RailEduKit/SigLab-3Dmodels/images/renders/balise_back.png

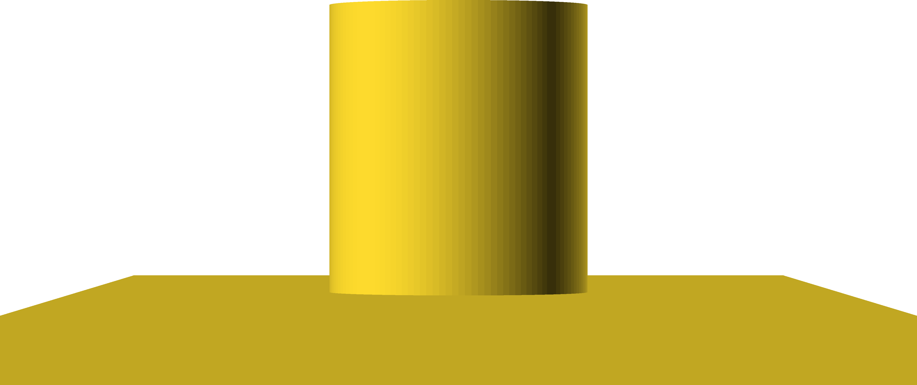
images/renders/balise_back.png
