RailEduKit/SigLab-3Dmodels/images/renders/balise_isometric.png

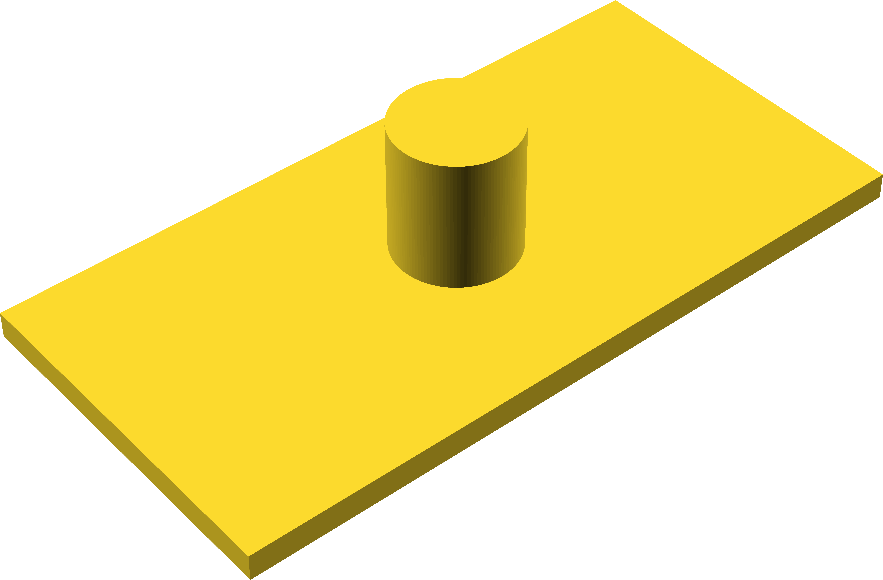
images/renders/balise_isometric.png
