RailEduKit/SigLab-3Dmodels/images/renders/balise_left.png

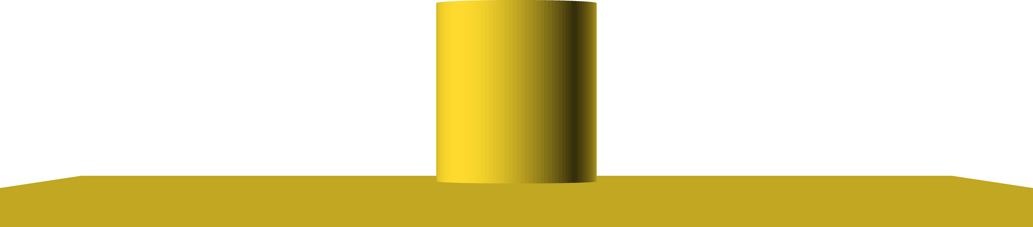
images/renders/balise_left.png
