RailEduKit/SigLab-3Dmodels/images/renders/checkbox_route_back.png

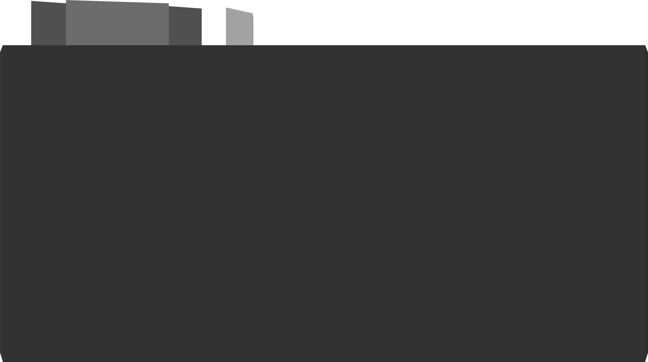
images/renders/checkbox_route_back.png
