RailEduKit/SigLab-3Dmodels/images/renders/checkbox_route_bottom.png

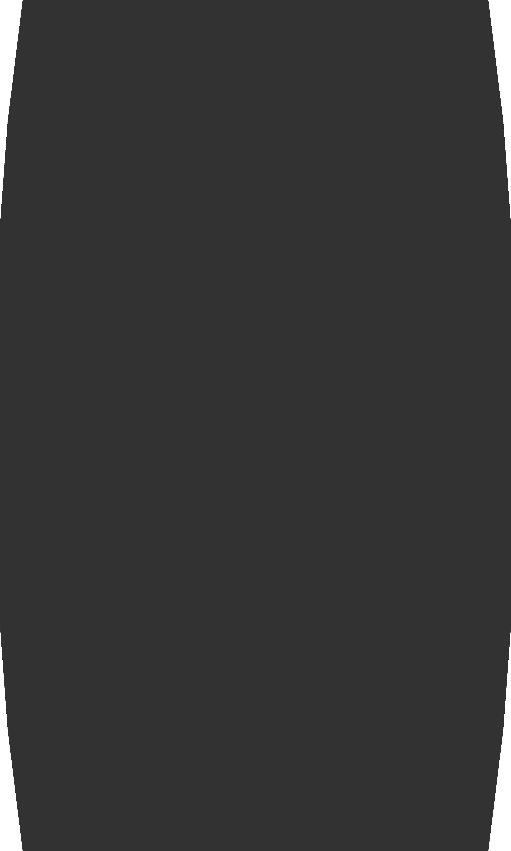
images/renders/checkbox_route_bottom.png
