RailEduKit/SigLab-3Dmodels/images/renders/checkbox_route_left.png

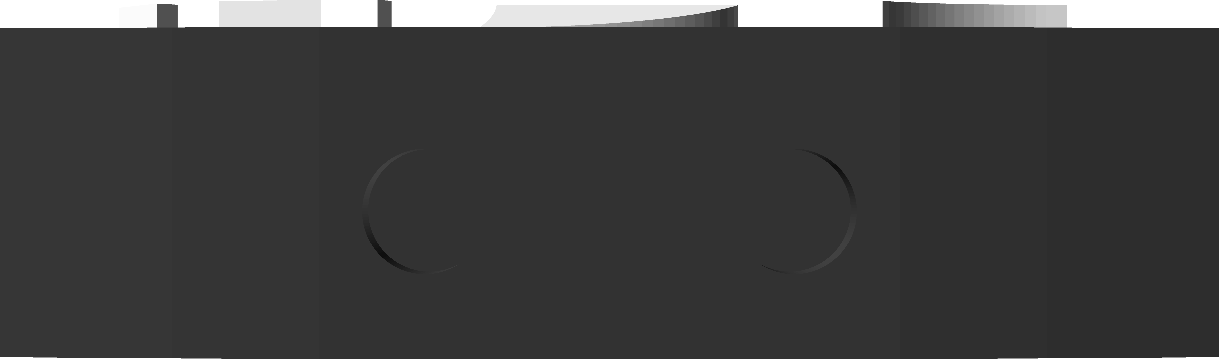
images/renders/checkbox_route_left.png
