RailEduKit/SigLab-3Dmodels/images/renders/checkbox_route_top.png

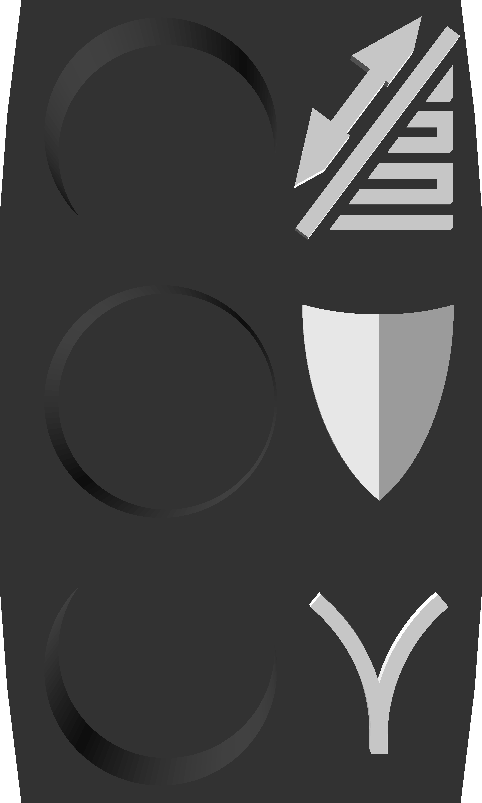
images/renders/checkbox_route_top.png
