RailEduKit/SigLab-3Dmodels/images/renders/clearing_point_block_back.png

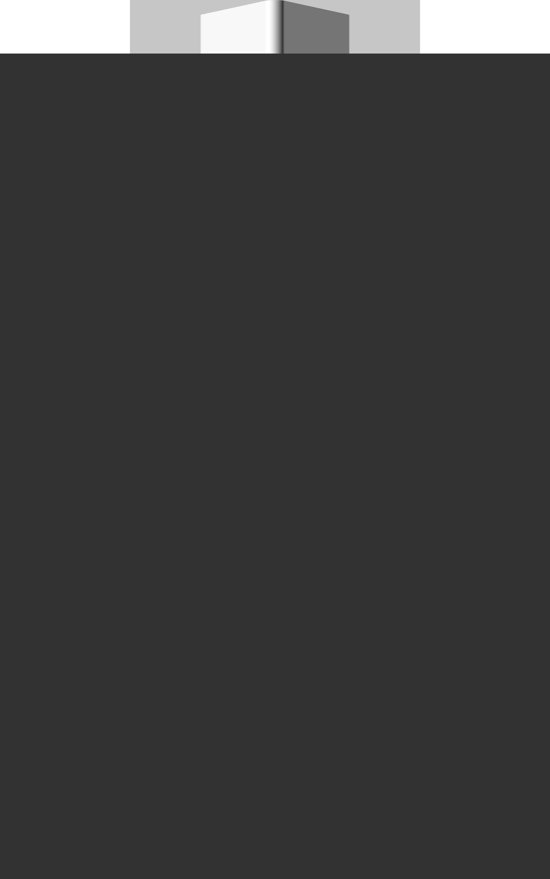
images/renders/clearing_point_block_back.png
