RailEduKit/SigLab-3Dmodels/images/renders/clearing_point_block_left.png

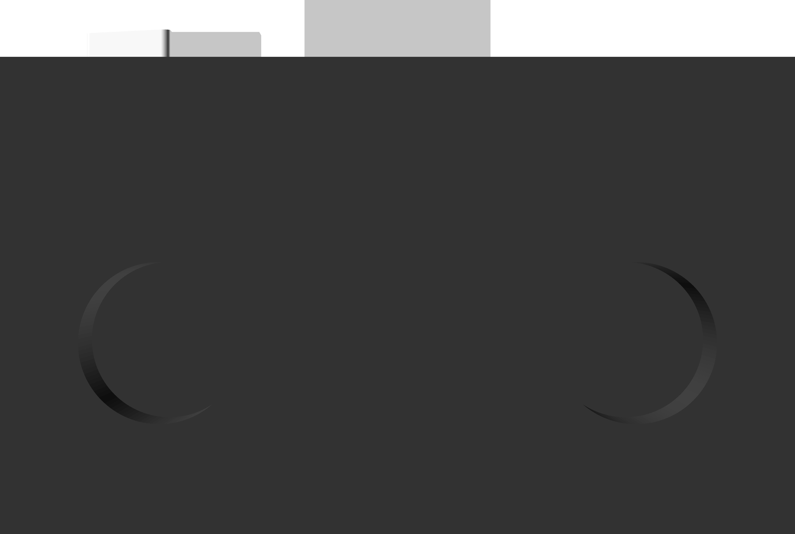
images/renders/clearing_point_block_left.png
