RailEduKit/SigLab-3Dmodels/images/renders/clearing_point_block_top.png

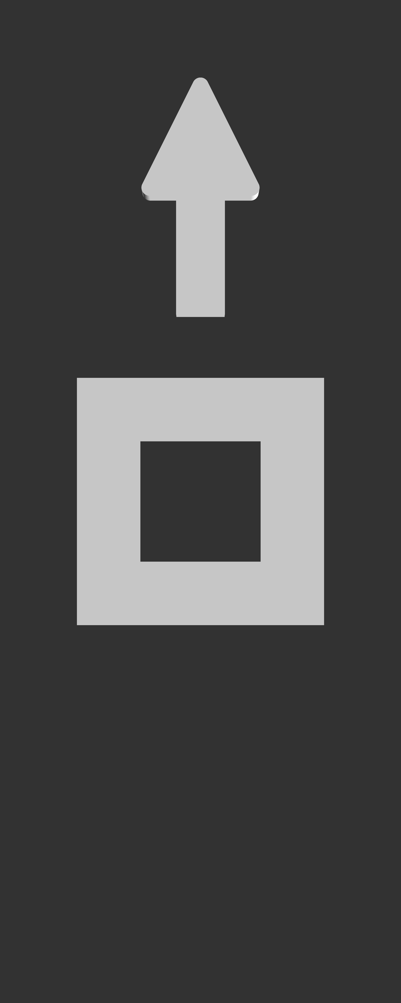
images/renders/clearing_point_block_top.png
