RailEduKit/SigLab-3Dmodels/images/renders/direction_management_all_positions_back.png

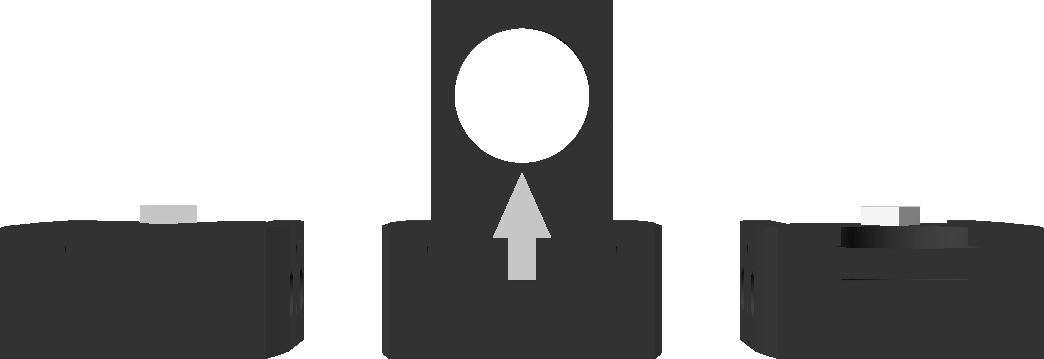
images/renders/direction_management_all_positions_back.png
