RailEduKit/SigLab-3Dmodels/images/renders/direction_management_all_positions_isometric.png

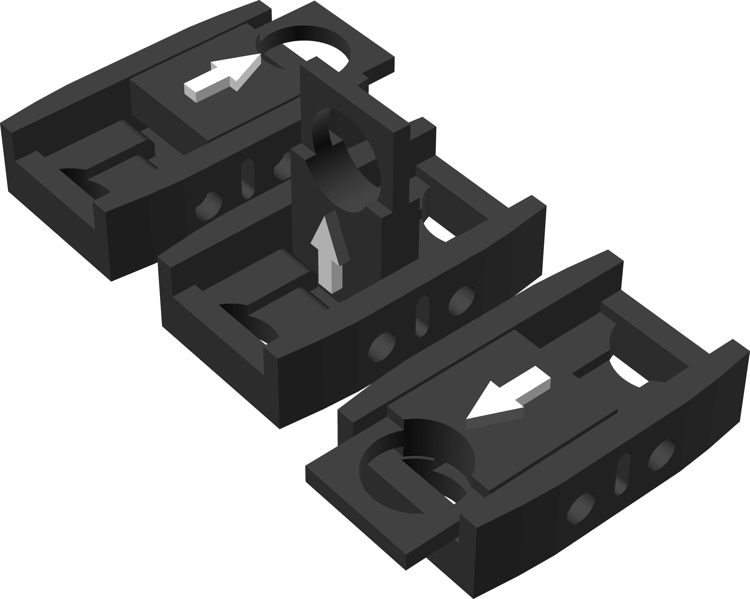
images/renders/direction_management_all_positions_isometric.png
