RailEduKit/SigLab-3Dmodels/images/renders/direction_management_all_positions_left.png

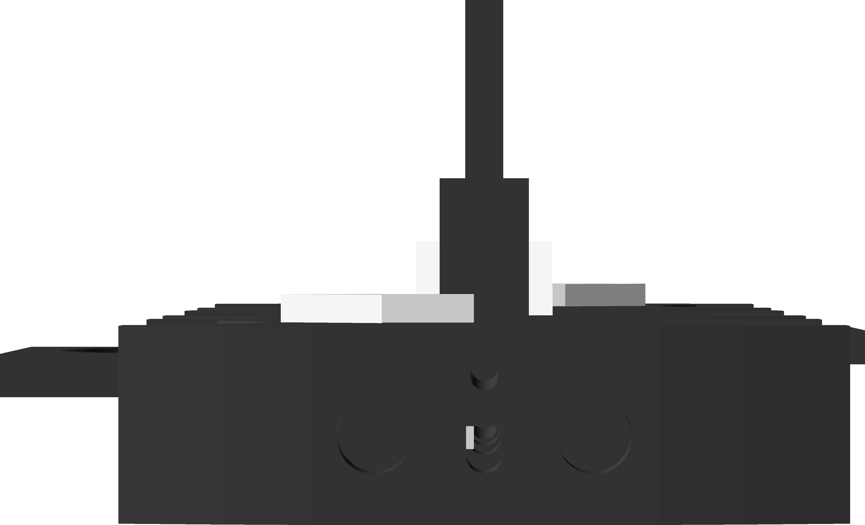
images/renders/direction_management_all_positions_left.png
