RailEduKit/SigLab-3Dmodels/images/renders/direction_management_back.png

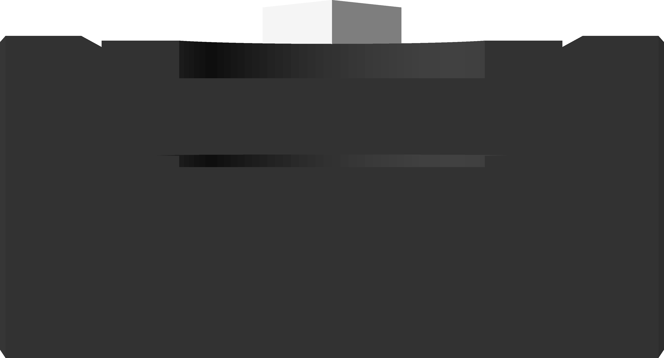
images/renders/direction_management_back.png
