RailEduKit/SigLab-3Dmodels/images/renders/direction_management_box_back.png

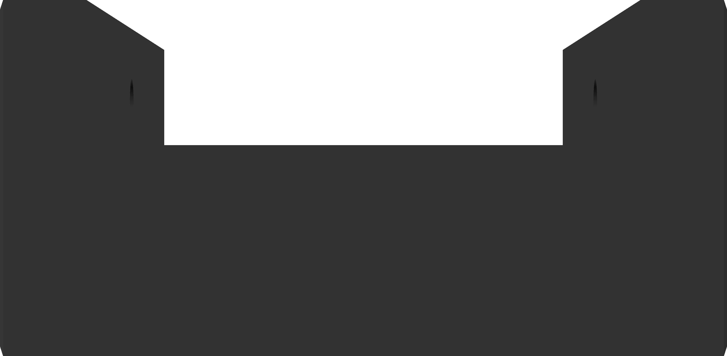
images/renders/direction_management_box_back.png
