RailEduKit/SigLab-3Dmodels/images/renders/direction_management_box_bottom.png

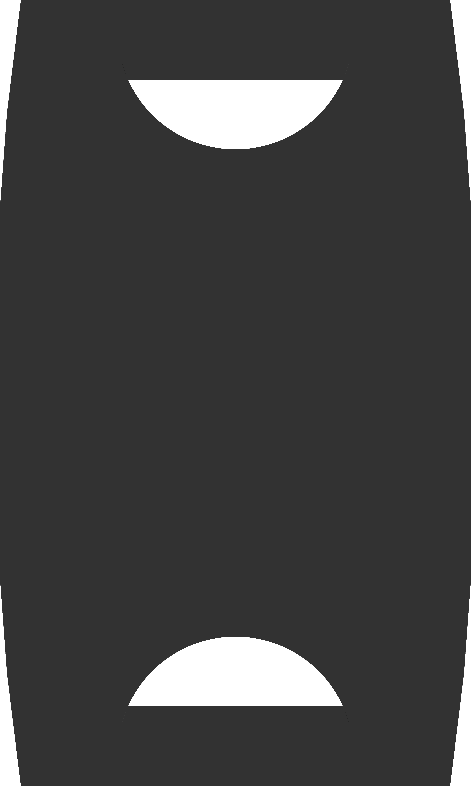
images/renders/direction_management_box_bottom.png
