RailEduKit/SigLab-3Dmodels/images/renders/direction_management_box_isometric.png

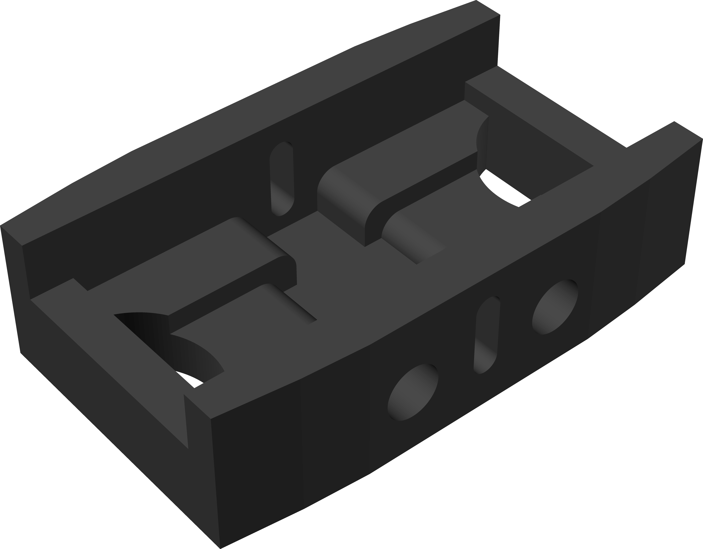
images/renders/direction_management_box_isometric.png
