RailEduKit/SigLab-3Dmodels/images/renders/direction_management_box_top.png

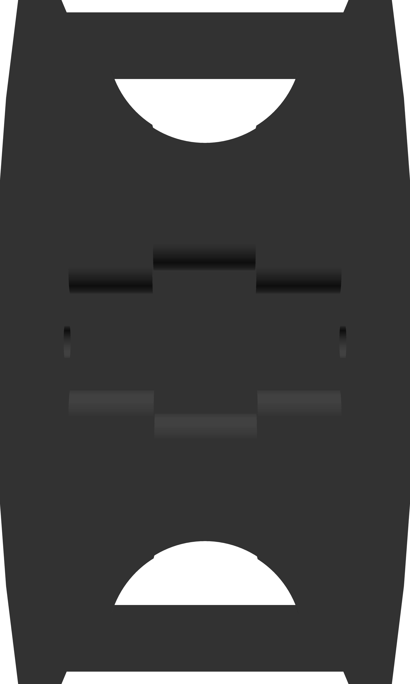
images/renders/direction_management_box_top.png
