RailEduKit/SigLab-3Dmodels/images/renders/direction_management_front.png

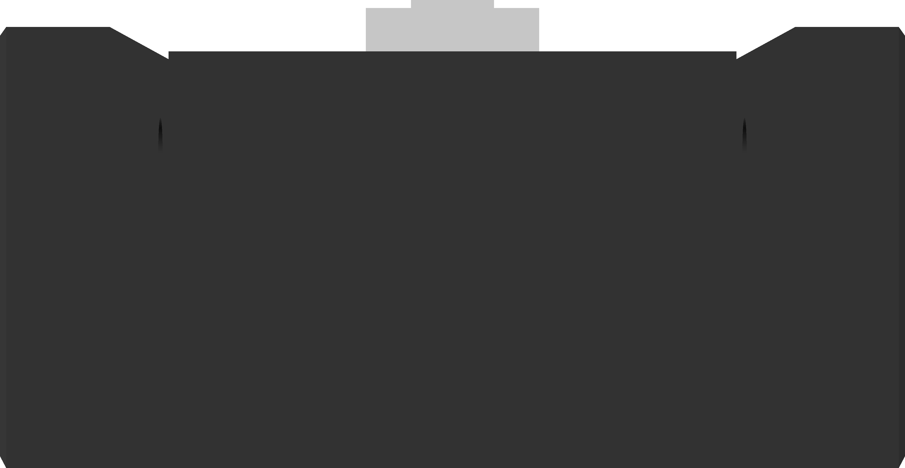
images/renders/direction_management_front.png
