RailEduKit/SigLab-3Dmodels/images/renders/direction_management_left.png

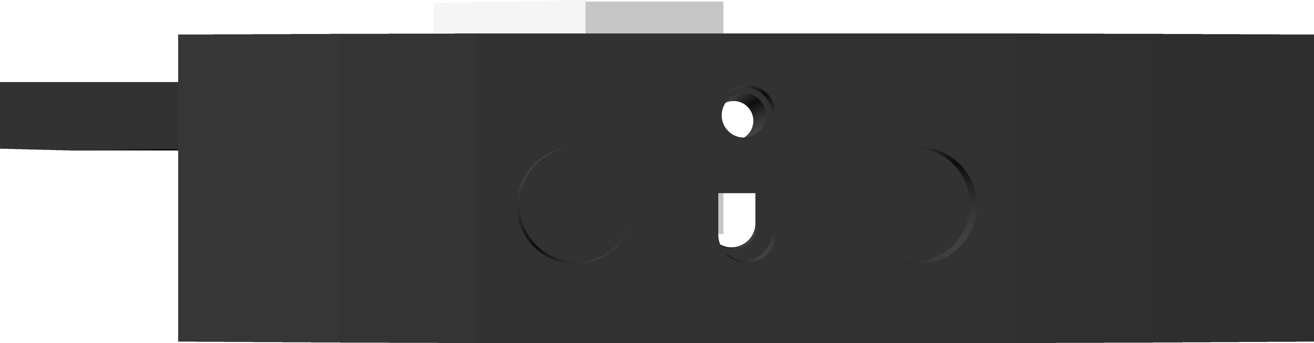
images/renders/direction_management_left.png
