RailEduKit/SigLab-3Dmodels/images/renders/direction_management_lever_back.png

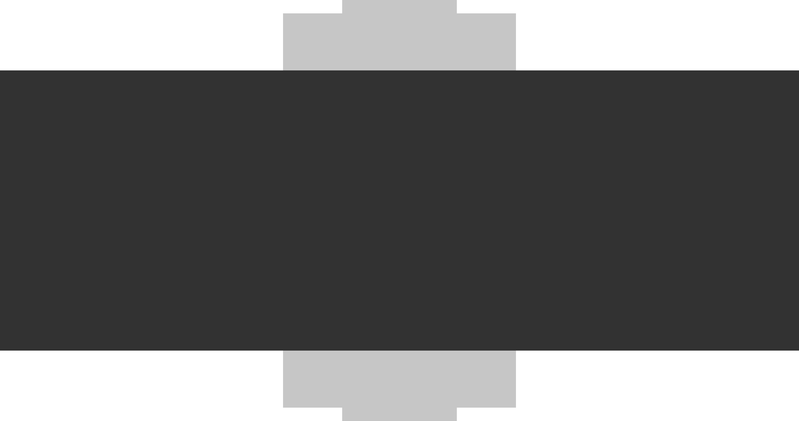
images/renders/direction_management_lever_back.png
