RailEduKit/SigLab-3Dmodels/images/renders/direction_management_lever_bottom.png

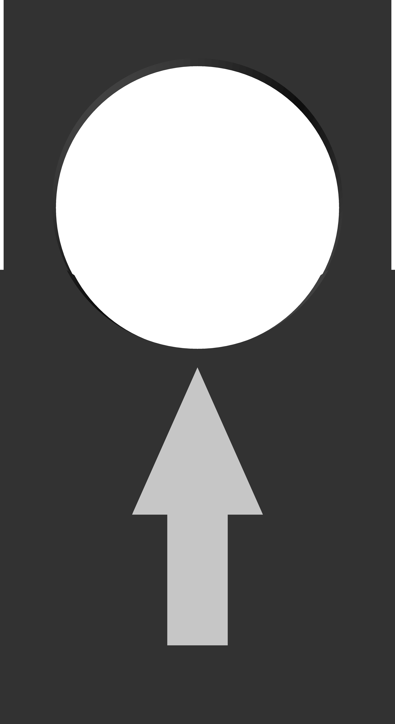
images/renders/direction_management_lever_bottom.png
