RailEduKit/SigLab-3Dmodels/images/renders/direction_management_lever_front.png

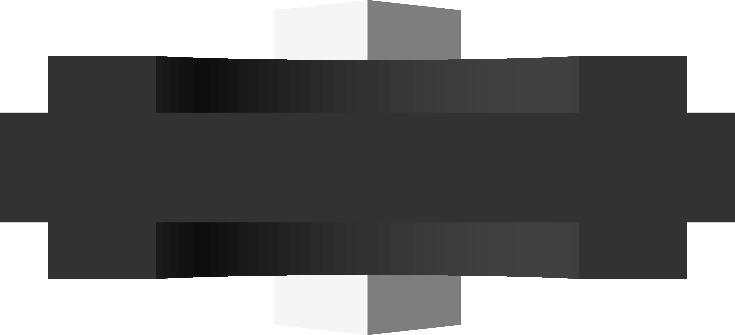
images/renders/direction_management_lever_front.png
