RailEduKit/SigLab-3Dmodels/images/renders/direction_management_lever_isometric.png

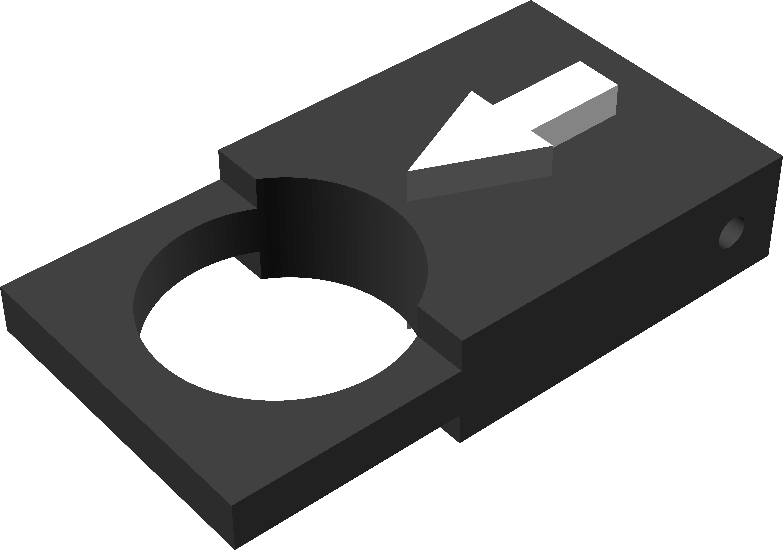
images/renders/direction_management_lever_isometric.png
