RailEduKit/SigLab-3Dmodels/images/renders/direction_management_lever_top.png

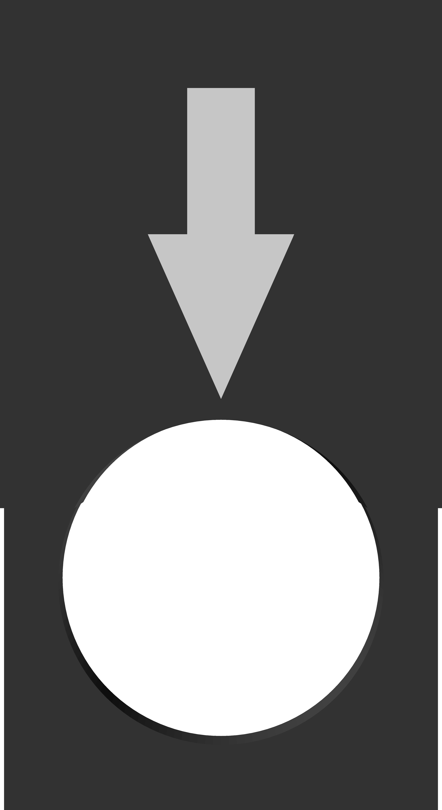
images/renders/direction_management_lever_top.png
