RailEduKit/SigLab-3Dmodels/images/renders/direction_management_right.png

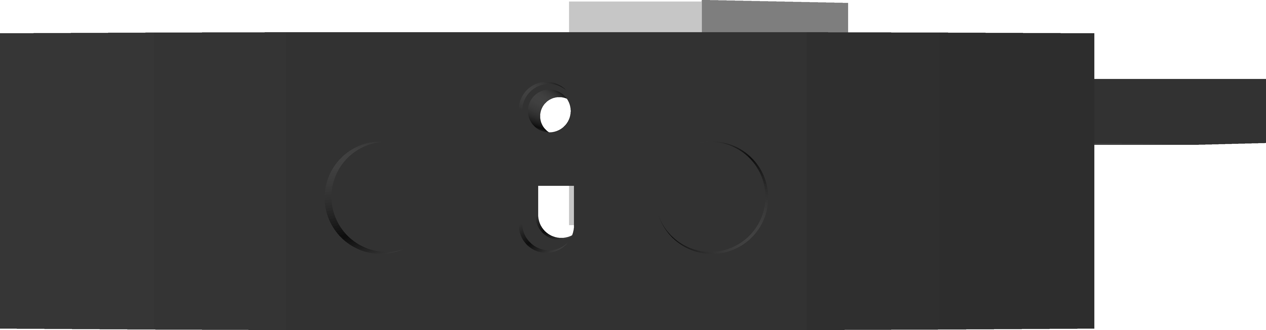
images/renders/direction_management_right.png
