RailEduKit/SigLab-3Dmodels/images/renders/direction_management_top.png

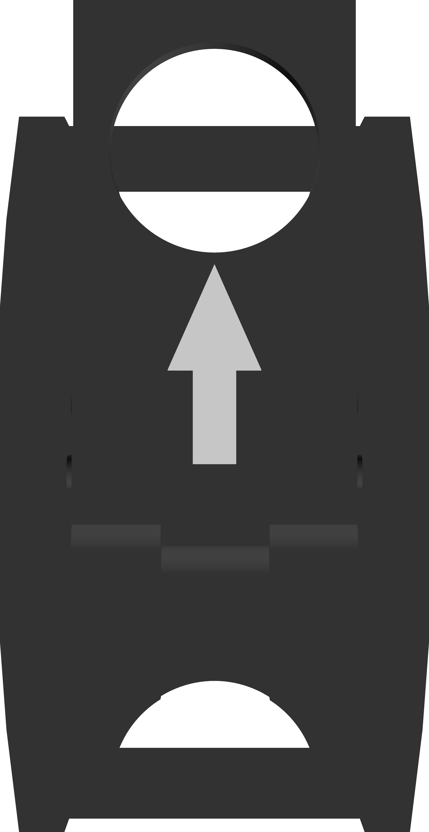
images/renders/direction_management_top.png
