RailEduKit/SigLab-3Dmodels/images/renders/direction_management_with_locker_front.png

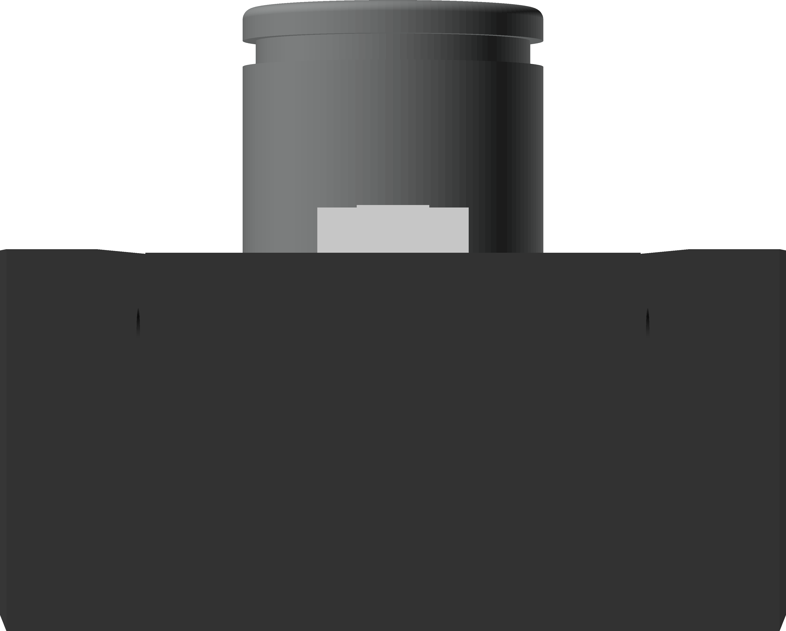
images/renders/direction_management_with_locker_front.png
