RailEduKit/SigLab-3Dmodels/images/renders/direction_management_with_locker_left.png

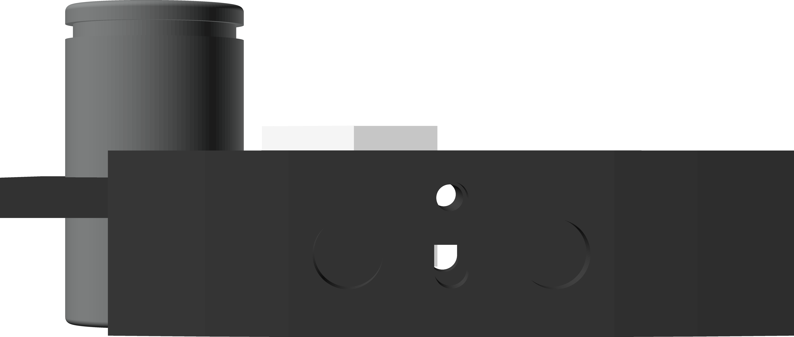
images/renders/direction_management_with_locker_left.png
