RailEduKit/SigLab-3Dmodels/images/renders/locking_pin_back.png

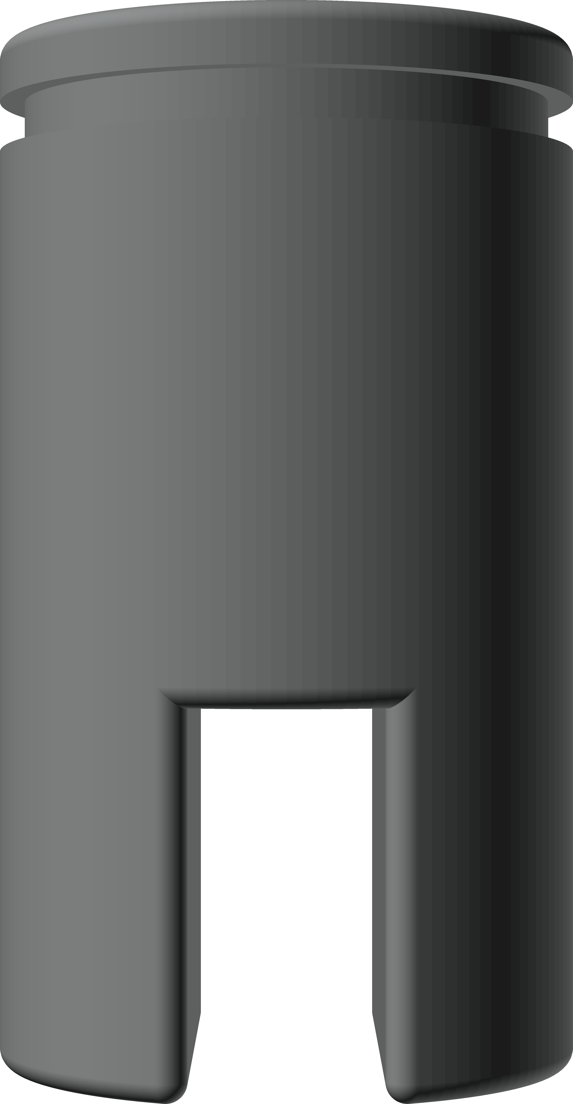
images/renders/locking_pin_back.png
