RailEduKit/SigLab-3Dmodels/images/renders/locking_pin_bottom.png

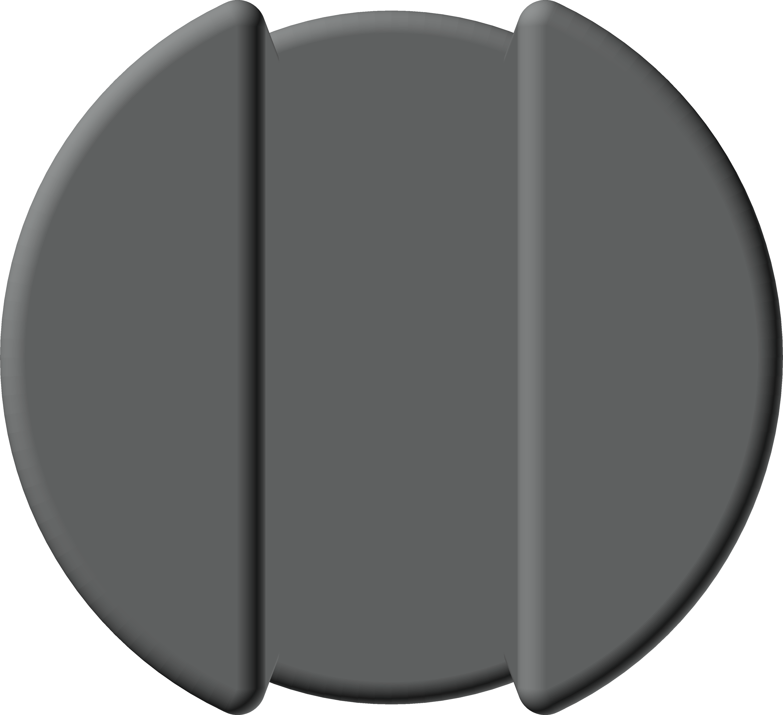
images/renders/locking_pin_bottom.png
