RailEduKit/SigLab-3Dmodels/images/renders/locking_pin_left.png

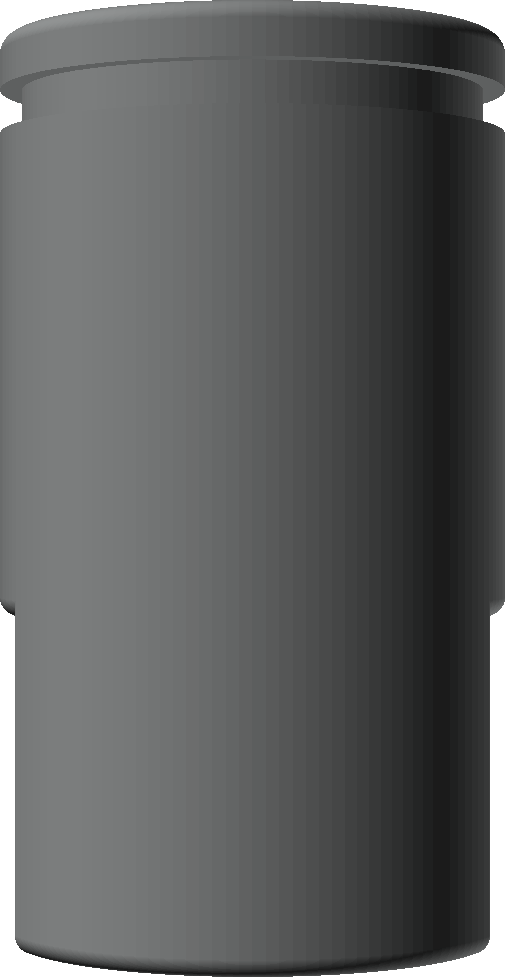
images/renders/locking_pin_left.png
