RailEduKit/SigLab-3Dmodels/images/renders/locking_pin_top.png

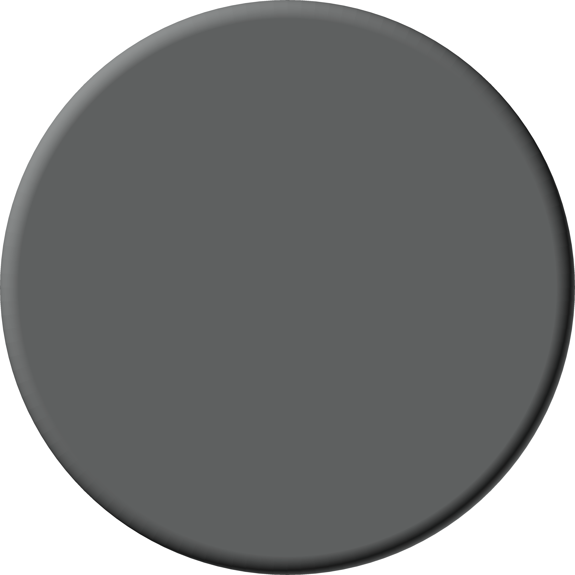
images/renders/locking_pin_top.png
