RailEduKit/SigLab-3Dmodels/images/renders/overlap_body_curve_back.png

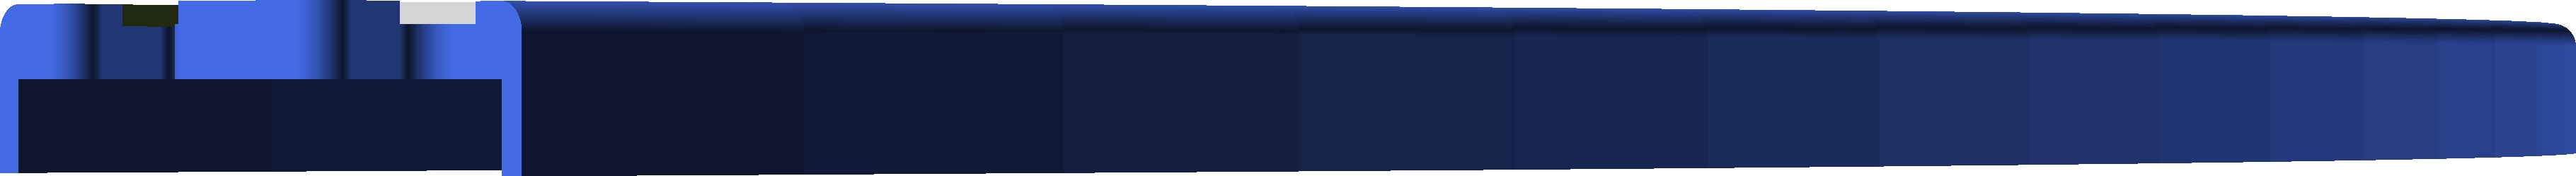
images/renders/overlap_body_curve_back.png
