RailEduKit/SigLab-3Dmodels/images/renders/overlap_body_curve_bottom.png

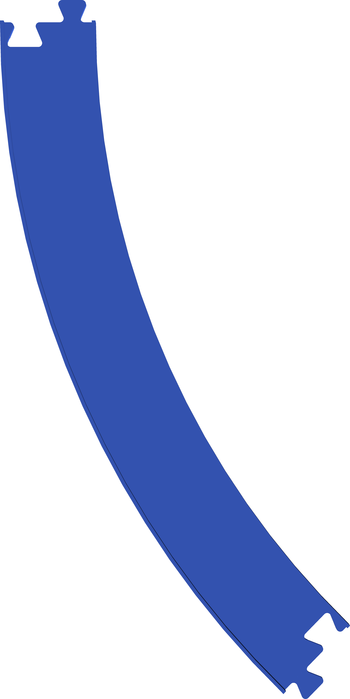
images/renders/overlap_body_curve_bottom.png
