RailEduKit/SigLab-3Dmodels/images/renders/overlap_body_curve_front.png

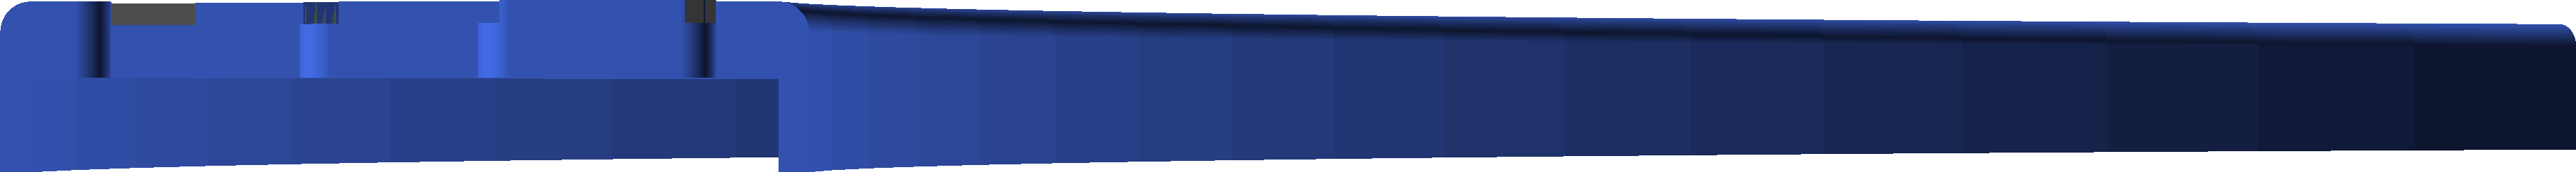
images/renders/overlap_body_curve_front.png
