RailEduKit/SigLab-3Dmodels/images/renders/overlap_body_curve_isometric.png

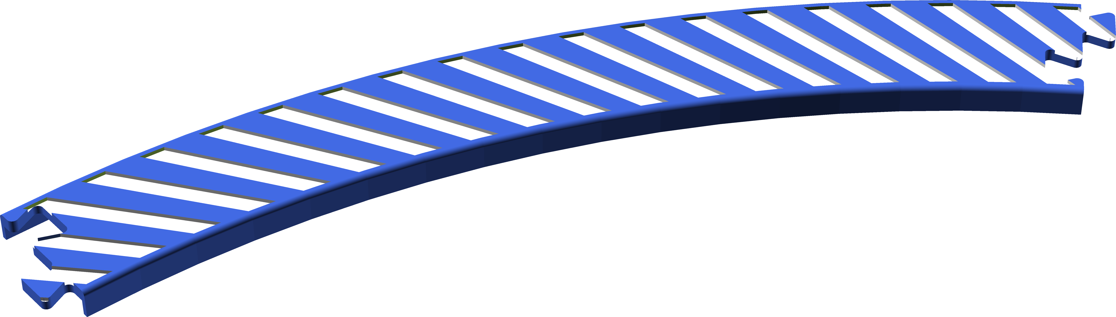
images/renders/overlap_body_curve_isometric.png
