RailEduKit/SigLab-3Dmodels/images/renders/overlap_body_curve_left.png

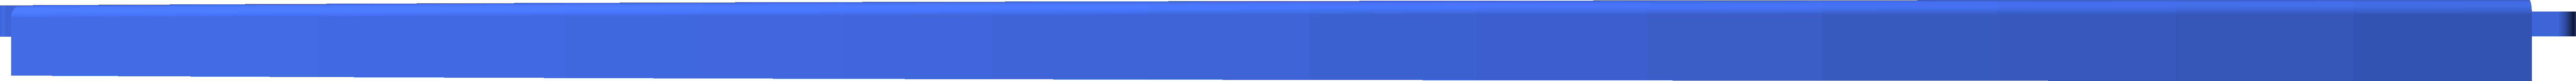
images/renders/overlap_body_curve_left.png
