RailEduKit/SigLab-3Dmodels/images/renders/overlap_body_curve_right.png

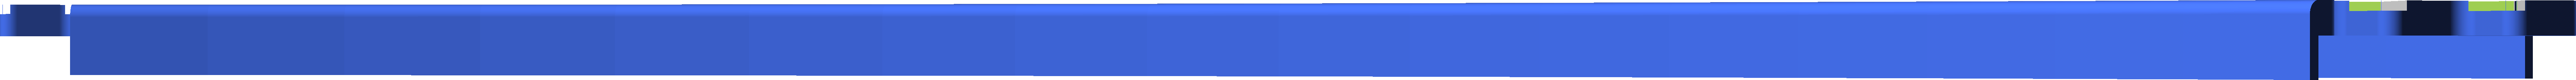
images/renders/overlap_body_curve_right.png
