RailEduKit/SigLab-3Dmodels/images/renders/overlap_body_curve_top.png

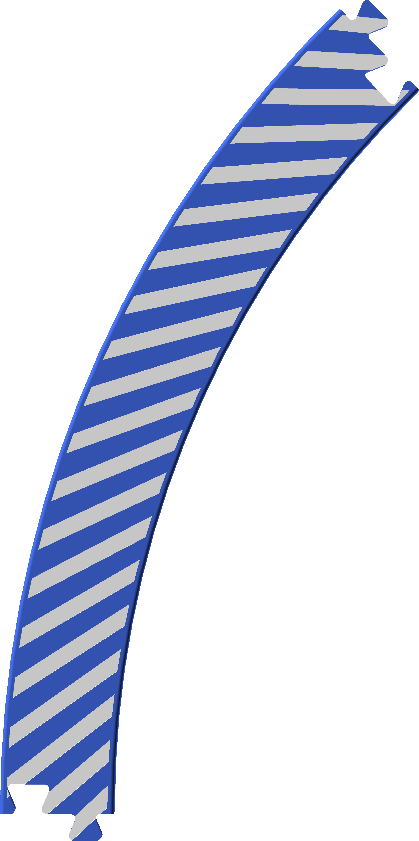
images/renders/overlap_body_curve_top.png
