RailEduKit/SigLab-3Dmodels/images/renders/overlap_body_straight_back.png

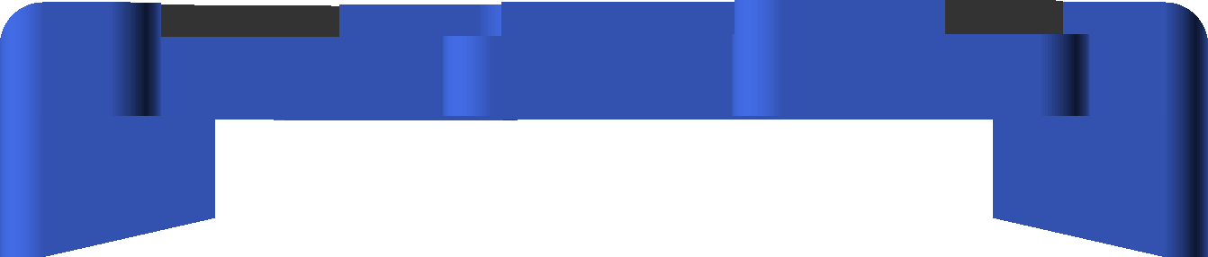
images/renders/overlap_body_straight_back.png
