RailEduKit/SigLab-3Dmodels/images/renders/overlap_body_straight_bottom.png

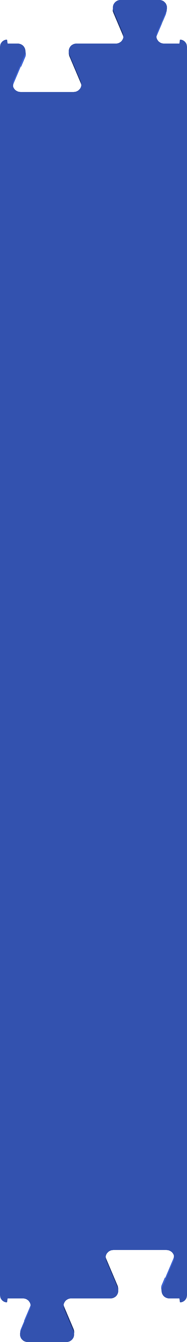
images/renders/overlap_body_straight_bottom.png
