RailEduKit/SigLab-3Dmodels/images/renders/overlap_body_straight_isometric.png

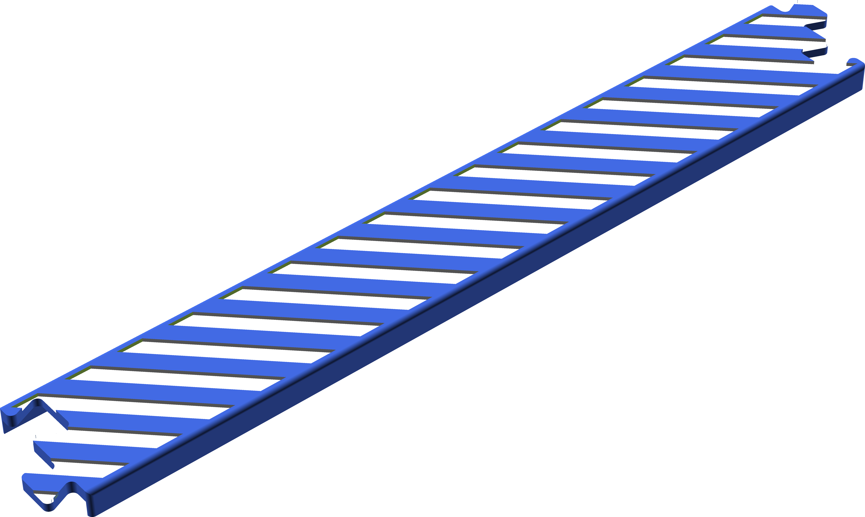
images/renders/overlap_body_straight_isometric.png
