RailEduKit/SigLab-3Dmodels/images/renders/overlap_body_straight_top.png

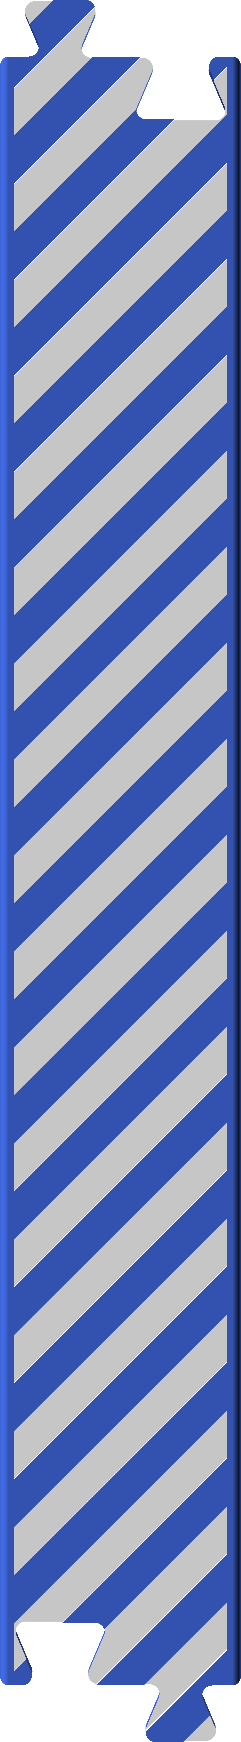
images/renders/overlap_body_straight_top.png
