RailEduKit/SigLab-3Dmodels/images/renders/overlap_pattern_curve_bottom.png

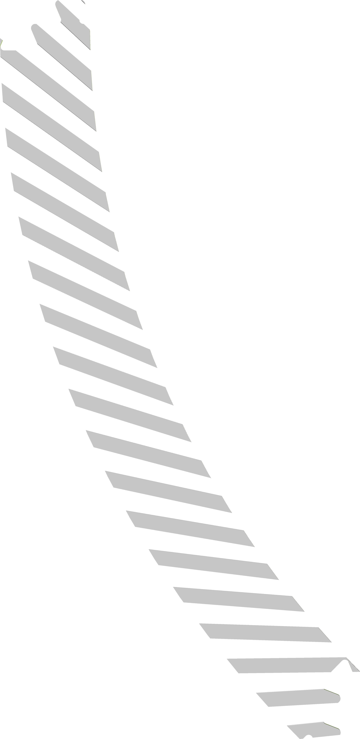
images/renders/overlap_pattern_curve_bottom.png
