RailEduKit/SigLab-3Dmodels/images/renders/overlap_pattern_curve_isometric.png

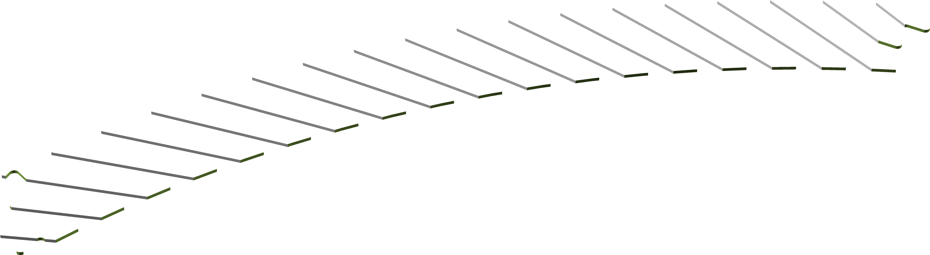
images/renders/overlap_pattern_curve_isometric.png
