RailEduKit/SigLab-3Dmodels/images/renders/overlap_pattern_curve_top.png

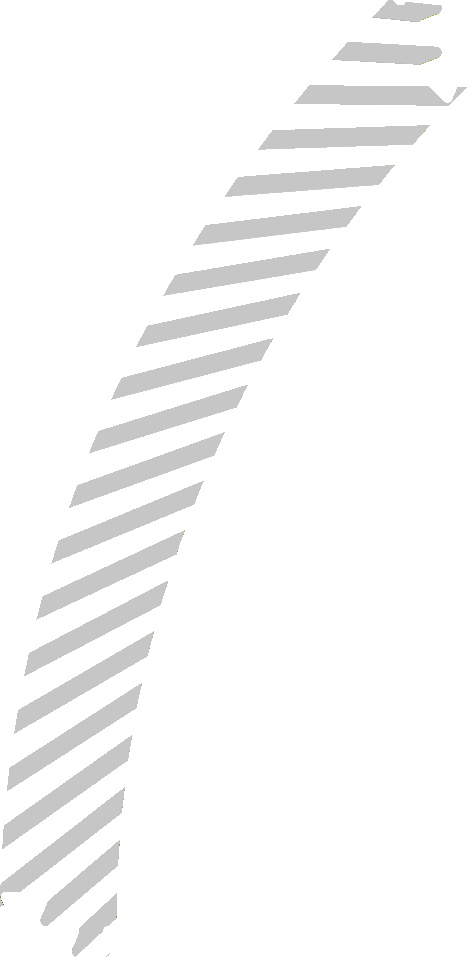
images/renders/overlap_pattern_curve_top.png
