RailEduKit/SigLab-3Dmodels/images/renders/overlap_pattern_straight_bottom.png

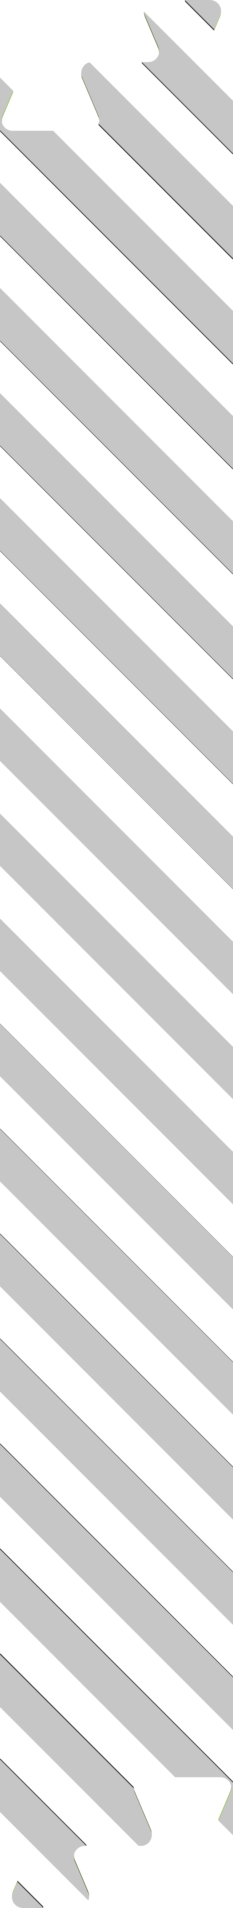
images/renders/overlap_pattern_straight_bottom.png
