RailEduKit/SigLab-3Dmodels/images/renders/overlap_pattern_straight_isometric.png

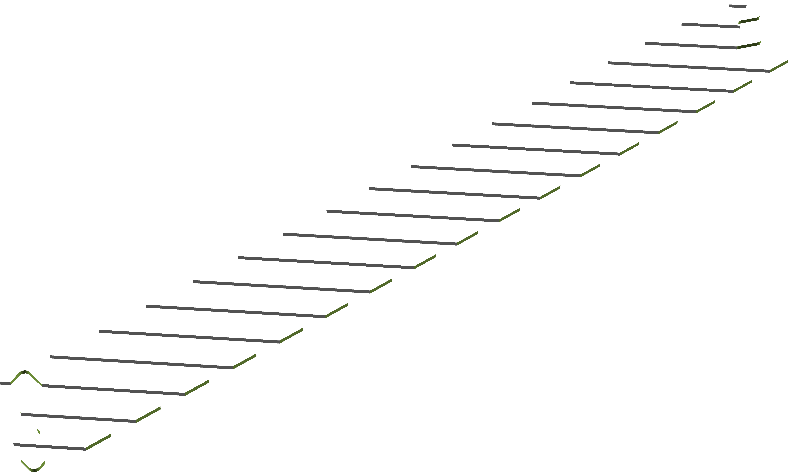
images/renders/overlap_pattern_straight_isometric.png
