RailEduKit/SigLab-3Dmodels/images/renders/overlap_pattern_straight_top.png

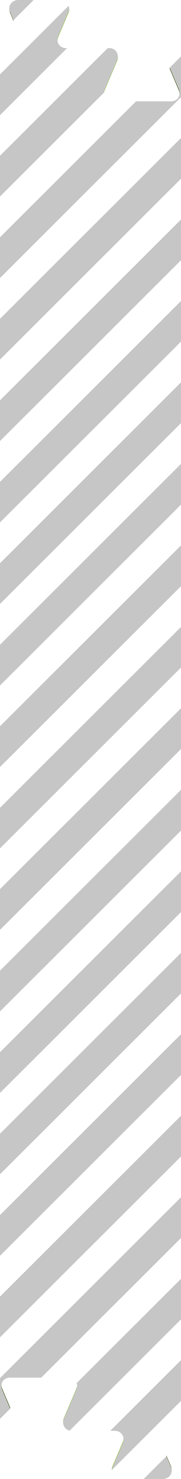
images/renders/overlap_pattern_straight_top.png
