RailEduKit/SigLab-3Dmodels/images/renders/position_indicator_back.png

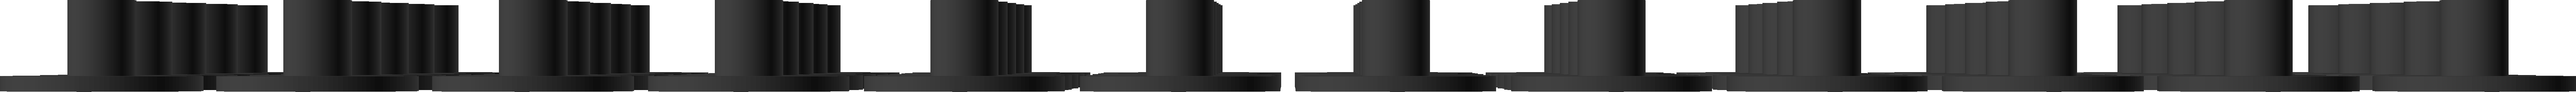
images/renders/position_indicator_back.png
