RailEduKit/SigLab-3Dmodels/images/renders/position_indicator_left.png

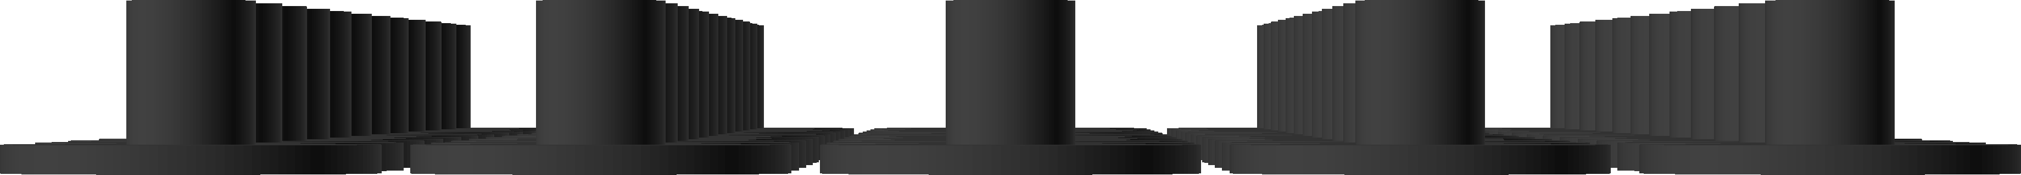
images/renders/position_indicator_left.png
