RailEduKit/SigLab-3Dmodels/images/renders/position_indicator_number_isometric.png

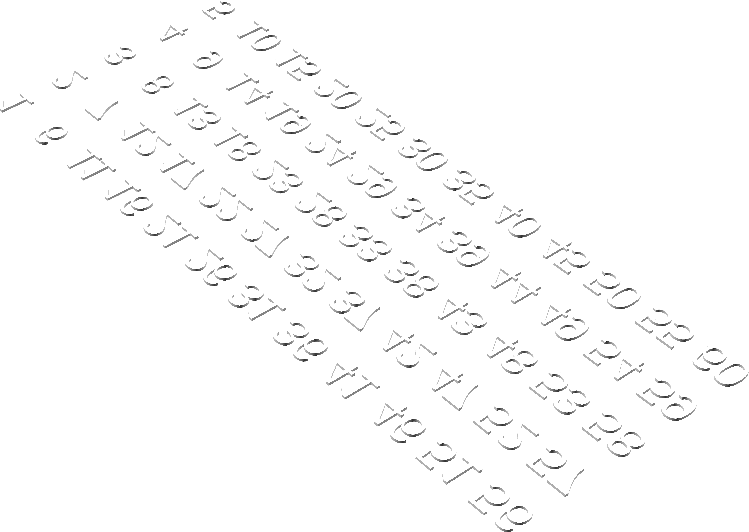
images/renders/position_indicator_number_isometric.png
