RailEduKit/SigLab-3Dmodels/images/renders/position_indicator_number_top.png

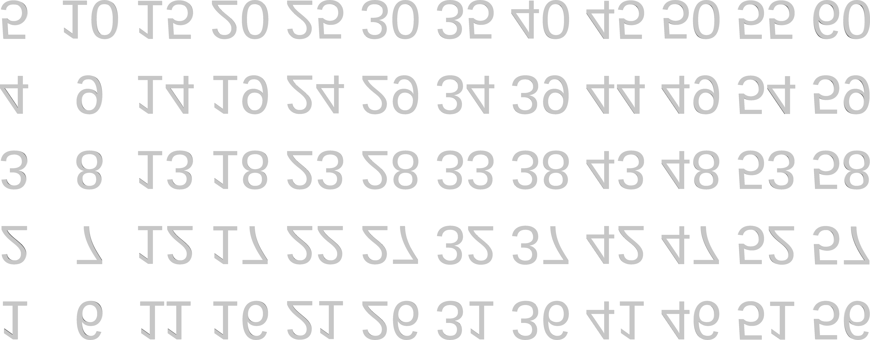
images/renders/position_indicator_number_top.png
