RailEduKit/SigLab-3Dmodels/images/renders/position_indicator_plate_bottom.png

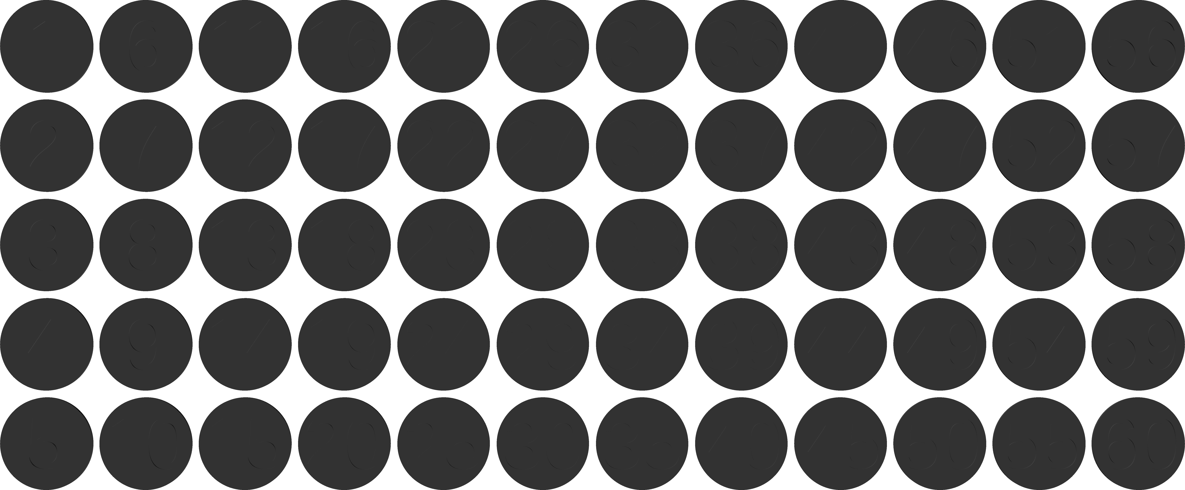
images/renders/position_indicator_plate_bottom.png
