RailEduKit/SigLab-3Dmodels/images/renders/signal_block_all_positions_back.png

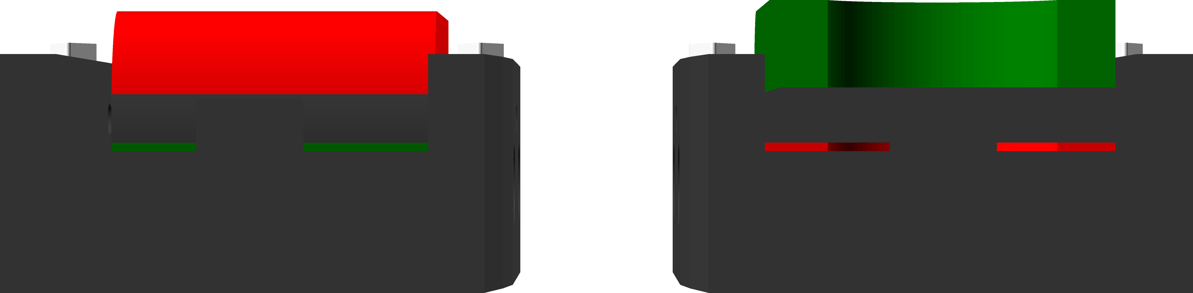
images/renders/signal_block_all_positions_back.png
