RailEduKit/SigLab-3Dmodels/images/renders/signal_block_back.png

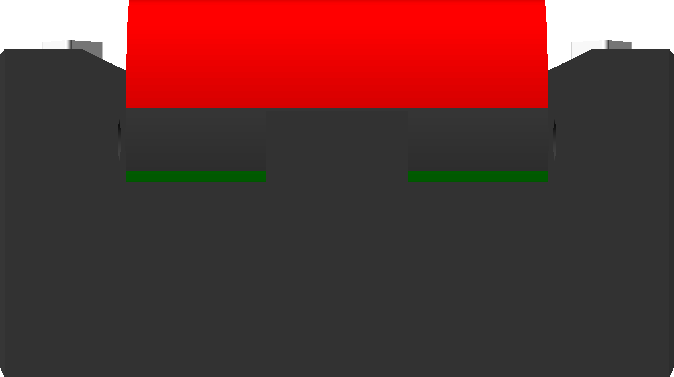
images/renders/signal_block_back.png
