RailEduKit/SigLab-3Dmodels/images/renders/signal_block_bottom.png

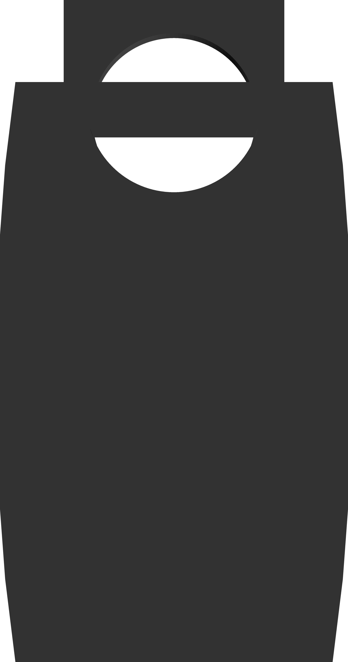
images/renders/signal_block_bottom.png
