RailEduKit/SigLab-3Dmodels/images/renders/signal_block_front.png

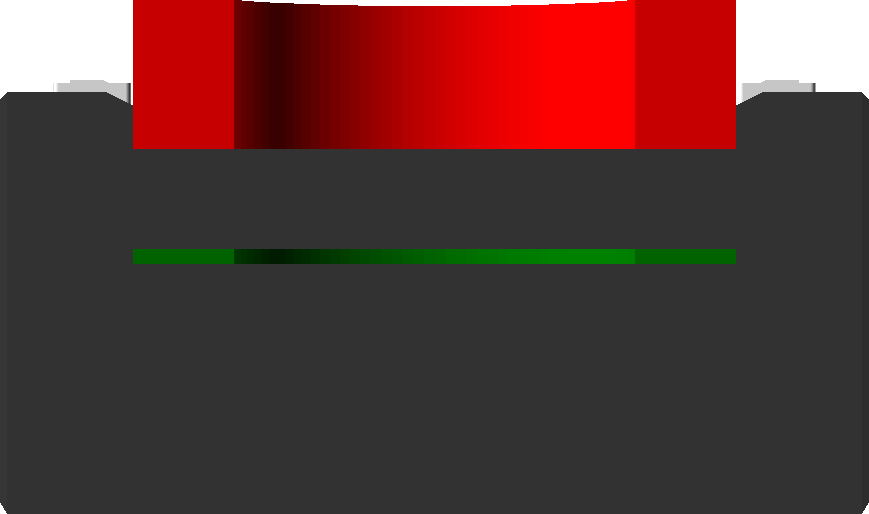
images/renders/signal_block_front.png
