RailEduKit/SigLab-3Dmodels/images/renders/signal_block_left.png

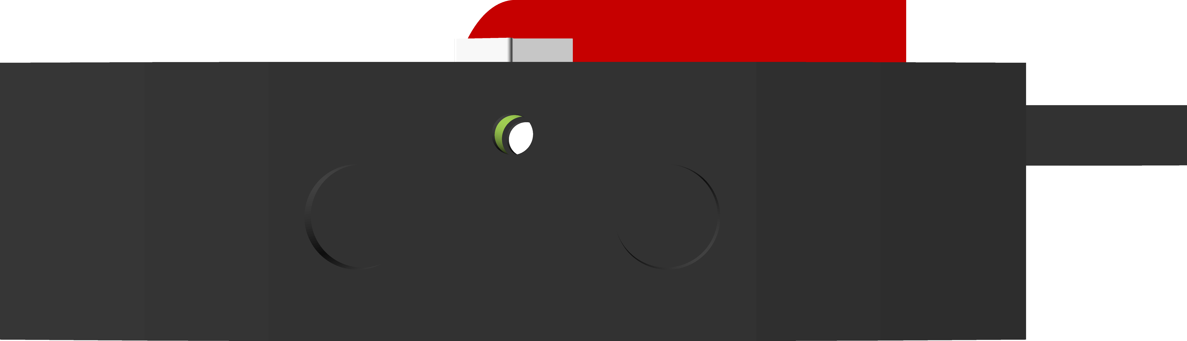
images/renders/signal_block_left.png
