RailEduKit/SigLab-3Dmodels/images/renders/signal_block_right.png

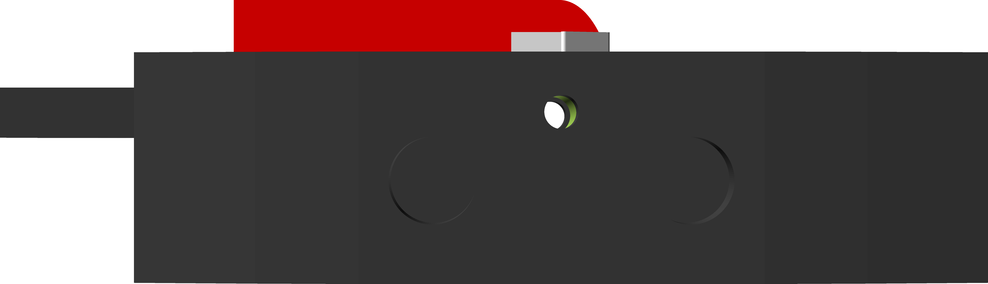
images/renders/signal_block_right.png
