RailEduKit/SigLab-3Dmodels/images/renders/signal_block_top.png

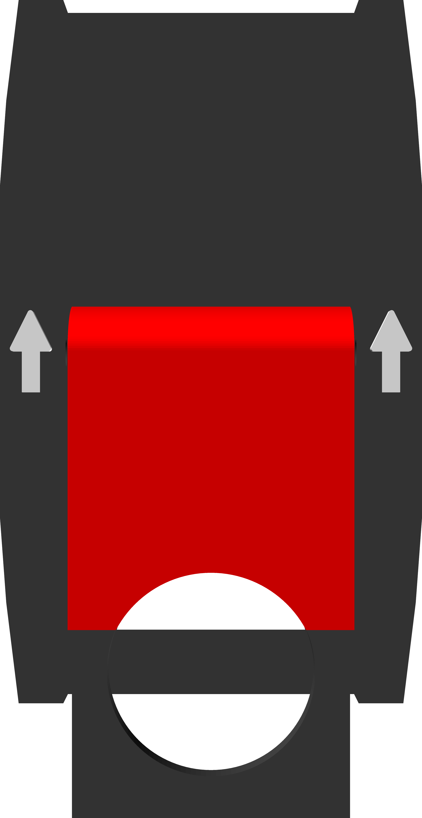
images/renders/signal_block_top.png
