RailEduKit/SigLab-3Dmodels/images/renders/signal_block_with_locker_back.png

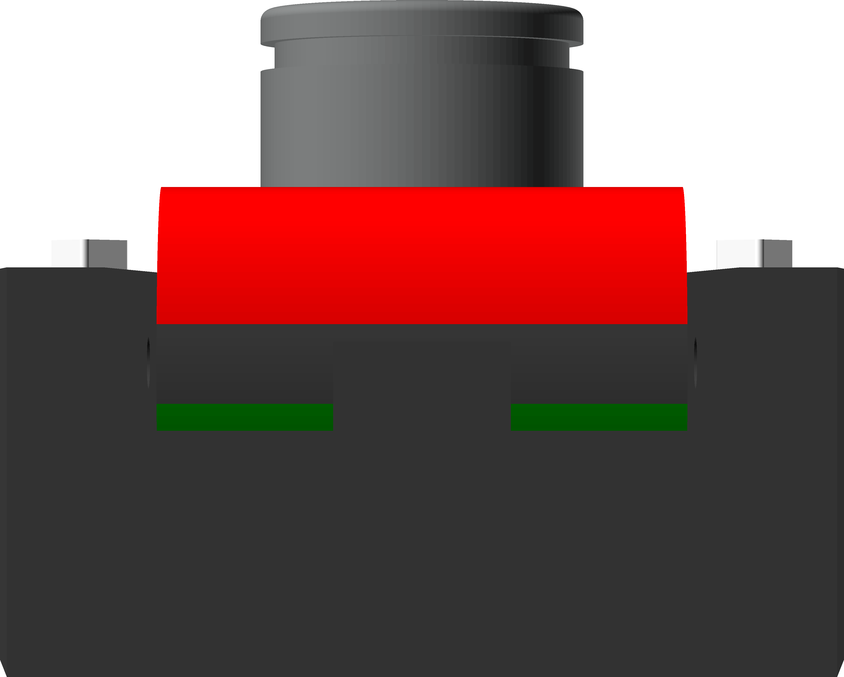
images/renders/signal_block_with_locker_back.png
