RailEduKit/SigLab-3Dmodels/images/renders/signal_block_with_locker_front.png

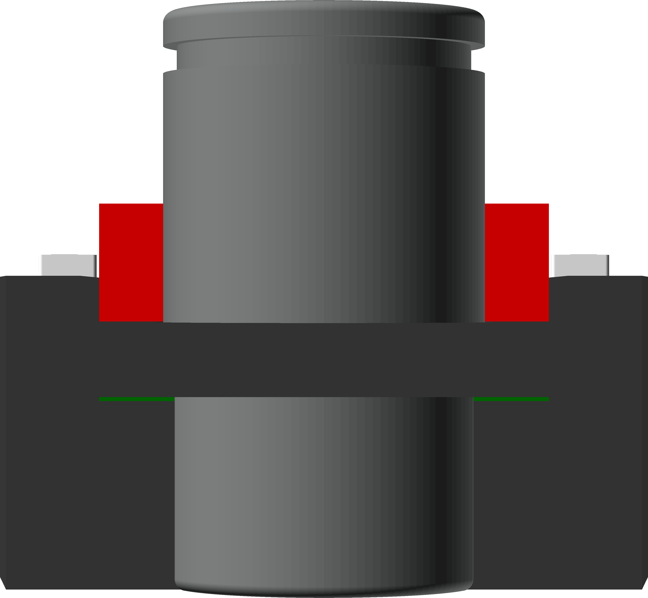
images/renders/signal_block_with_locker_front.png
