RailEduKit/SigLab-3Dmodels/images/renders/signal_box_block_back.png

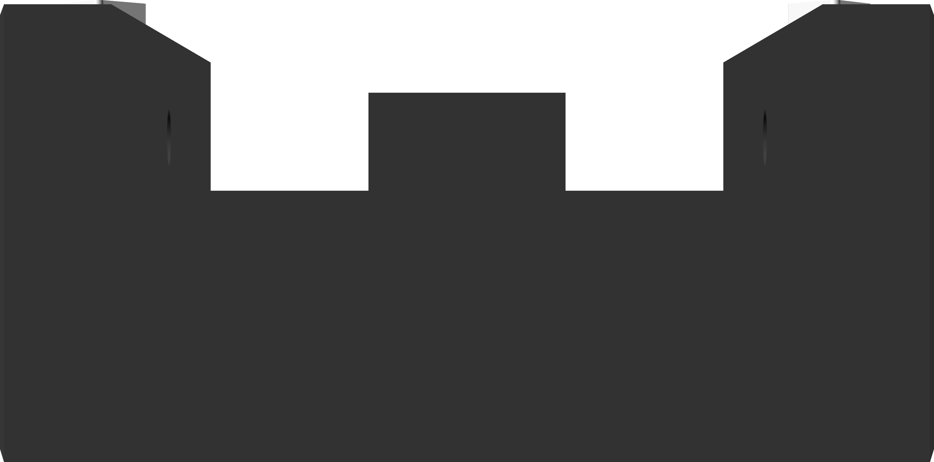
images/renders/signal_box_block_back.png
