RailEduKit/SigLab-3Dmodels/images/renders/signal_box_block_isometric.png

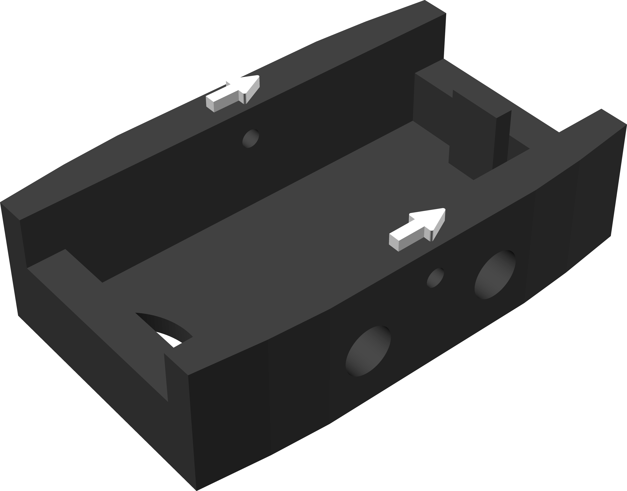
images/renders/signal_box_block_isometric.png
