RailEduKit/SigLab-3Dmodels/images/renders/signal_box_block_left.png

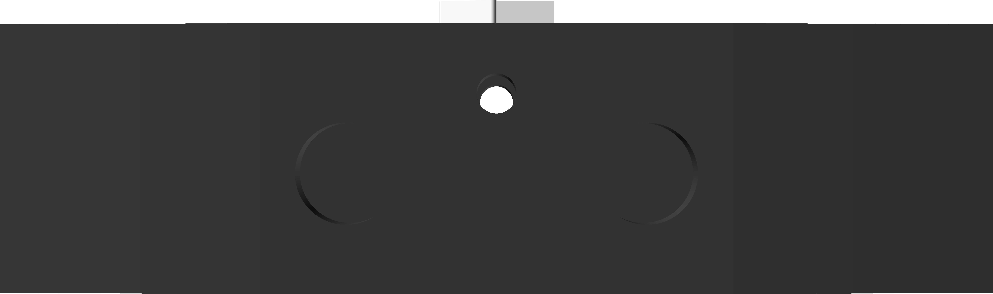
images/renders/signal_box_block_left.png
