RailEduKit/SigLab-3Dmodels/images/renders/signal_box_block_top.png

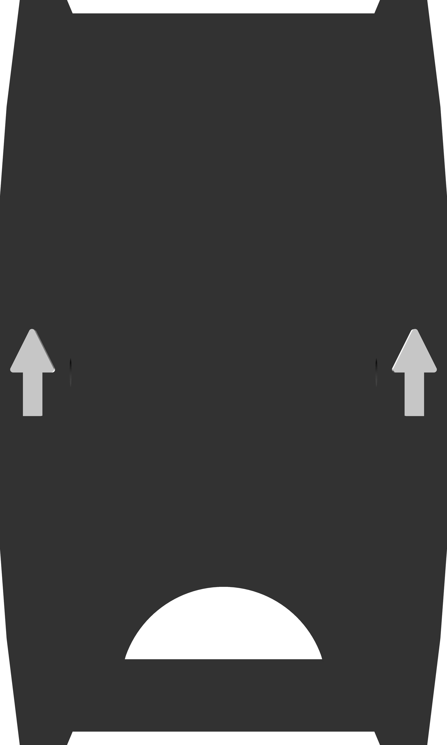
images/renders/signal_box_block_top.png
