RailEduKit/SigLab-3Dmodels/images/renders/signal_box_distant_top.png

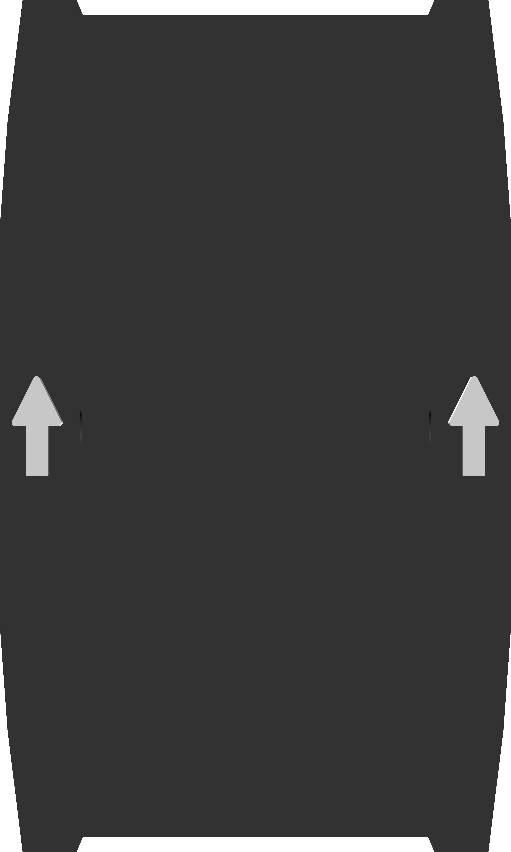
images/renders/signal_box_distant_top.png
