RailEduKit/SigLab-3Dmodels/images/renders/signal_distant_all_positions_back.png

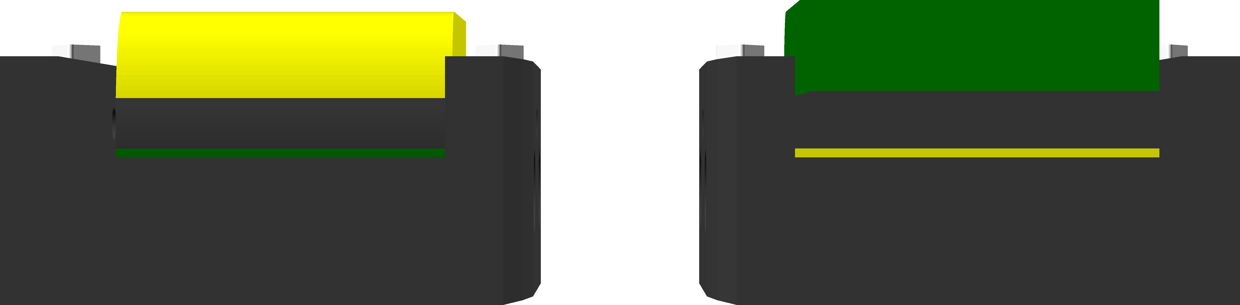
images/renders/signal_distant_all_positions_back.png
