RailEduKit/SigLab-3Dmodels/images/renders/signal_distant_all_positions_bottom.png

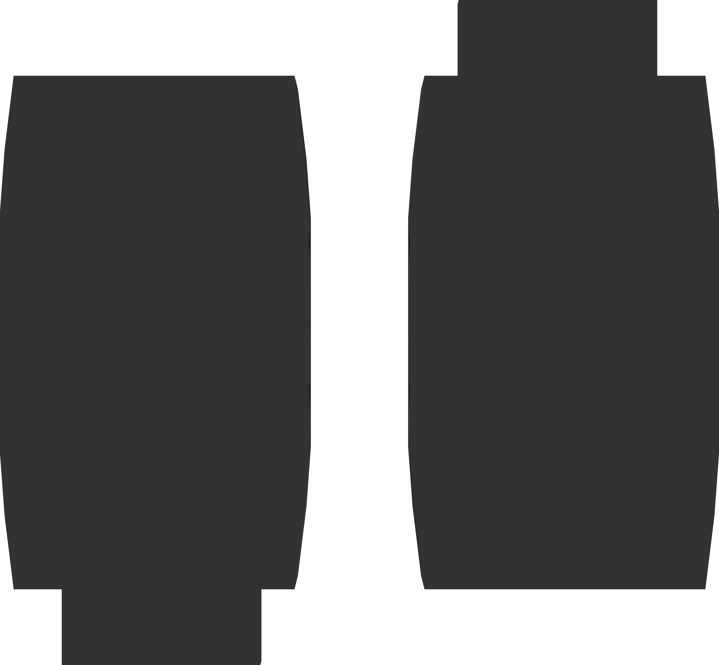
images/renders/signal_distant_all_positions_bottom.png
