RailEduKit/SigLab-3Dmodels/images/renders/signal_distant_all_positions_front.png

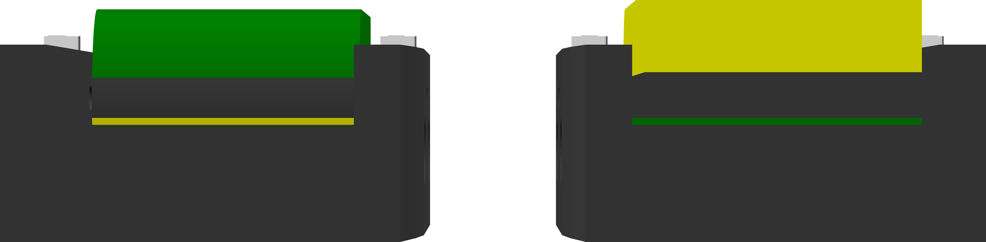
images/renders/signal_distant_all_positions_front.png
