RailEduKit/SigLab-3Dmodels/images/renders/signal_distant_all_positions_isometric.png

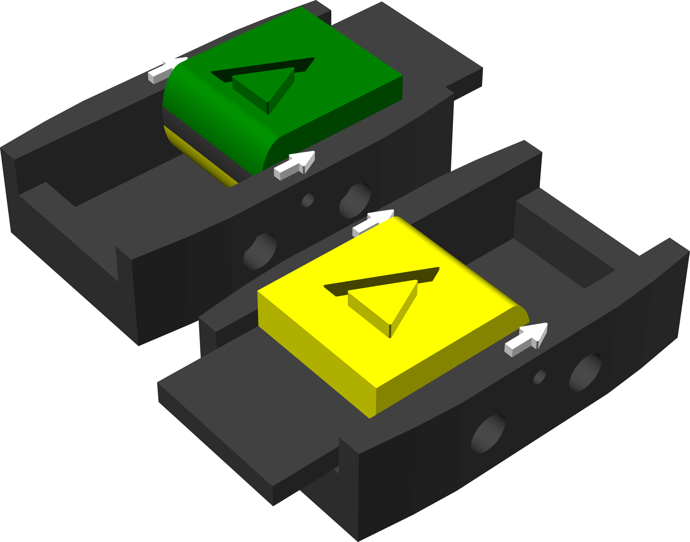
images/renders/signal_distant_all_positions_isometric.png
