RailEduKit/SigLab-3Dmodels/images/renders/signal_distant_front.png

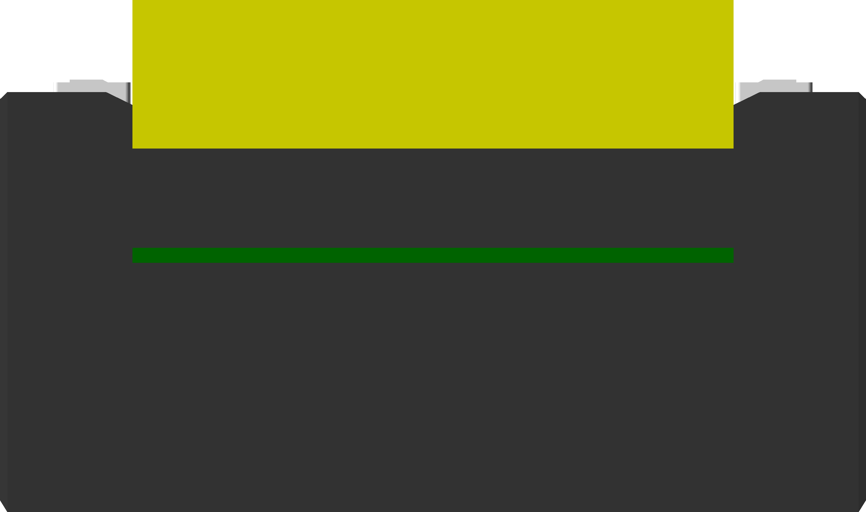
images/renders/signal_distant_front.png
