RailEduKit/SigLab-3Dmodels/images/renders/signal_distant_top.png

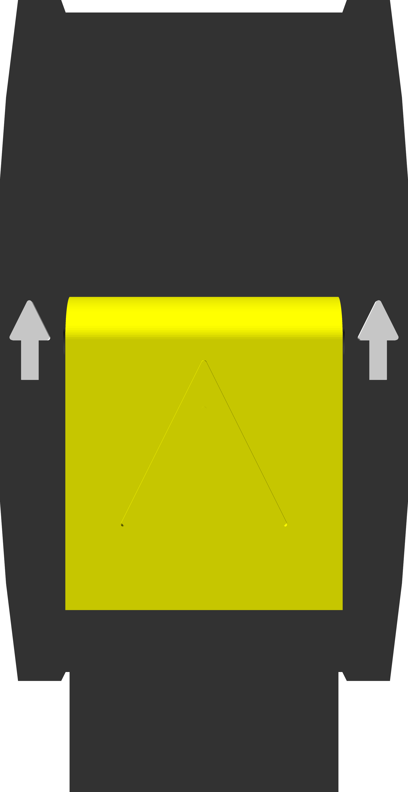
images/renders/signal_distant_top.png
