RailEduKit/SigLab-3Dmodels/images/renders/signal_lever_block_bottom.png

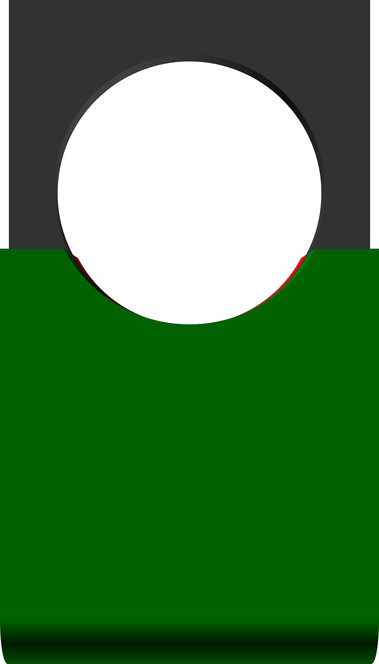
images/renders/signal_lever_block_bottom.png
