RailEduKit/SigLab-3Dmodels/images/renders/signal_lever_block_front.png

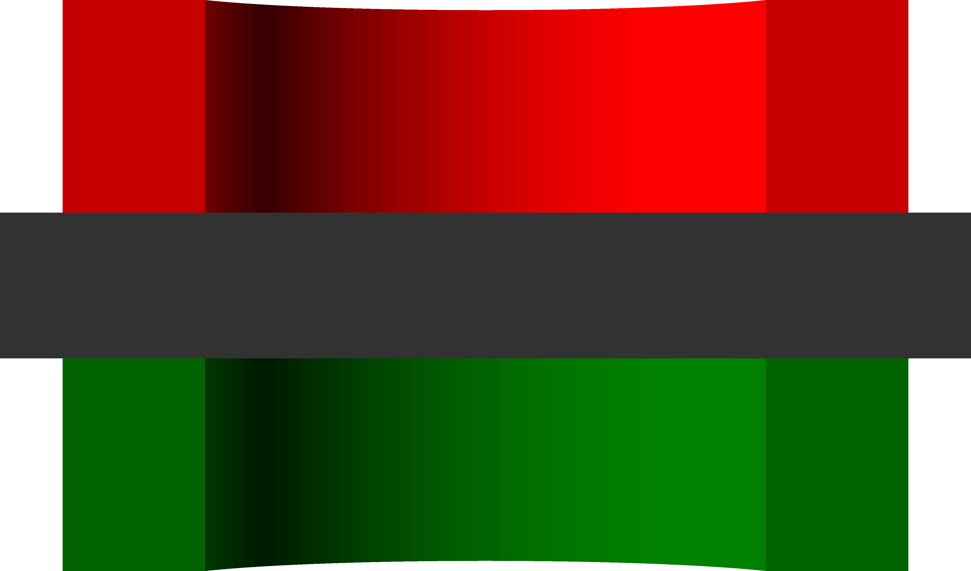
images/renders/signal_lever_block_front.png
