RailEduKit/SigLab-3Dmodels/images/renders/signal_lever_block_isometric.png

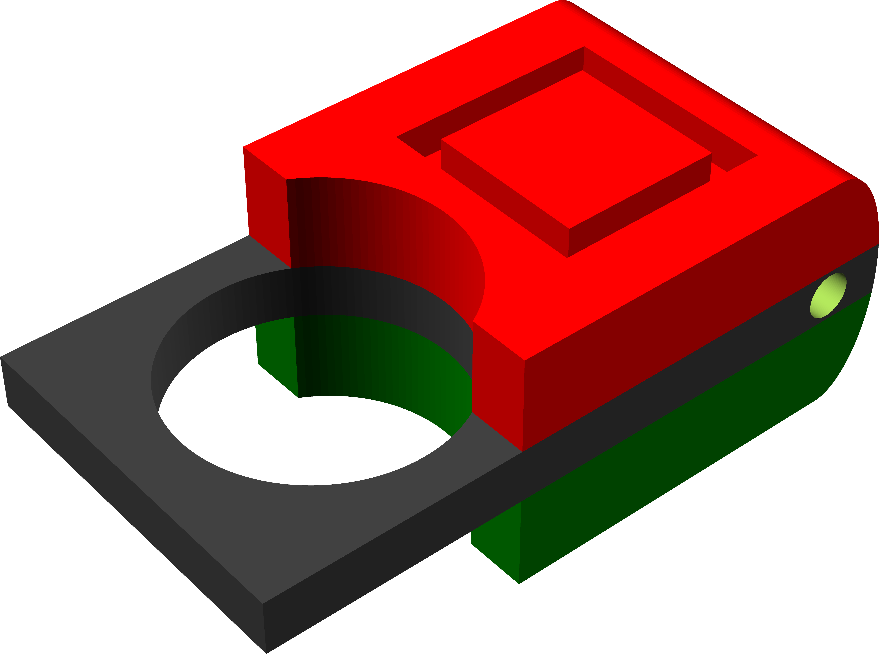
images/renders/signal_lever_block_isometric.png
