RailEduKit/SigLab-3Dmodels/images/renders/signal_lever_block_top.png

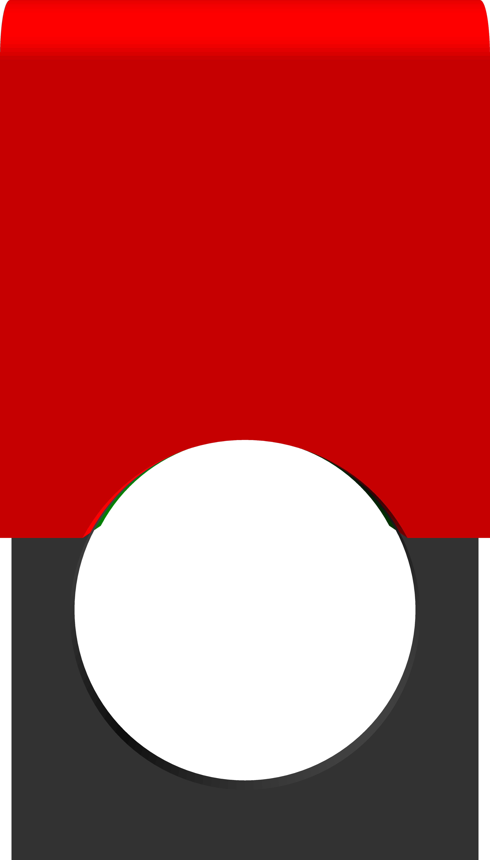
images/renders/signal_lever_block_top.png
