RailEduKit/SigLab-3Dmodels/images/renders/signal_lever_distant_isometric.png

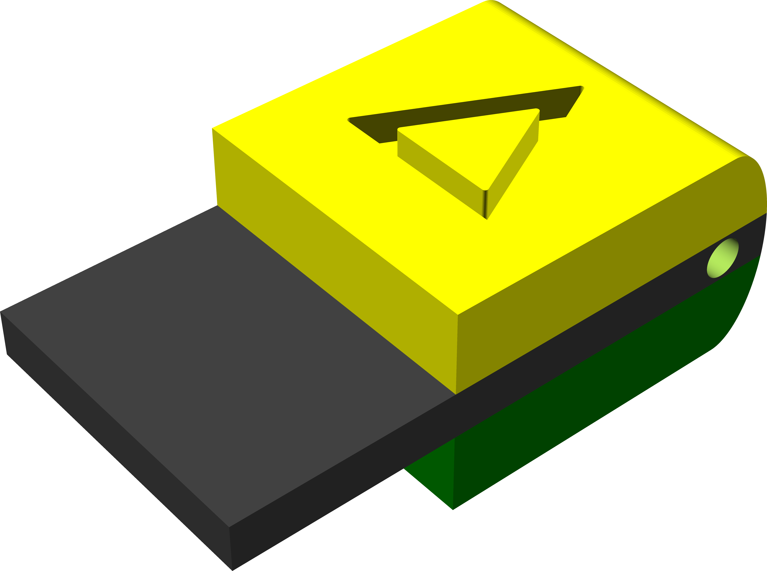
images/renders/signal_lever_distant_isometric.png
