RailEduKit/SigLab-3Dmodels/images/renders/signal_lever_distant_top.png

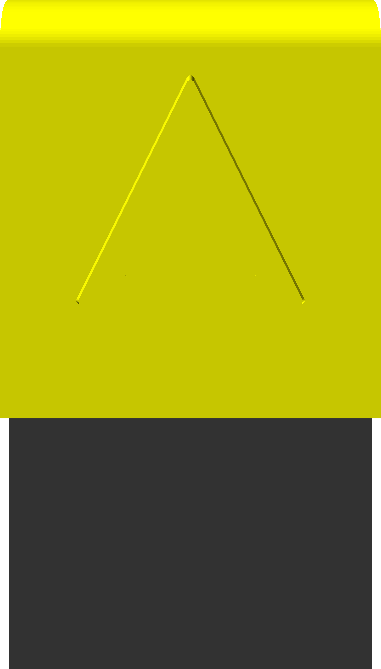
images/renders/signal_lever_distant_top.png
