RailEduKit/SigLab-3Dmodels/images/renders/signal_route_all_positions_bottom.png

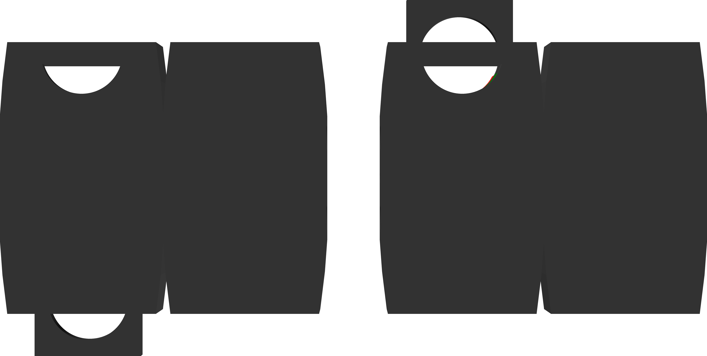
images/renders/signal_route_all_positions_bottom.png
