RailEduKit/SigLab-3Dmodels/images/renders/signal_route_all_positions_front.png

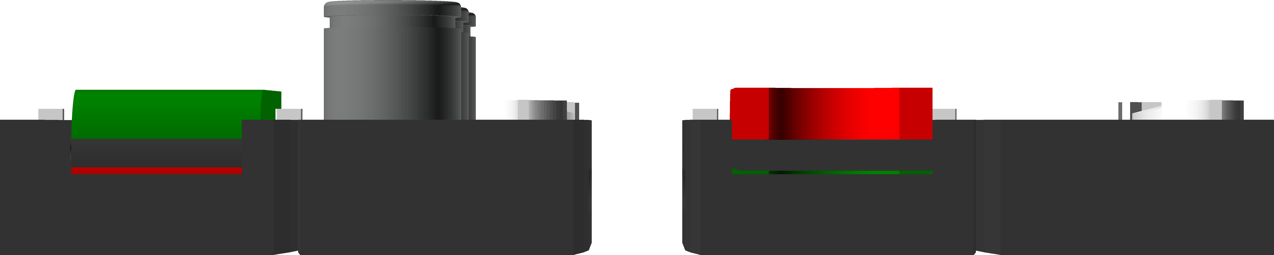
images/renders/signal_route_all_positions_front.png
