RailEduKit/SigLab-3Dmodels/images/renders/signal_route_all_positions_isometric.png

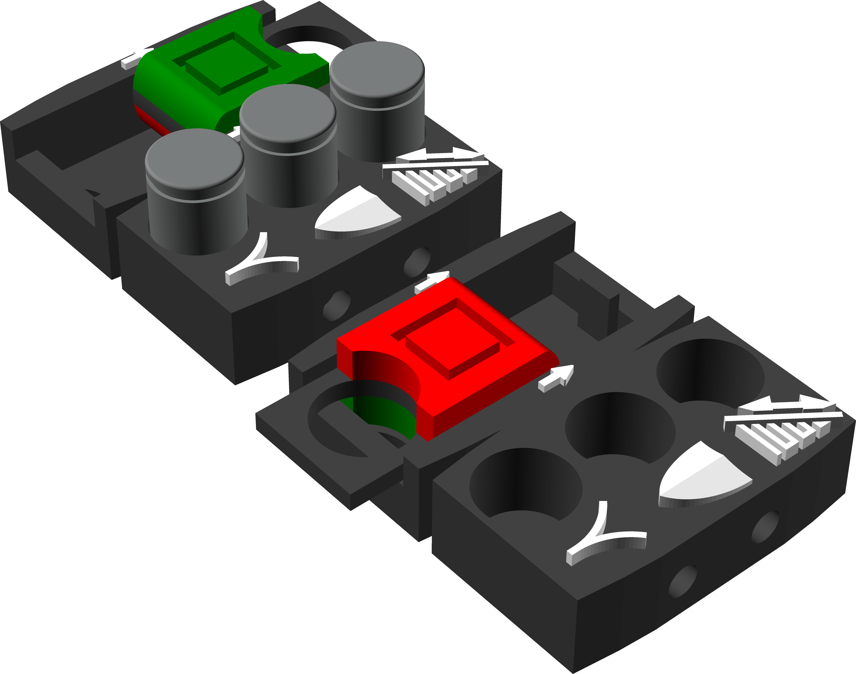
images/renders/signal_route_all_positions_isometric.png
