RailEduKit/SigLab-3Dmodels/images/renders/signal_route_all_positions_left.png

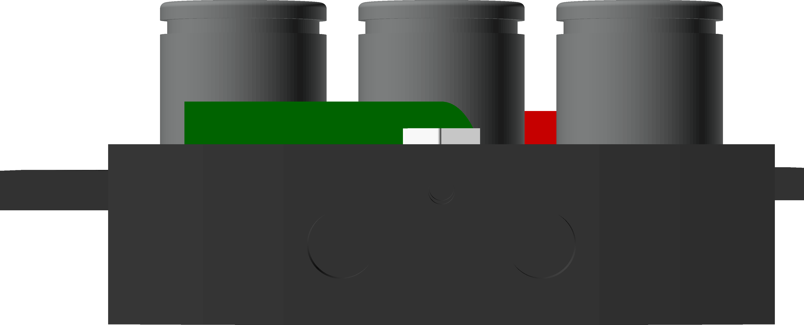
images/renders/signal_route_all_positions_left.png
