RailEduKit/SigLab-3Dmodels/images/renders/signal_route_all_positions_right.png

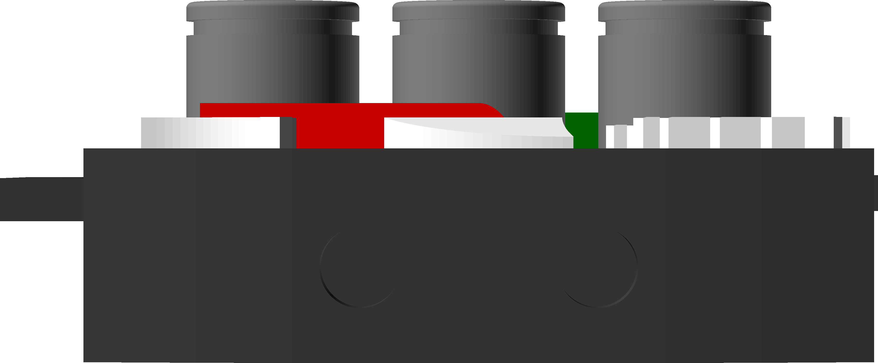
images/renders/signal_route_all_positions_right.png
