RailEduKit/SigLab-3Dmodels/images/renders/signal_route_all_positions_top.png

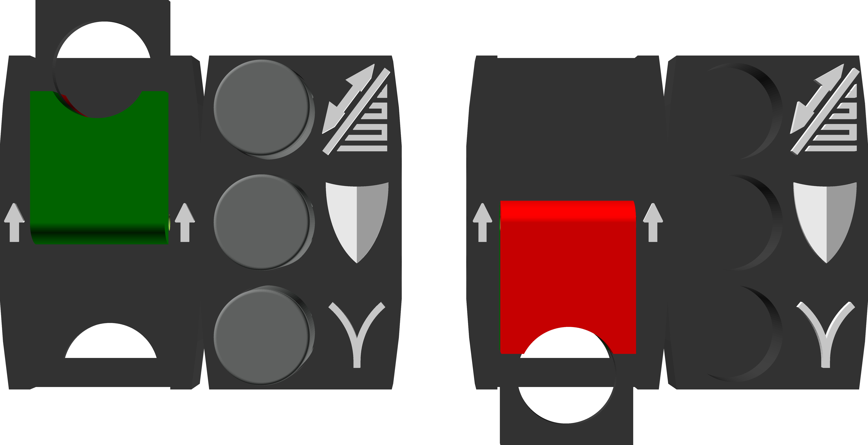
images/renders/signal_route_all_positions_top.png
