RailEduKit/SigLab-3Dmodels/images/renders/signal_route_back.png

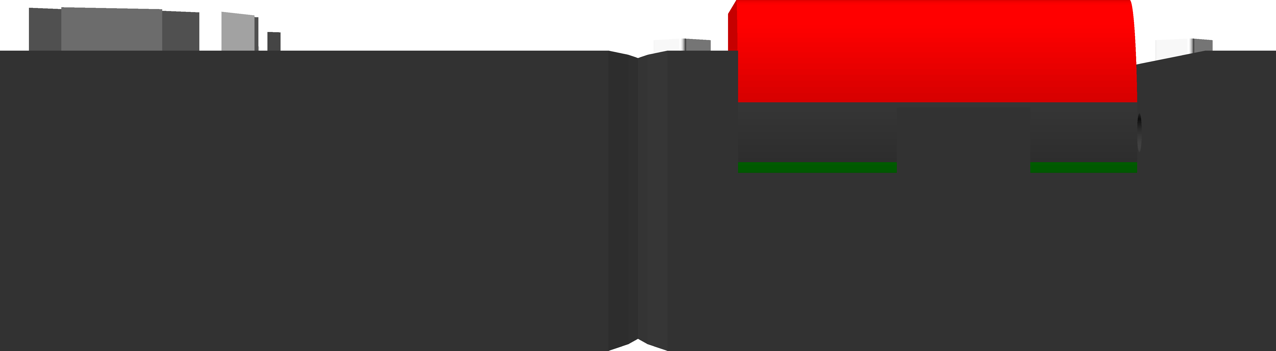
images/renders/signal_route_back.png
