RailEduKit/SigLab-3Dmodels/images/renders/signal_route_bottom.png

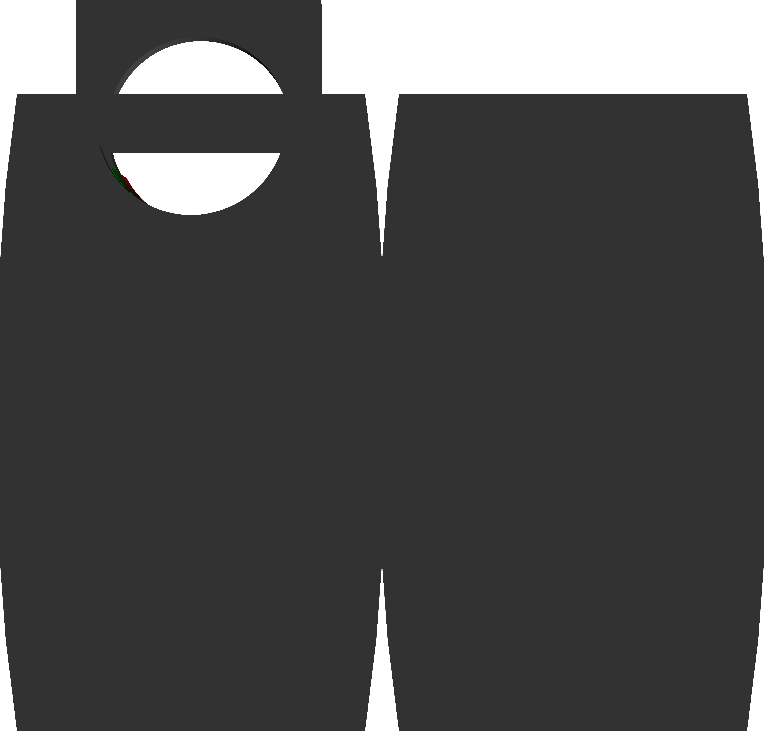
images/renders/signal_route_bottom.png
