RailEduKit/SigLab-3Dmodels/images/renders/signal_route_front.png

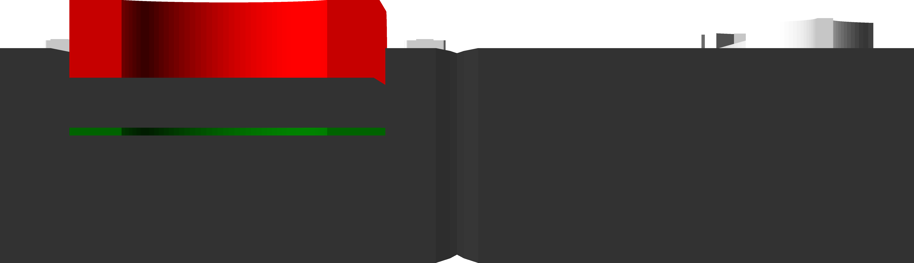
images/renders/signal_route_front.png
