RailEduKit/SigLab-3Dmodels/images/renders/signal_route_isometric.png

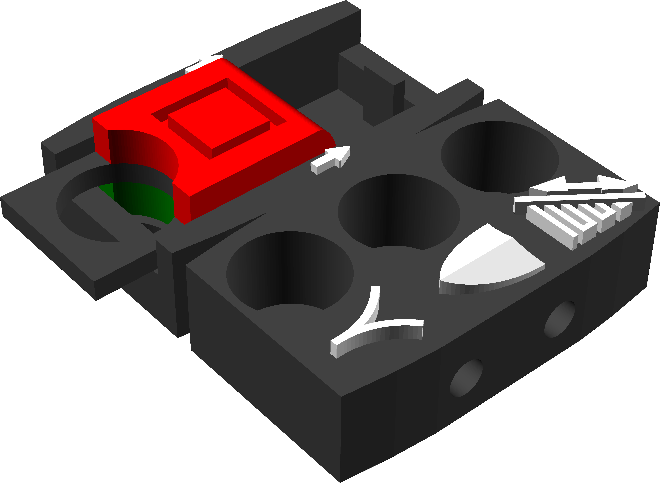
images/renders/signal_route_isometric.png
