RailEduKit/SigLab-3Dmodels/images/renders/signal_route_right.png

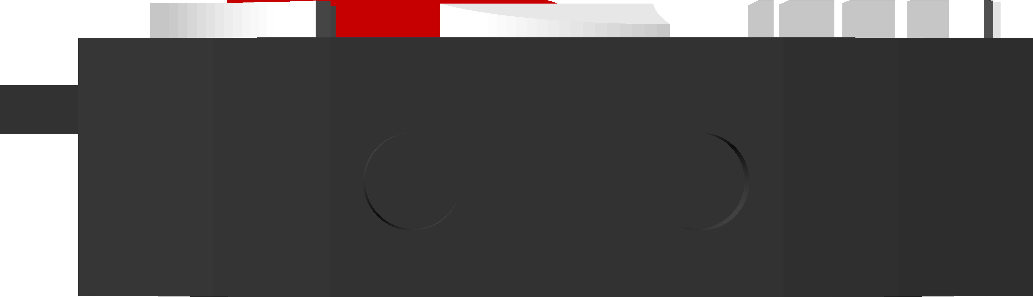
images/renders/signal_route_right.png
