RailEduKit/SigLab-3Dmodels/images/renders/signal_route_top.png

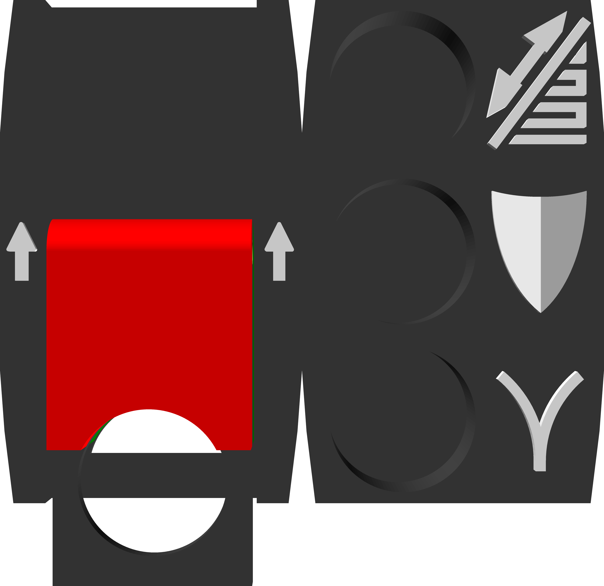
images/renders/signal_route_top.png
