RailEduKit/SigLab-3Dmodels/images/renders/speed_controller_back.png

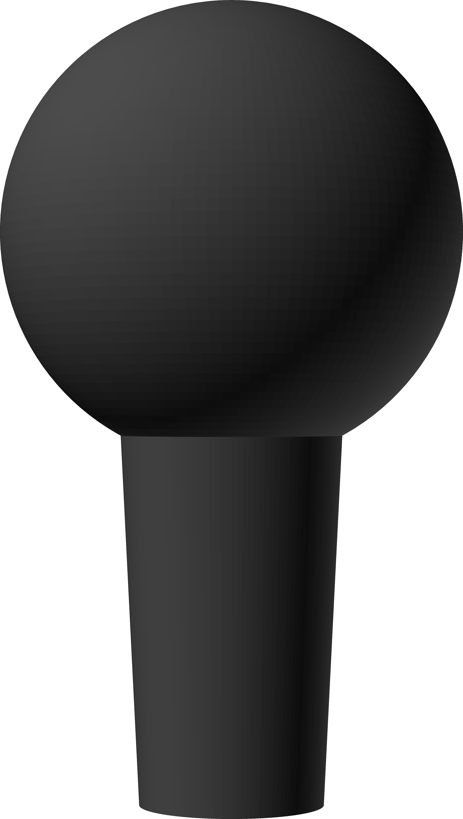
images/renders/speed_controller_back.png
