RailEduKit/SigLab-3Dmodels/images/renders/speed_controller_bottom.png

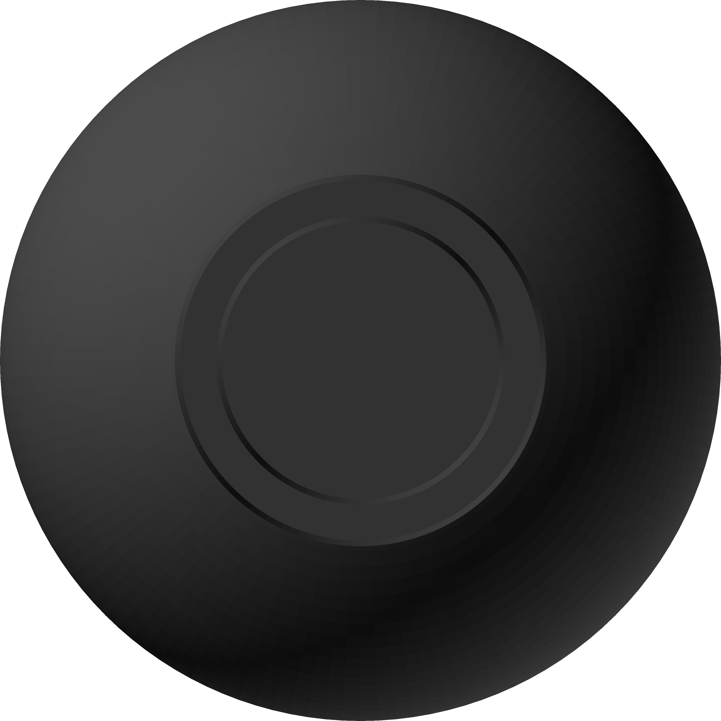
images/renders/speed_controller_bottom.png
