RailEduKit/SigLab-3Dmodels/images/renders/switch_blade_back.png

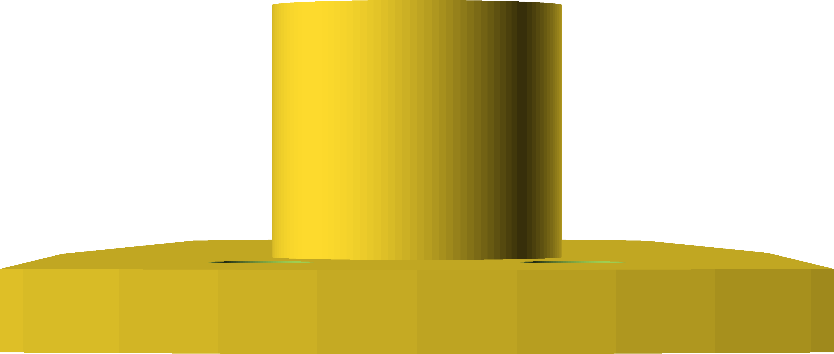
images/renders/switch_blade_back.png
