RailEduKit/SigLab-3Dmodels/images/renders/switch_blade_bottom.png

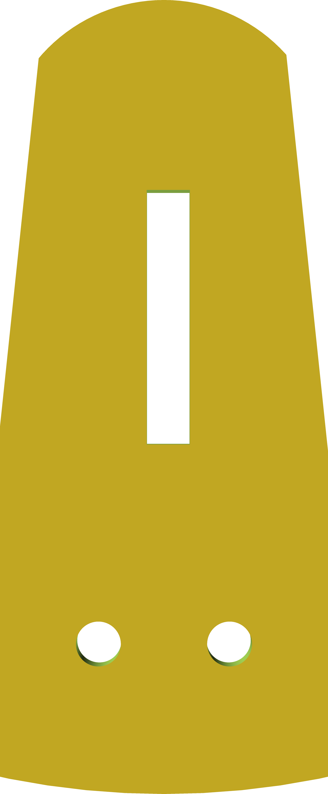
images/renders/switch_blade_bottom.png
