RailEduKit/SigLab-3Dmodels/images/renders/switch_blade_isometric.png

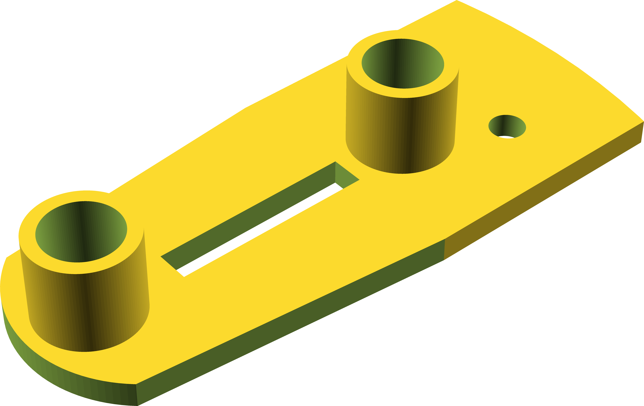
images/renders/switch_blade_isometric.png
