RailEduKit/SigLab-3Dmodels/images/renders/switch_blade_left.png

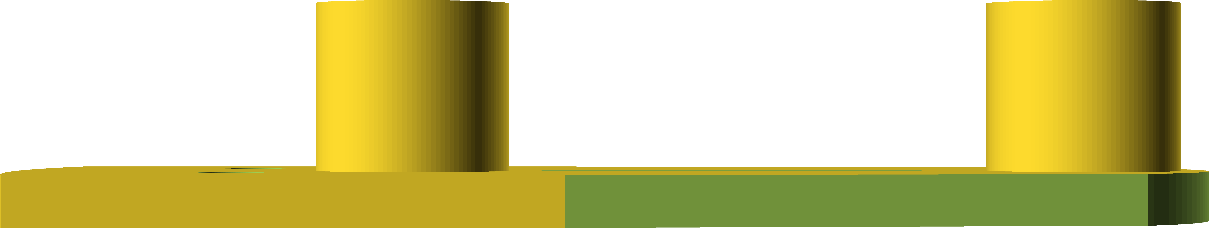
images/renders/switch_blade_left.png
