RailEduKit/SigLab-3Dmodels/images/renders/switch_blade_right.png

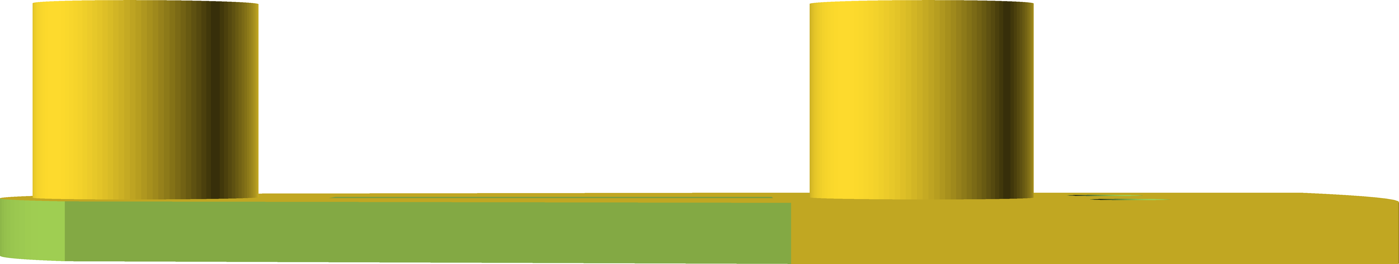
images/renders/switch_blade_right.png
