RailEduKit/SigLab-3Dmodels/images/renders/switch_blade_top.png

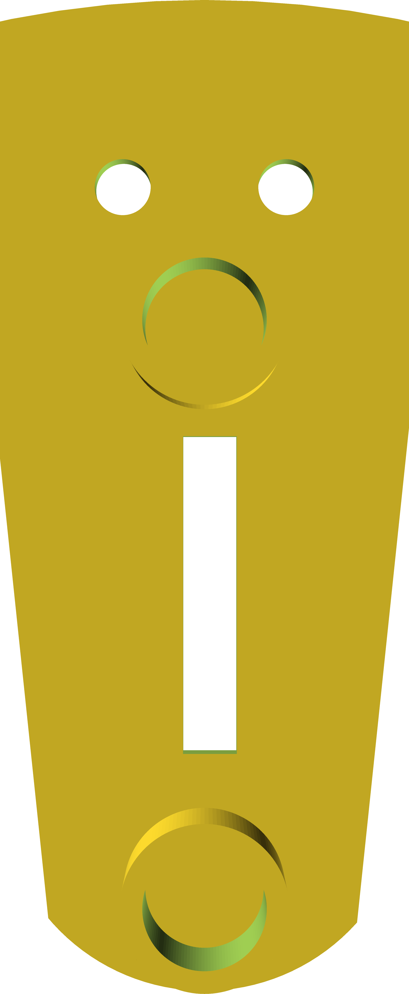
images/renders/switch_blade_top.png
