RailEduKit/SigLab-3Dmodels/images/renders/switch_lever_back.png

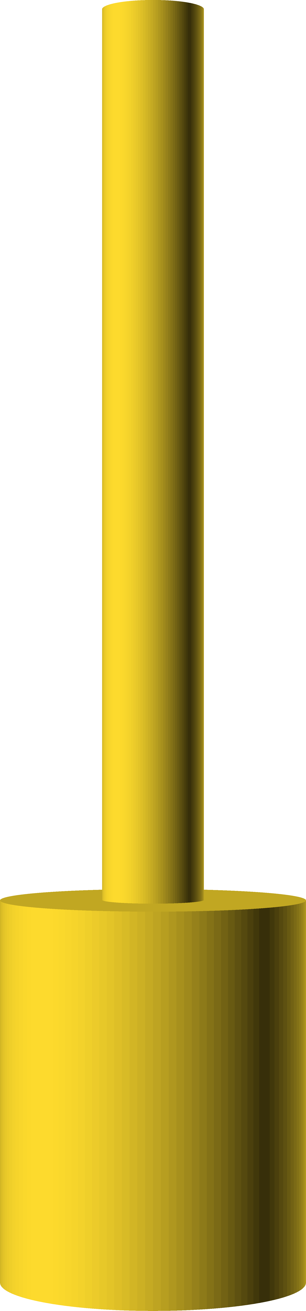
images/renders/switch_lever_back.png
