RailEduKit/SigLab-3Dmodels/images/renders/switch_lever_isometric.png

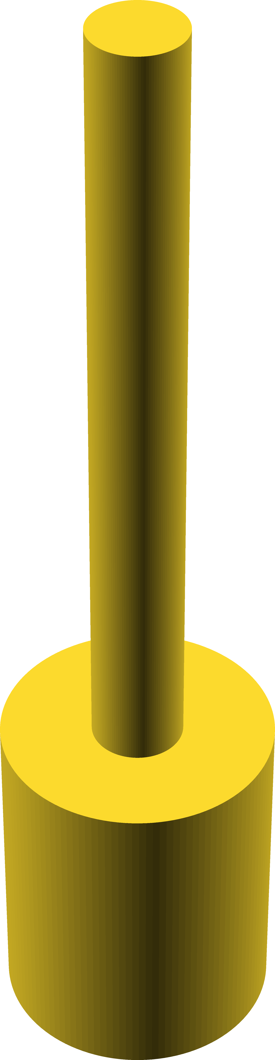
images/renders/switch_lever_isometric.png
