RailEduKit/SigLab-3Dmodels/images/renders/switch_locker_back.png

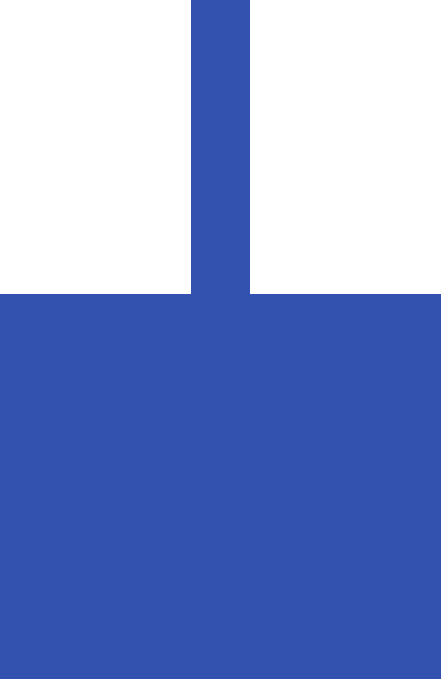
images/renders/switch_locker_back.png
