RailEduKit/SigLab-3Dmodels/images/renders/switch_locker_bottom.png

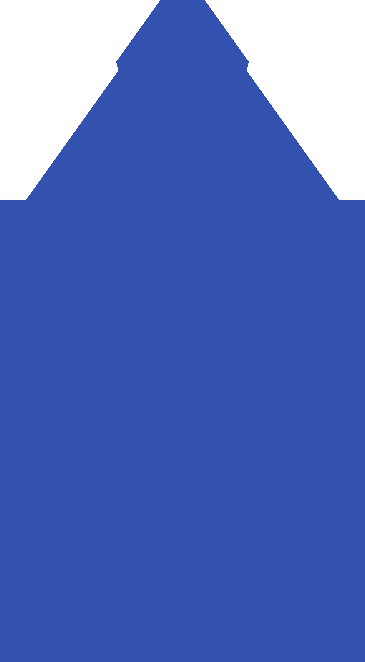
images/renders/switch_locker_bottom.png
