RailEduKit/SigLab-3Dmodels/images/renders/switch_locker_front.png

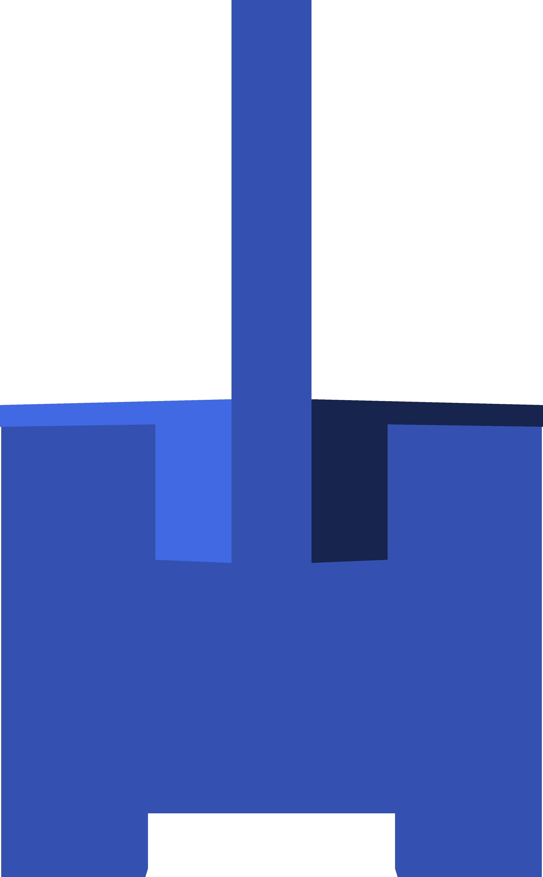
images/renders/switch_locker_front.png
