RailEduKit/SigLab-3Dmodels/images/renders/switch_locker_left.png

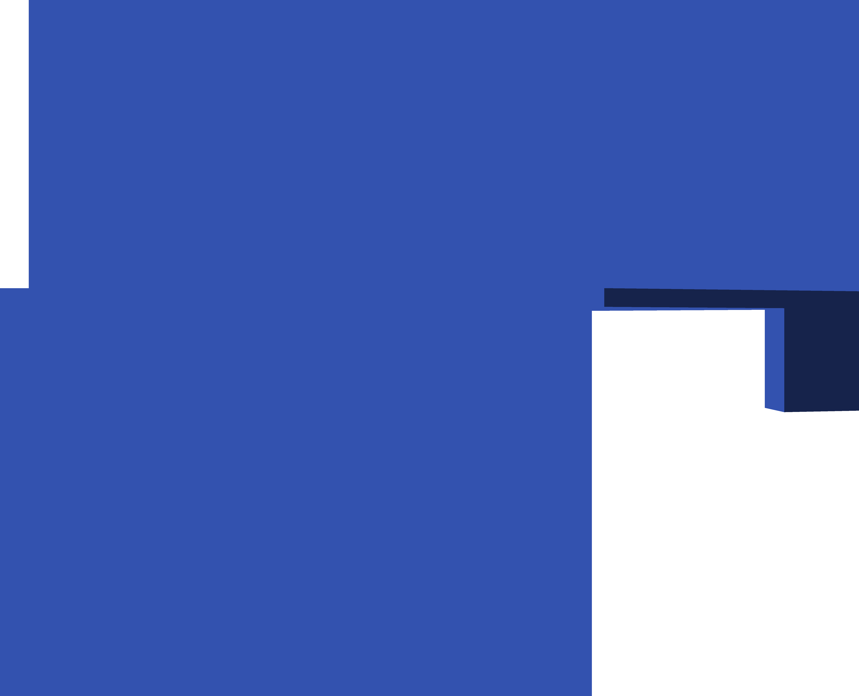
images/renders/switch_locker_left.png
