RailEduKit/SigLab-3Dmodels/images/renders/switch_locker_right.png

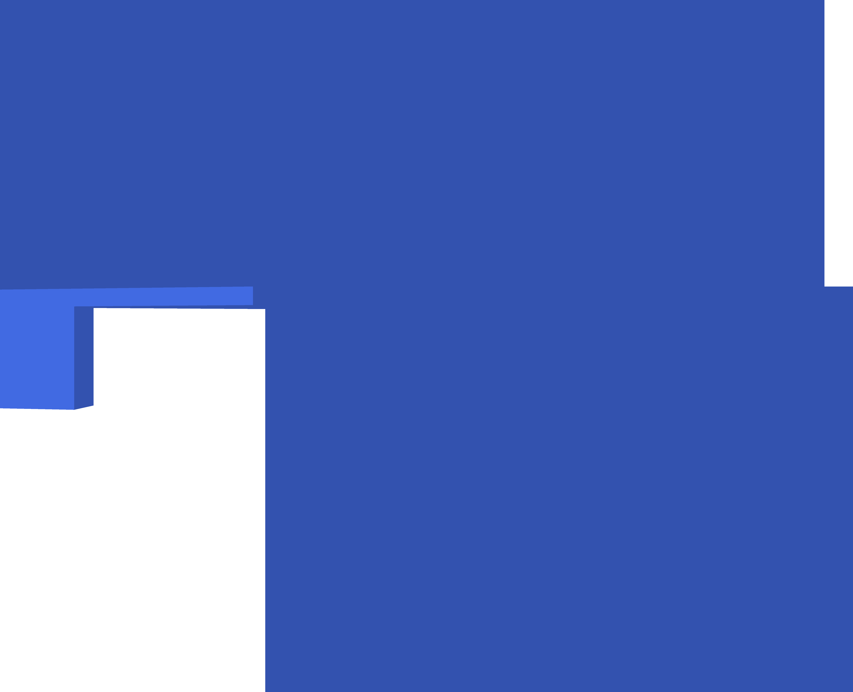
images/renders/switch_locker_right.png
