RailEduKit/SigLab-3Dmodels/images/renders/switch_locker_top.png

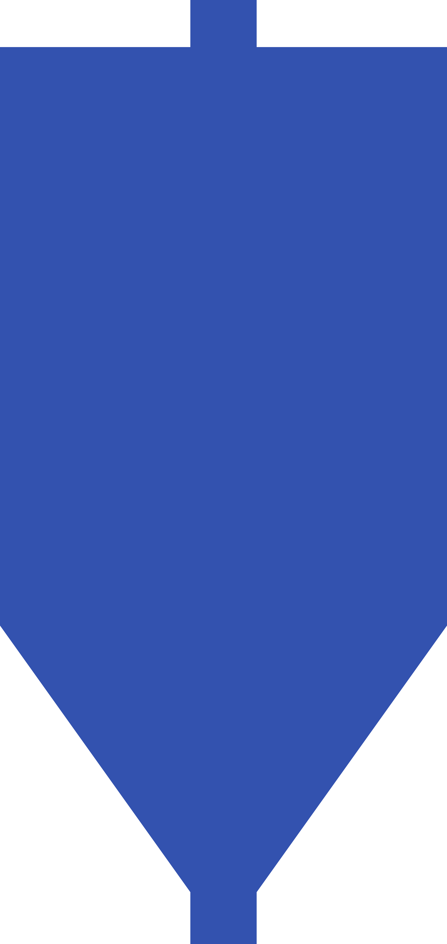
images/renders/switch_locker_top.png
