RailEduKit/SigLab-3Dmodels/images/renders/track_indicator_curve_isometric.png

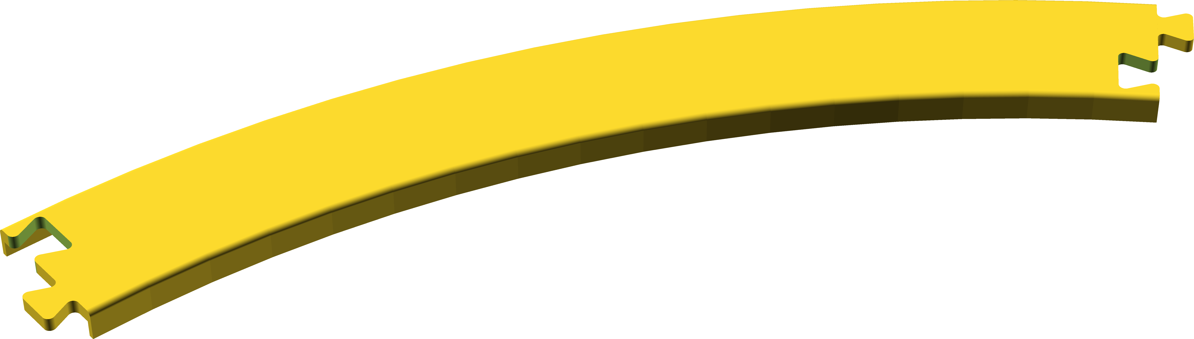
images/renders/track_indicator_curve_isometric.png
