RailEduKit/SigLab-3Dmodels/images/renders/track_indicator_curve_right.png

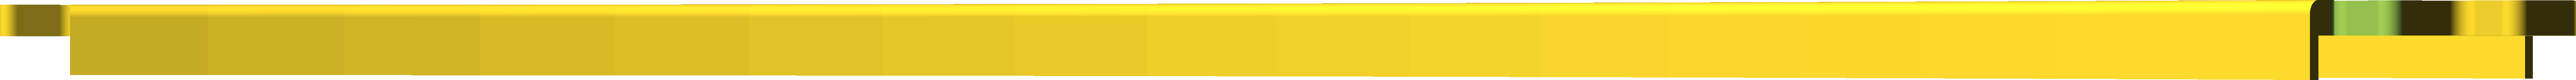
images/renders/track_indicator_curve_right.png
