RailEduKit/SigLab-3Dmodels/images/renders/track_indicator_straight_back.png

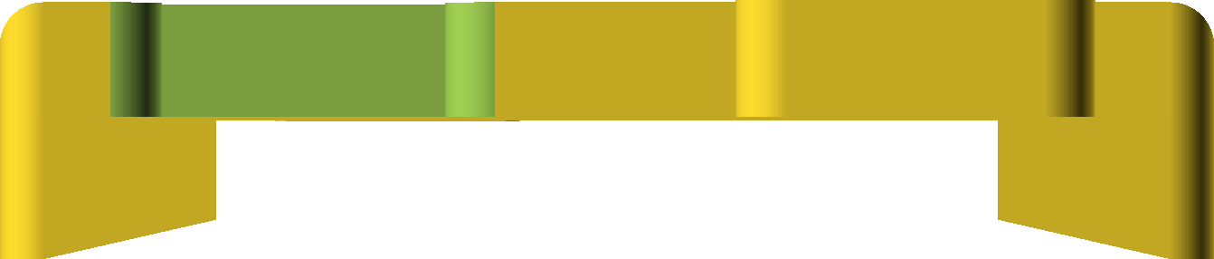
images/renders/track_indicator_straight_back.png
