RailEduKit/SigLab-3Dmodels/images/renders/track_indicator_straight_left.png

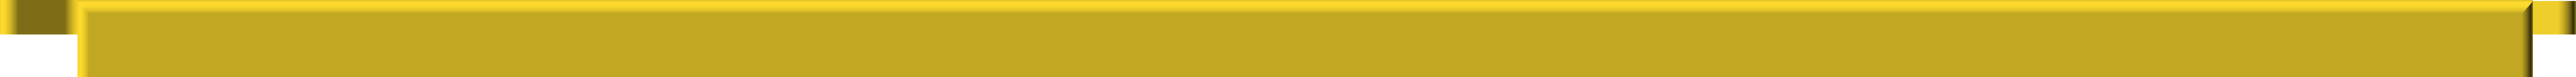
images/renders/track_indicator_straight_left.png
