RailEduKit/SigLab-3Dmodels/images/renders/track_indicator_straight_top.png

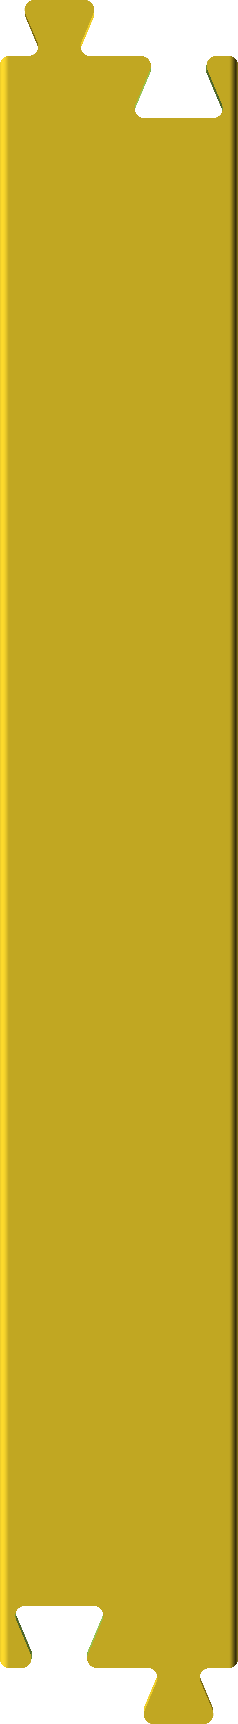
images/renders/track_indicator_straight_top.png
