RailEduKit/SigLab-3Dmodels/images/renders/train_integrity_body_front_back.png

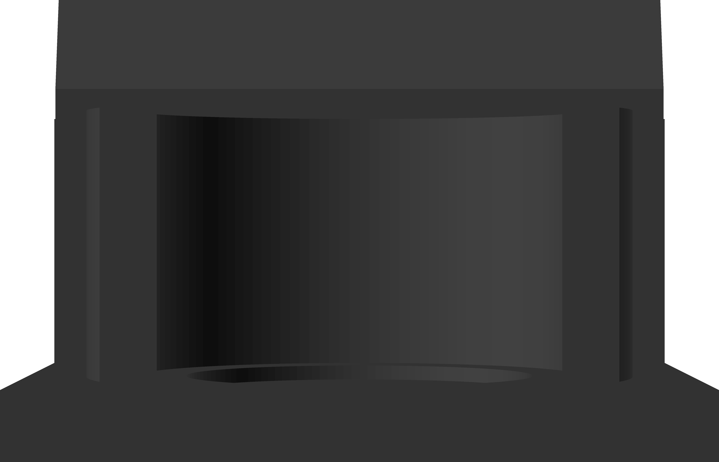
images/renders/train_integrity_body_front_back.png
