RailEduKit/SigLab-3Dmodels/images/renders/train_integrity_body_front_bottom.png

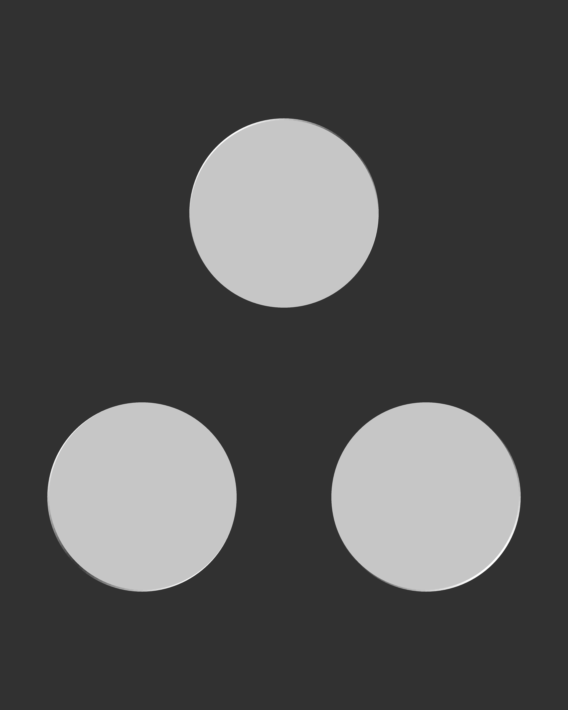
images/renders/train_integrity_body_front_bottom.png
