RailEduKit/SigLab-3Dmodels/images/renders/train_integrity_body_front_top.png

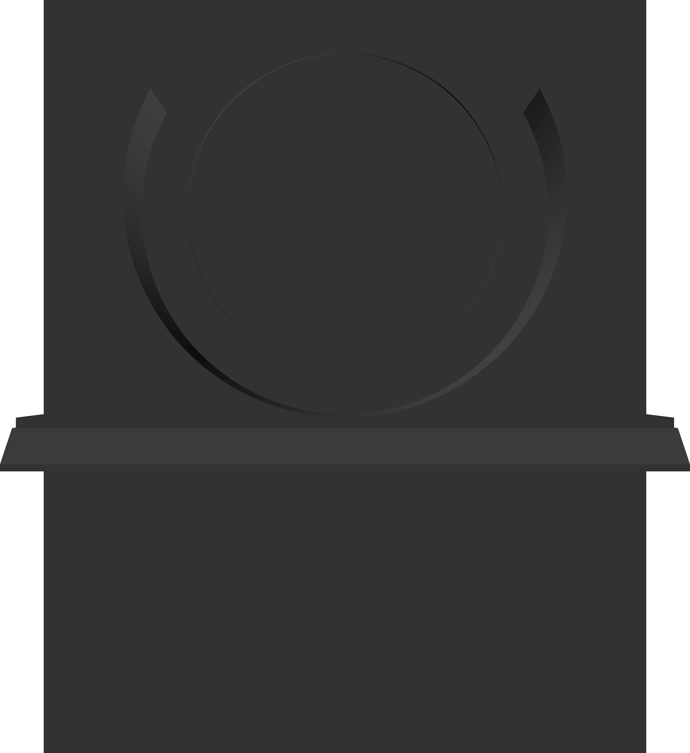
images/renders/train_integrity_body_front_top.png
