RailEduKit/SigLab-3Dmodels/images/renders/train_integrity_body_rear_bottom.png

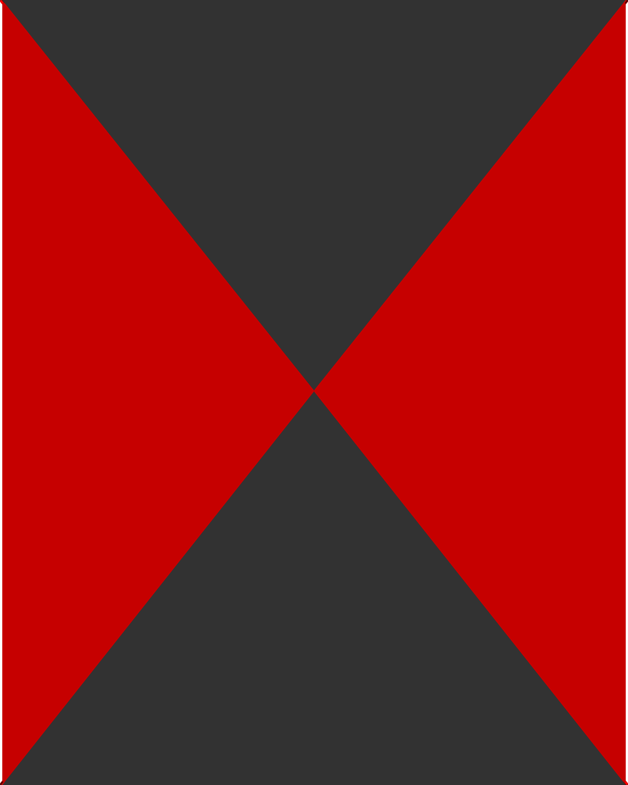
images/renders/train_integrity_body_rear_bottom.png
