RailEduKit/SigLab-3Dmodels/images/renders/train_integrity_body_rear_right.png

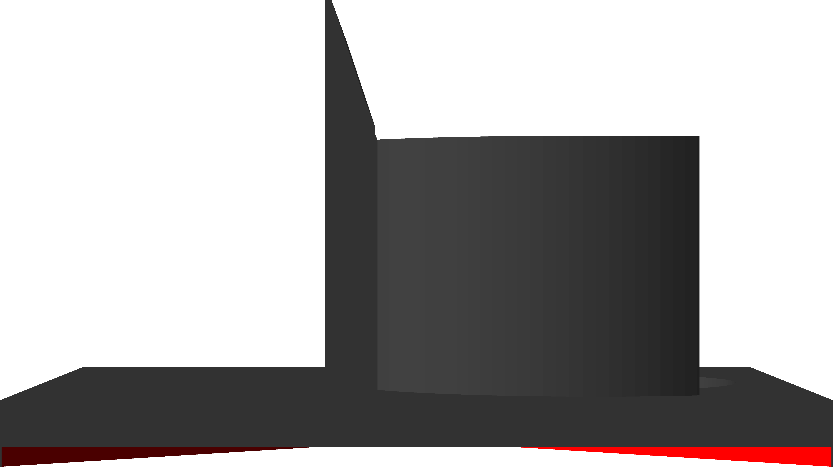
images/renders/train_integrity_body_rear_right.png
