RailEduKit/SigLab-3Dmodels/images/renders/train_integrity_front_back.png

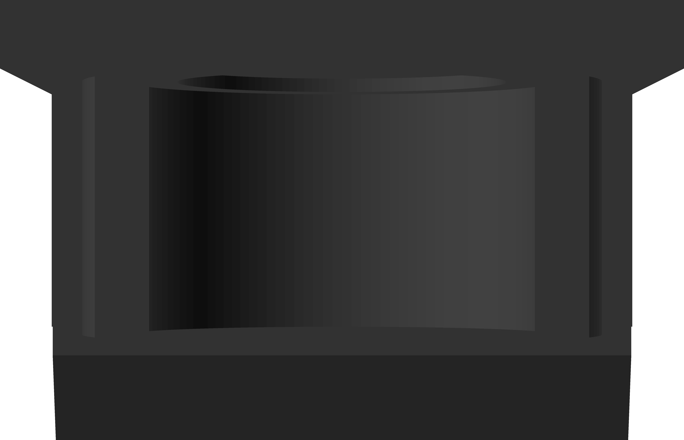
images/renders/train_integrity_front_back.png
