RailEduKit/SigLab-3Dmodels/images/renders/train_integrity_front_isometric.png

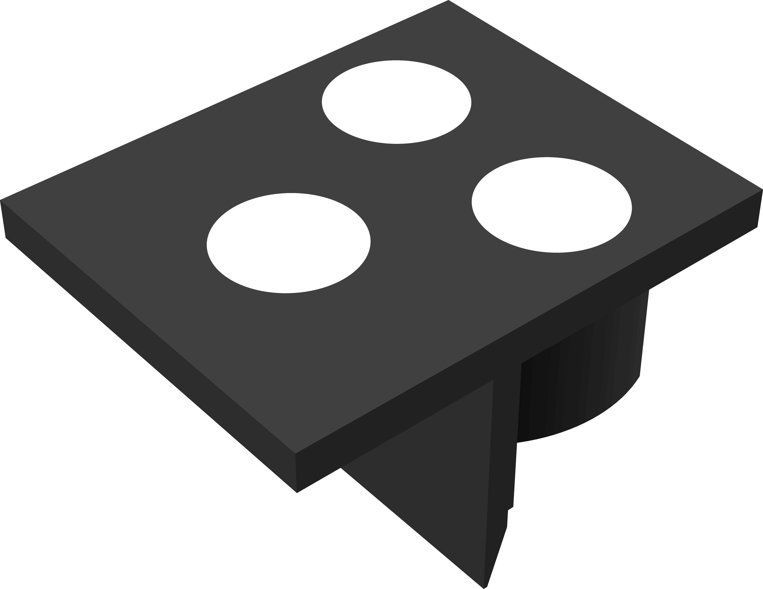
images/renders/train_integrity_front_isometric.png
