RailEduKit/SigLab-3Dmodels/images/renders/train_integrity_front_left.png

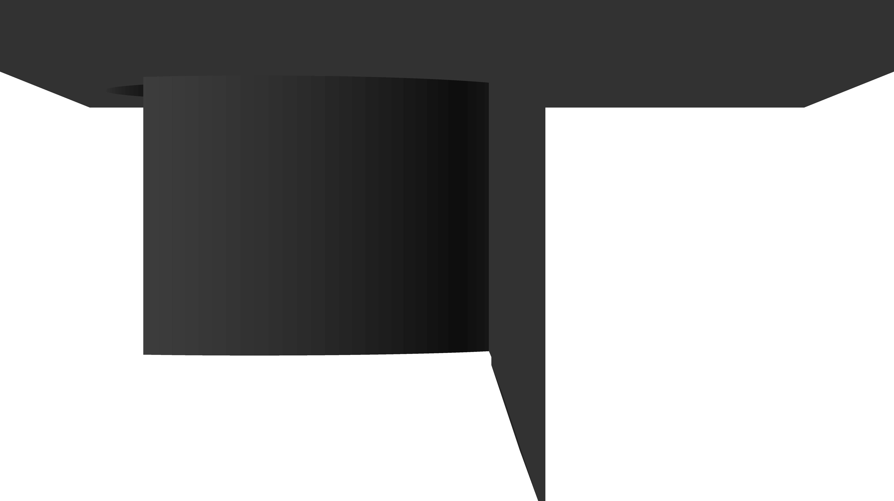
images/renders/train_integrity_front_left.png
