RailEduKit/SigLab-3Dmodels/images/renders/train_integrity_rear_isometric.png

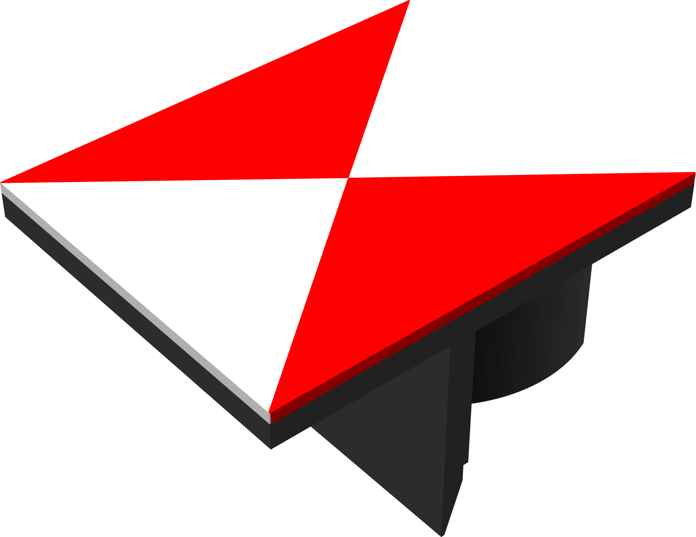
images/renders/train_integrity_rear_isometric.png
