RailEduKit/SigLab-3Dmodels/images/renders/train_integrity_rear_top.png

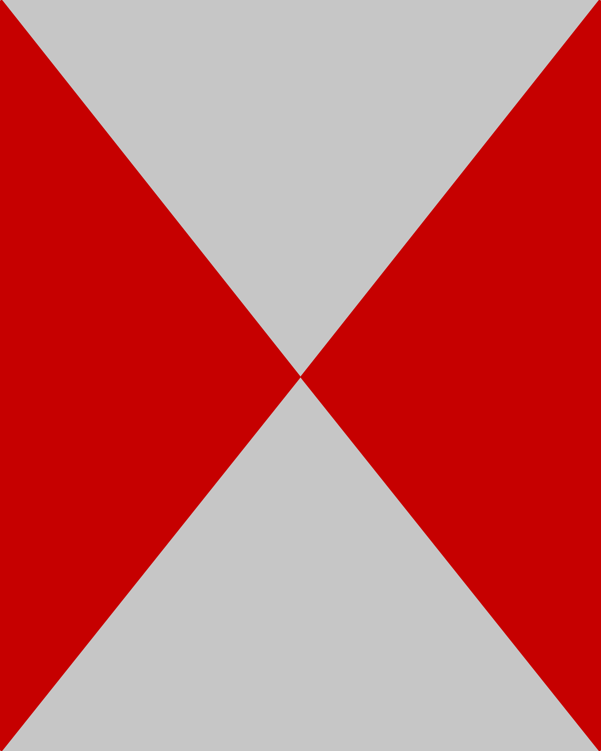
images/renders/train_integrity_rear_top.png
