RailEduKit/SigLab-3Dmodels/images/renders/train_integrity_symbol_front_bottom.png

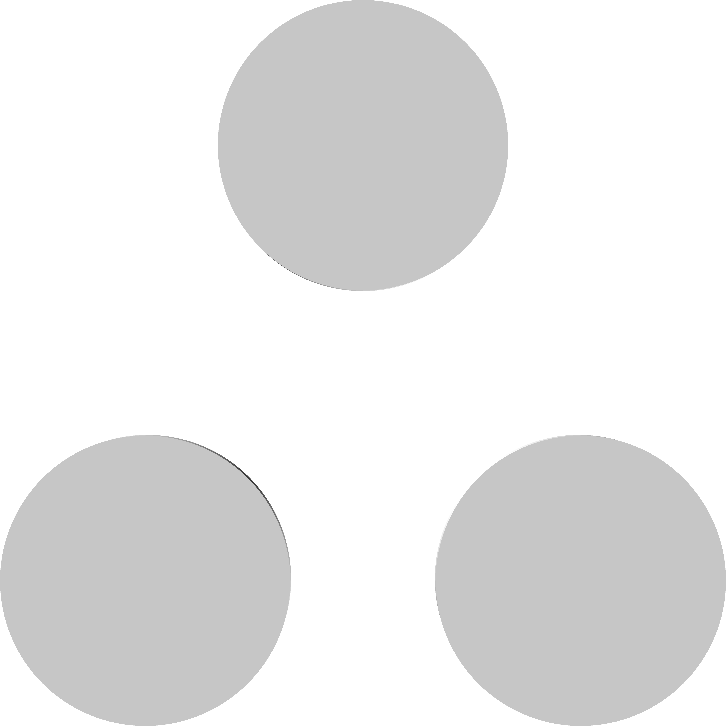
images/renders/train_integrity_symbol_front_bottom.png
