RailEduKit/SigLab-3Dmodels/images/renders/train_integrity_symbol_rear_isometric.png

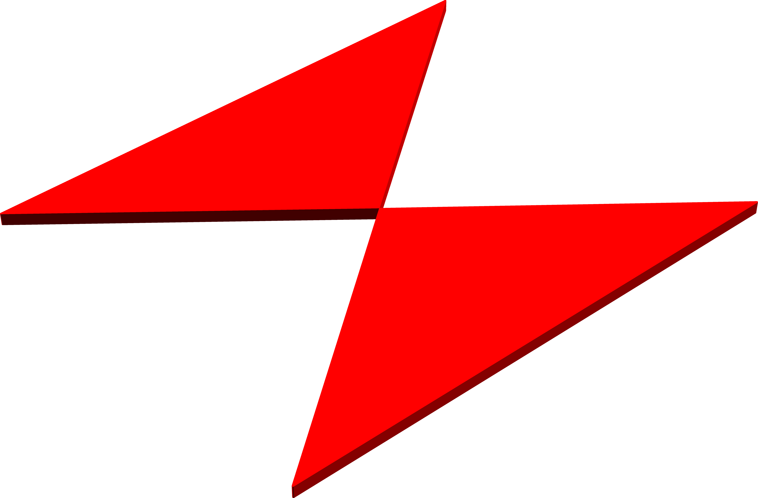
images/renders/train_integrity_symbol_rear_isometric.png
