RailEduKit/SigLab-3Dmodels/stl/signal_body-main.stl

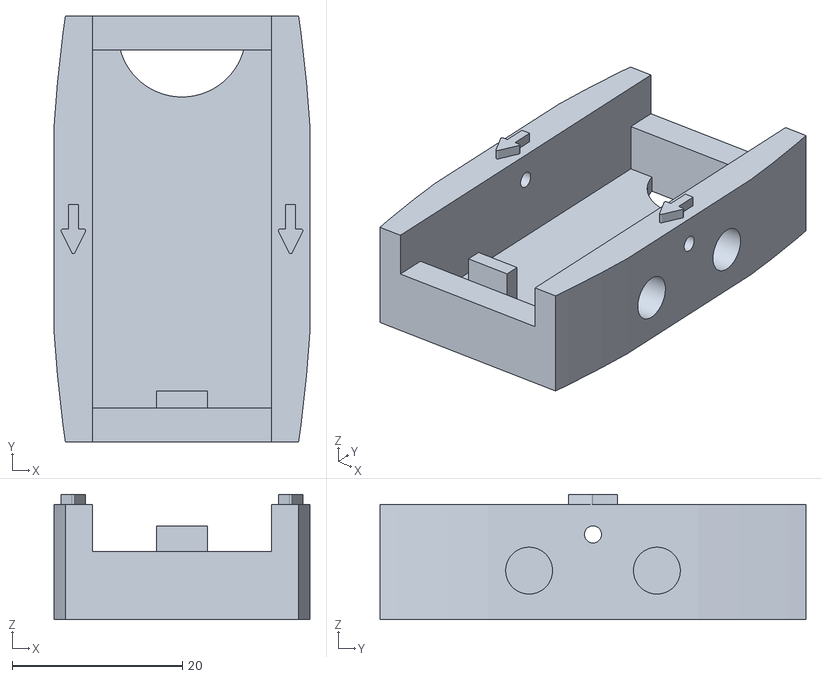
[picture p166: CAD file, 2025-05-15]
stl/signal_body-main.stl
30.0 x 50.0 x 14.7
