RailEduKit/SigLab-3Dmodels/stl/color_block-main.stl

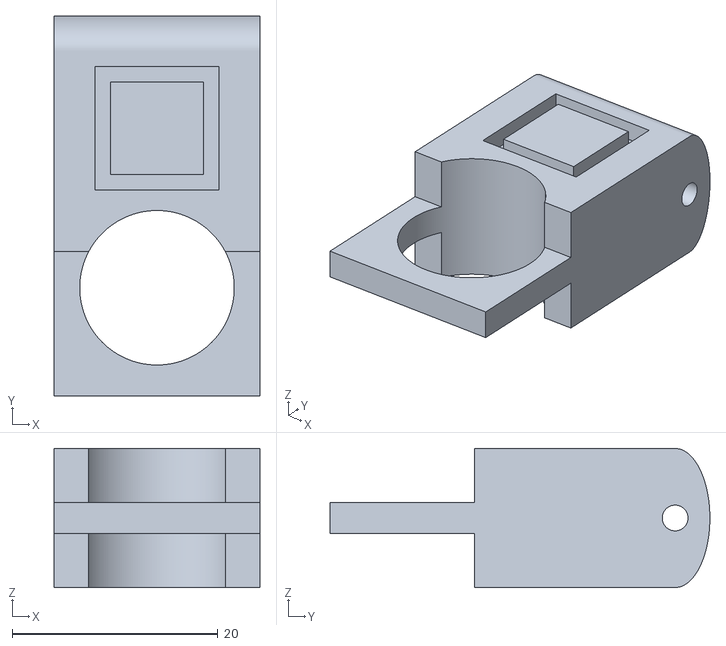
[picture p167: CAD file, 2025-05-15]
stl/color_block-main.stl
20.0 x 36.9 x 13.5
