RailEduKit/SigLab-3Dmodels/dxf/switch_body - left.dxf

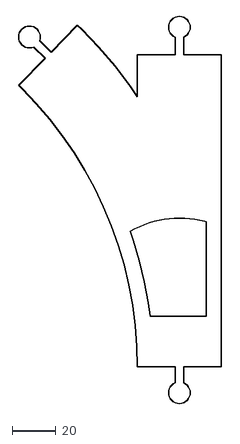
[picture p168: CAD file, 2025-05-21]
dxf/switch_body - left.dxf
93.2 x 178.0
