RailEduKit/SigLab-3Dmodels/stl/overlap_body_curve.stl

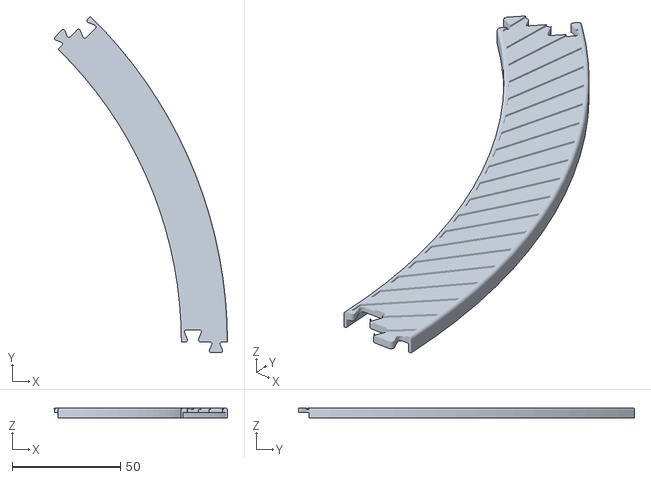
[picture p169: CAD file, 2026-04-01]
stl/overlap_body_curve.stl
80.0 x 155.6 x 4.51
