RailEduKit/SigLab-3Dmodels/dxf/switch_body - right.dxf

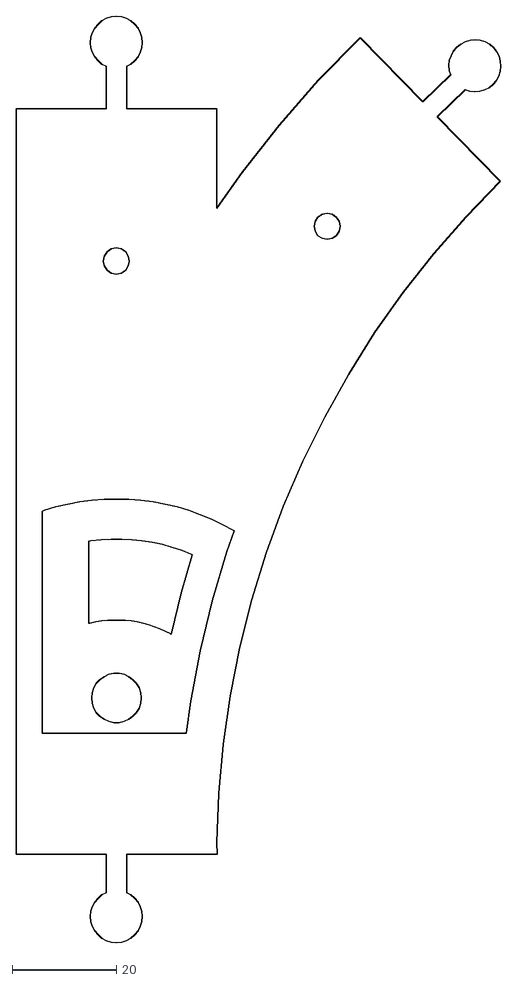
[picture p170: CAD file, 2025-05-21]
dxf/switch_body - right.dxf
93.2 x 178.0
