RailEduKit/SigLab-3Dmodels/stl/overlap_pattern_curve.stl

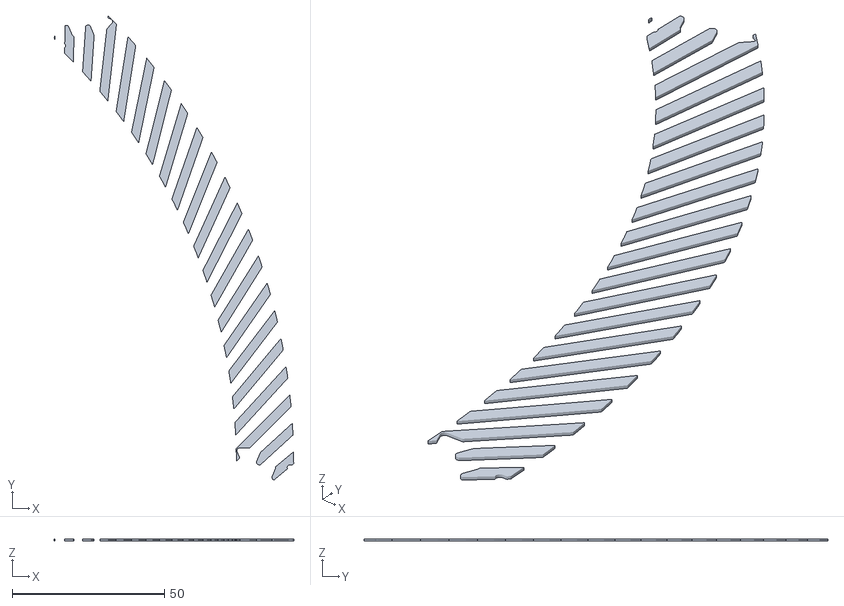
[picture p171: CAD file, 2026-04-01]
stl/overlap_pattern_curve.stl
78.8 x 152.6 x 0.6
