RailEduKit/SigLab-3Dmodels/dxf/curve_shape.dxf

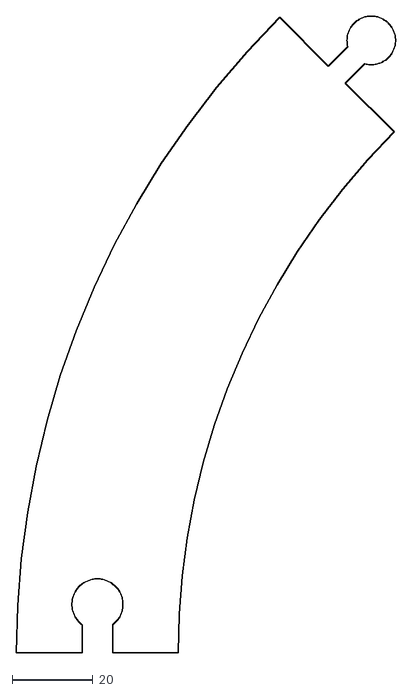
[picture p172: CAD file, 2025-03-12]
dxf/curve_shape.dxf
93.6 x 157.3
