RailEduKit/SigLab-3Dmodels/stl/overlap_pattern_straight_test-s_45-f_2.stl

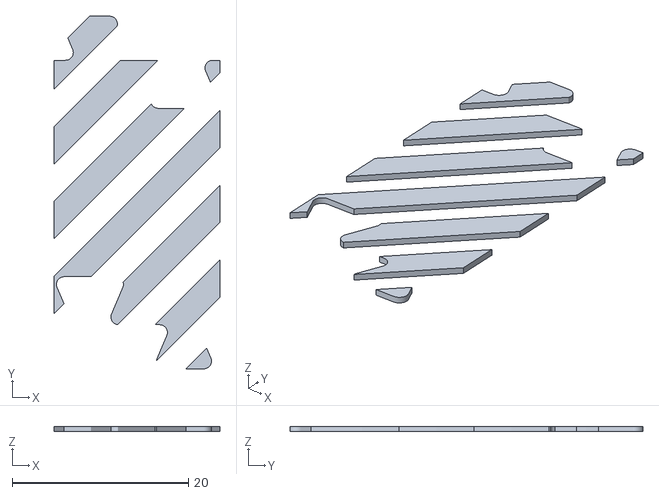
[picture p173: CAD file, 2026-04-01]
stl/overlap_pattern_straight_test-s_45-f_2.stl
18.8 x 40.0 x 0.6
