RailEduKit/SigLab-3Dmodels/stl/overlap_pattern_straight_test-s_55-f_3.stl

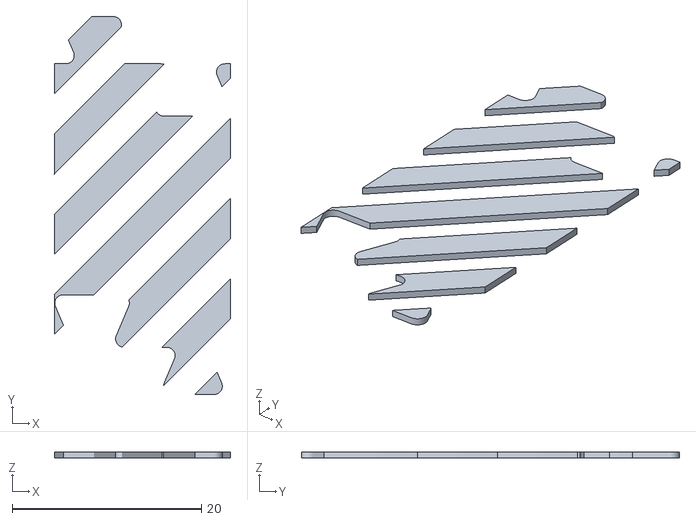
[picture p174: CAD file, 2026-04-01]
stl/overlap_pattern_straight_test-s_55-f_3.stl
18.6 x 40.0 x 0.6
