RailEduKit/SigLab-3Dmodels/stl/overlap_pattern_straight.stl

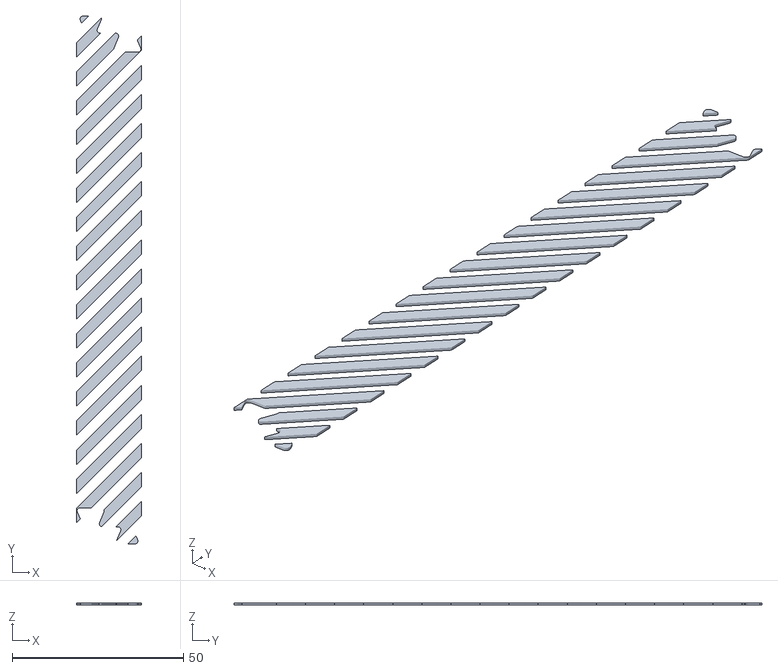
[picture p175: CAD file, 2026-04-01]
stl/overlap_pattern_straight.stl
18.8 x 154.0 x 0.6
