RailEduKit/SigLab-3Dmodels/stl/overlap_body_straight_test-s_55-f_3.stl

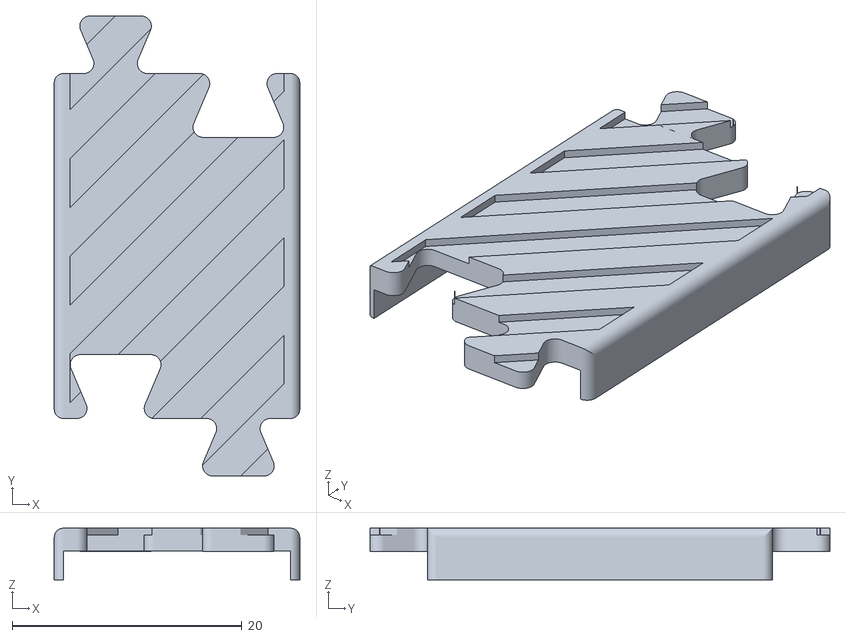
[picture p176: CAD file, 2026-04-01]
stl/overlap_body_straight_test-s_55-f_3.stl
21.4 x 40.0 x 4.51
