RailEduKit/SigLab-3Dmodels/stl/overlap_pattern_straight_test-s_65-f_4.stl

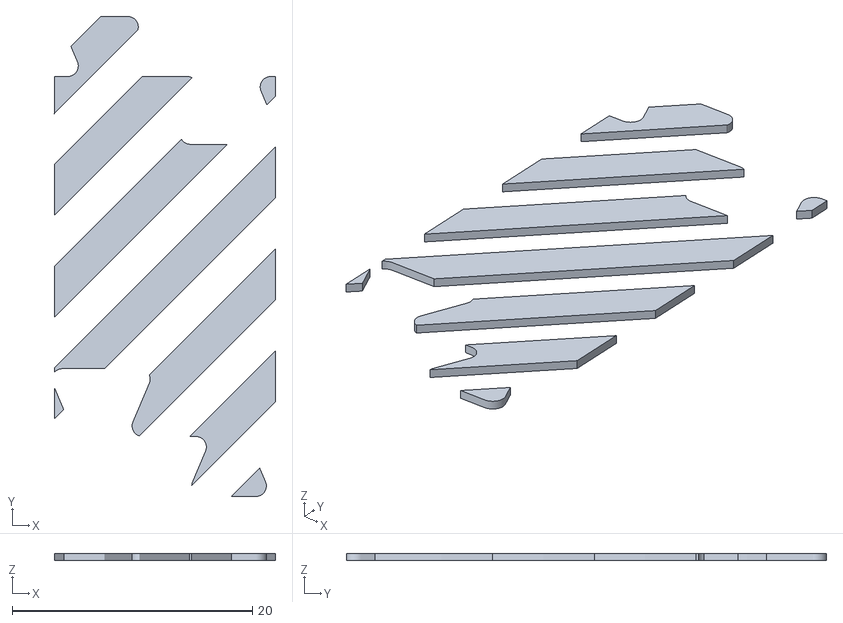
[picture p177: CAD file, 2026-04-01]
stl/overlap_pattern_straight_test-s_65-f_4.stl
18.4 x 40.0 x 0.6
