RailEduKit/SigLab-3Dmodels/stl/overlap_body_straight.stl

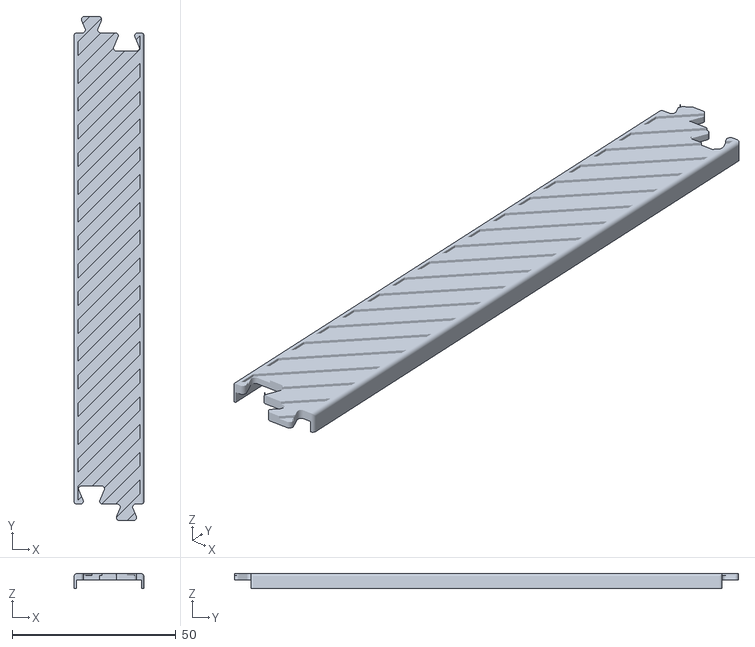
[picture p178: CAD file, 2026-04-01]
stl/overlap_body_straight.stl
21.4 x 154.0 x 4.51
