RailEduKit/SigLab-3Dmodels/stl/speed_controller.stl

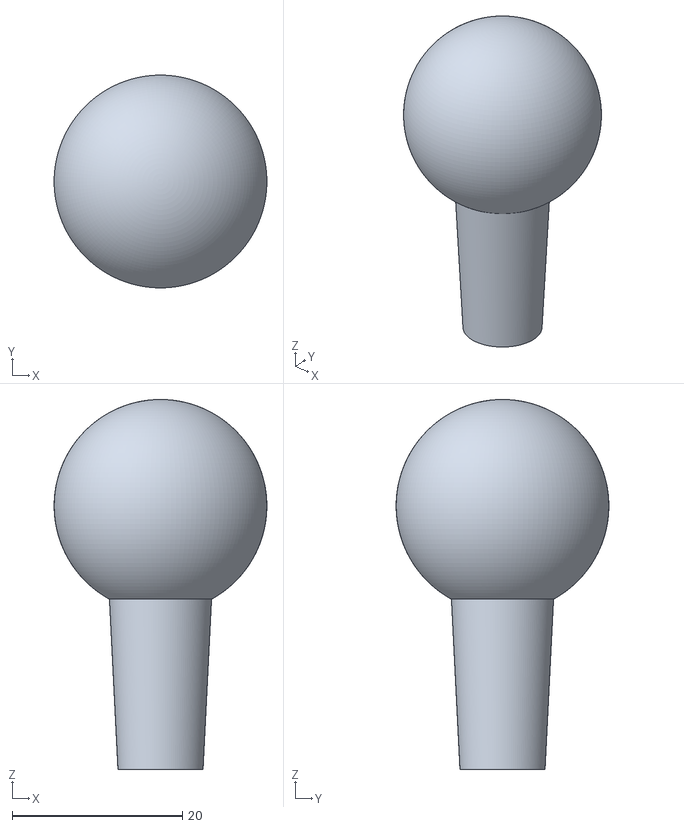
[picture p179: CAD file, 2026-03-30]
stl/speed_controller.stl
25.0 x 25.0 x 43.5
