RailEduKit/SigLab-3Dmodels/stl/drill_template_switch.stl

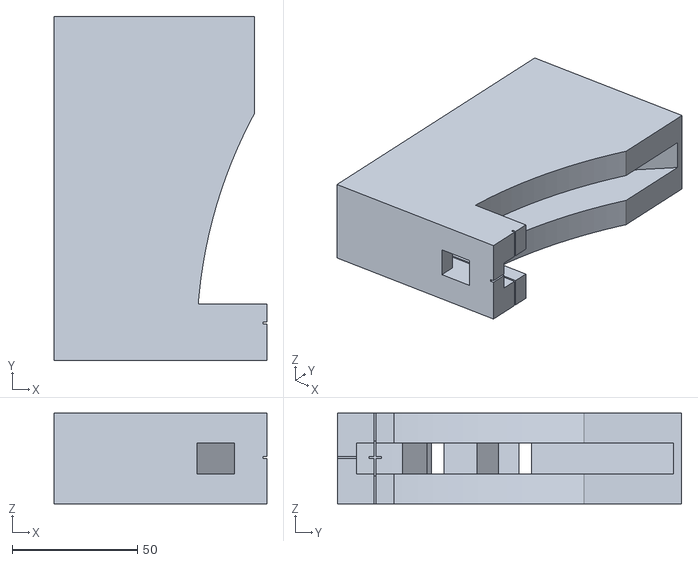
[picture p180: CAD file, 2025-05-16]
stl/drill_template_switch.stl
85.0 x 137.5 x 36.3
