RailEduKit/SigLab-3Dmodels/stl/train_tail_symbol.stl

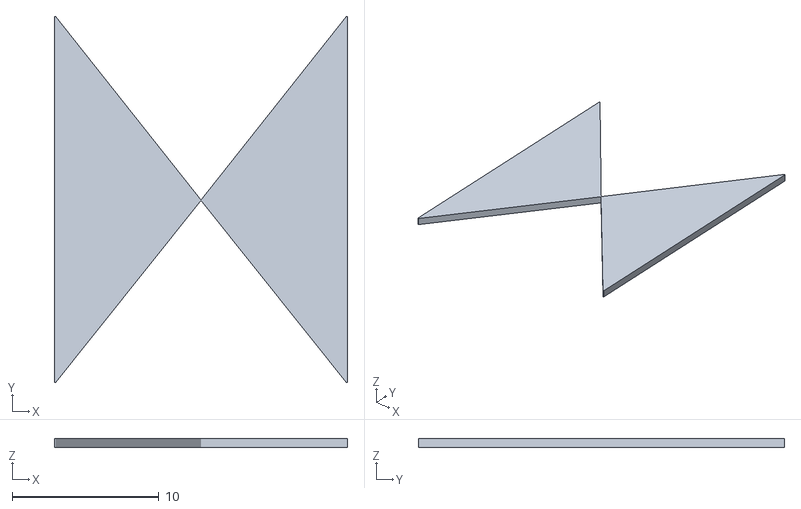
[picture p181: CAD file, 2025-05-16]
stl/train_tail_symbol.stl
20.0 x 25.0 x 0.6
