RailEduKit/SigLab-3Dmodels/stl/train_tail_coupler.stl

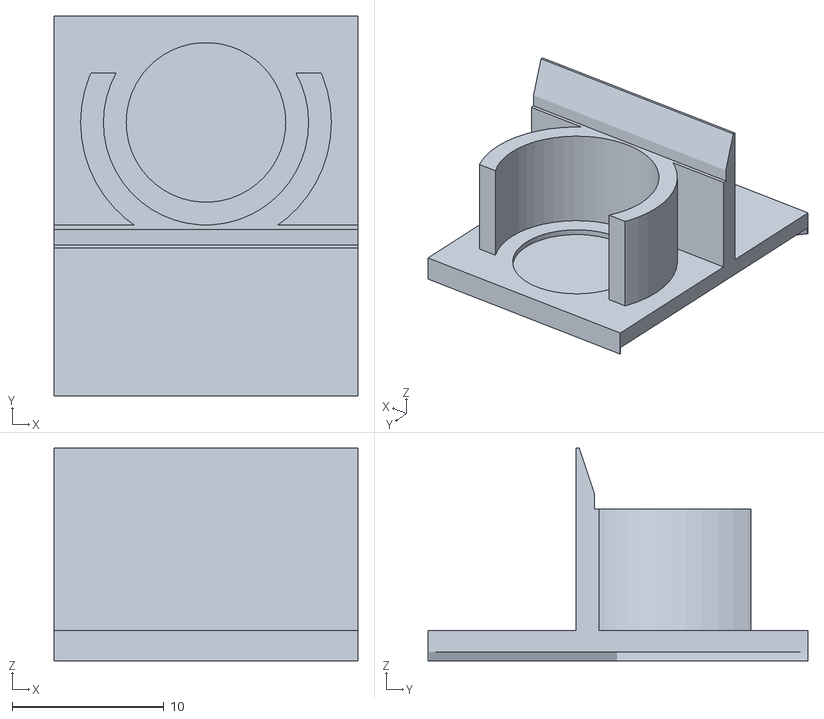
[picture p182: CAD file, 2025-05-16]
stl/train_tail_coupler.stl
20.0 x 25.0 x 14.0
