RailEduKit/SigLab-3Dmodels/stl/number_piece_$fs0_5.stl

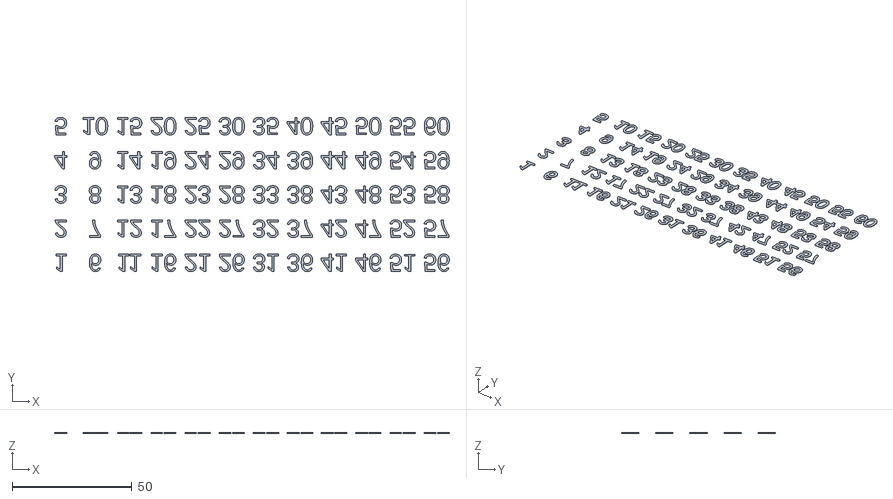
[picture p183: CAD file, 2025-05-16]
stl/number_piece_$fs0_5.stl
164.7 x 64.4 x 0.6
