RailEduKit/SigLab-3Dmodels/stl/number_plate_$fs0_5.stl

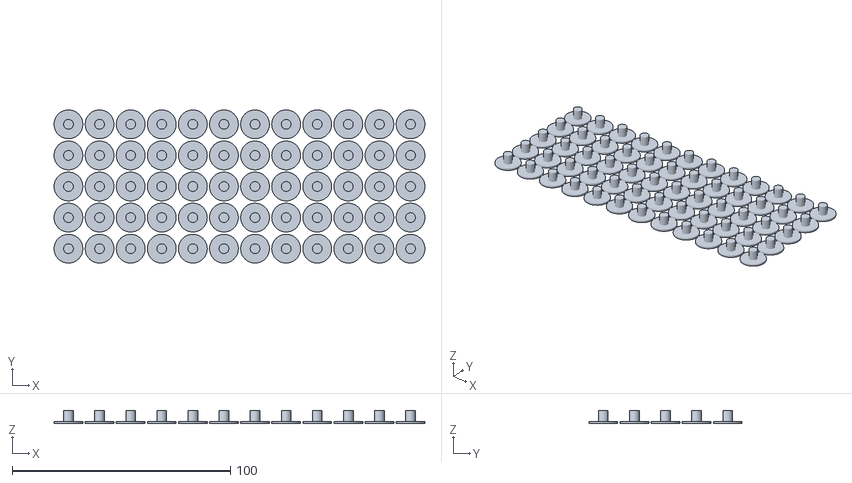
[picture p184: CAD file, 2025-05-16]
stl/number_plate_$fs0_5.stl
170.0 x 70.2 x 6.00
