RailEduKit/SigLab-3Dmodels/stl/number_plate_$fn25.stl

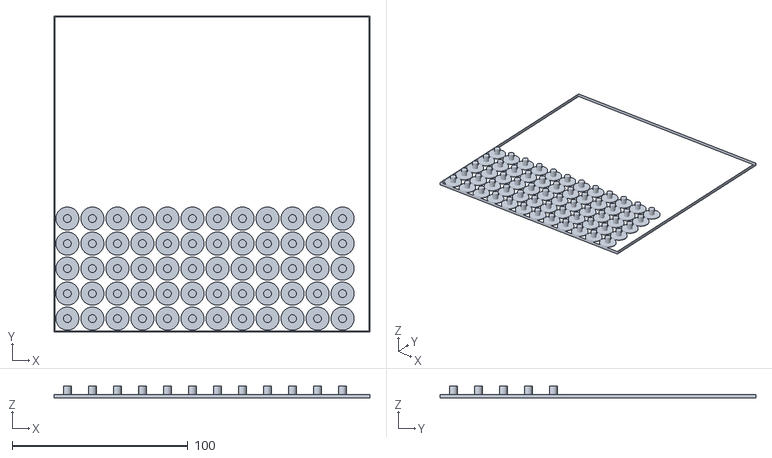
[picture p185: CAD file, 2025-05-16]
stl/number_plate_$fn25.stl
180.0 x 180.0 x 7.00
