RailEduKit/SigLab-3Dmodels/stl/train_headlight_symbol.stl

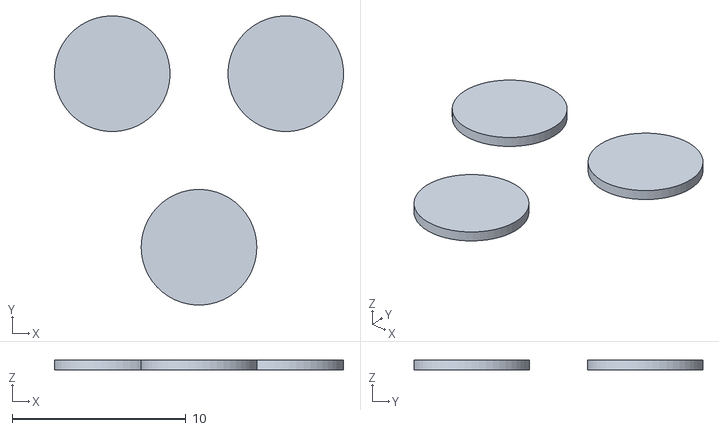
[picture p186: CAD file, 2025-05-15]
stl/train_headlight_symbol.stl
16.7 x 16.7 x 0.6
