RailEduKit/SigLab-3Dmodels/stl/route_clearing_point.stl

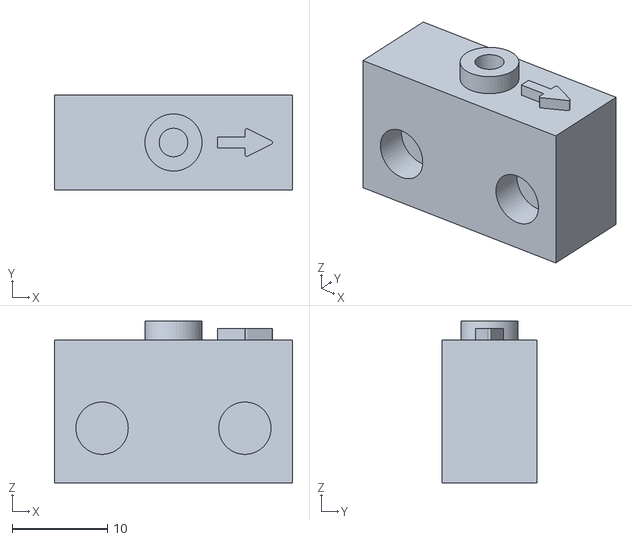
[picture p187: CAD file, 2025-05-15]
stl/route_clearing_point.stl
25.0 x 10.0 x 17.0
