RailEduKit/SigLab-3Dmodels/stl/routeSignal.stl

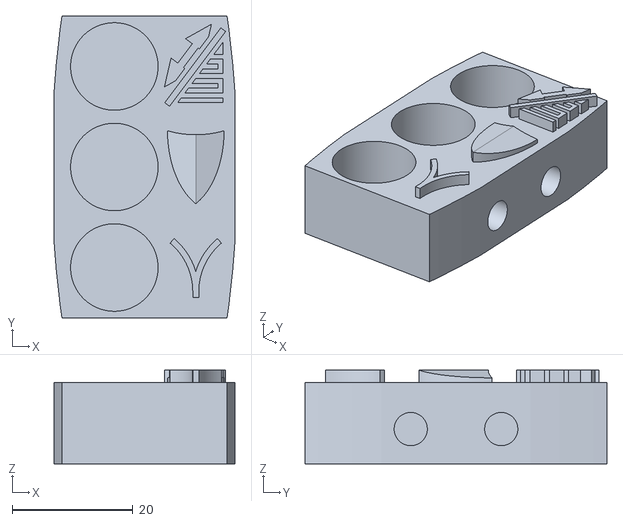
[picture p188: CAD file, 2025-05-15]
stl/routeSignal.stl
30.0 x 50.0 x 15.5
