RailEduKit/SigLab-3Dmodels/stl/color_block-distant.stl

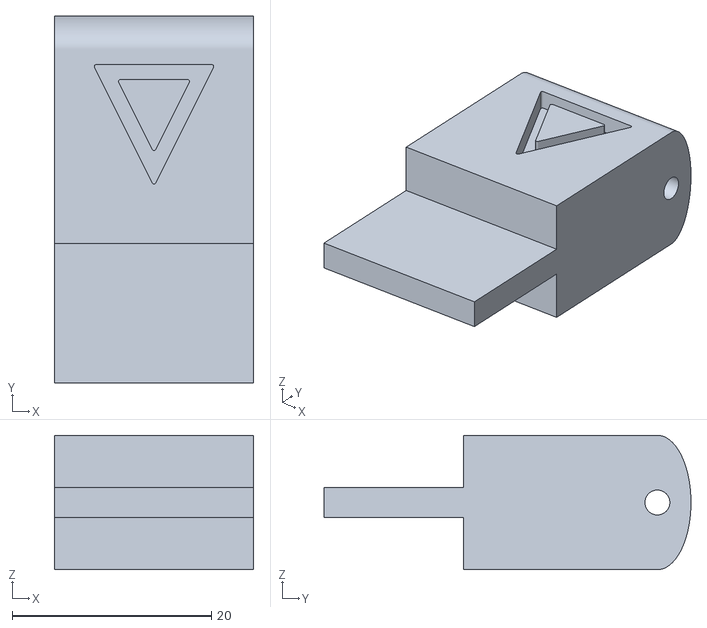
[picture p189: CAD file, 2025-05-15]
stl/color_block-distant.stl
20.0 x 36.9 x 13.5
