RailEduKit/SigLab-3Dmodels/stl/signal_body-distant.stl

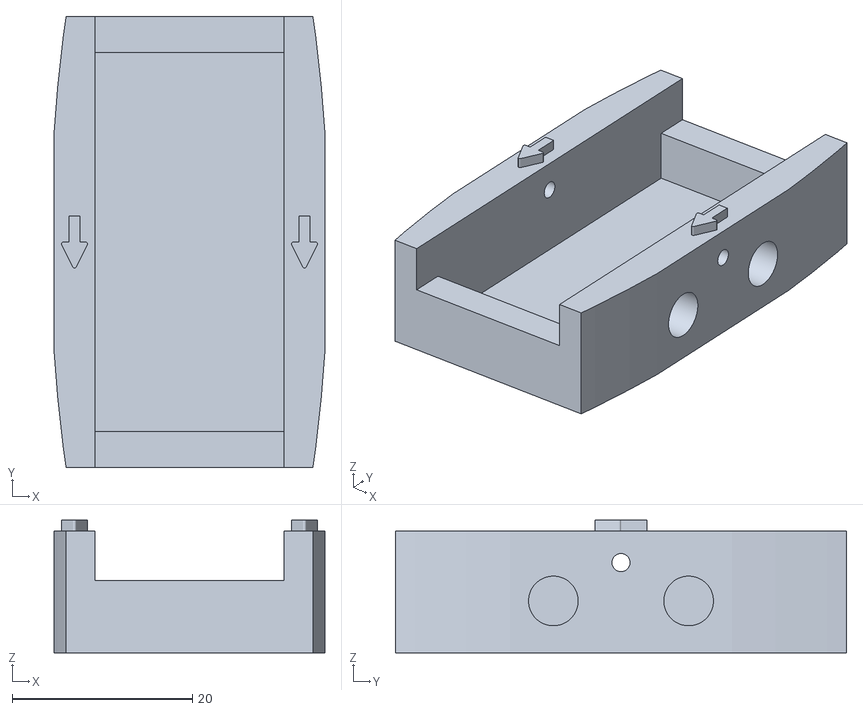
[picture p190: CAD file, 2025-05-15]
stl/signal_body-distant.stl
30.0 x 50.0 x 14.7
