RailEduKit/SigLab-3Dmodels/stl/drill_template_inner_curve.stl

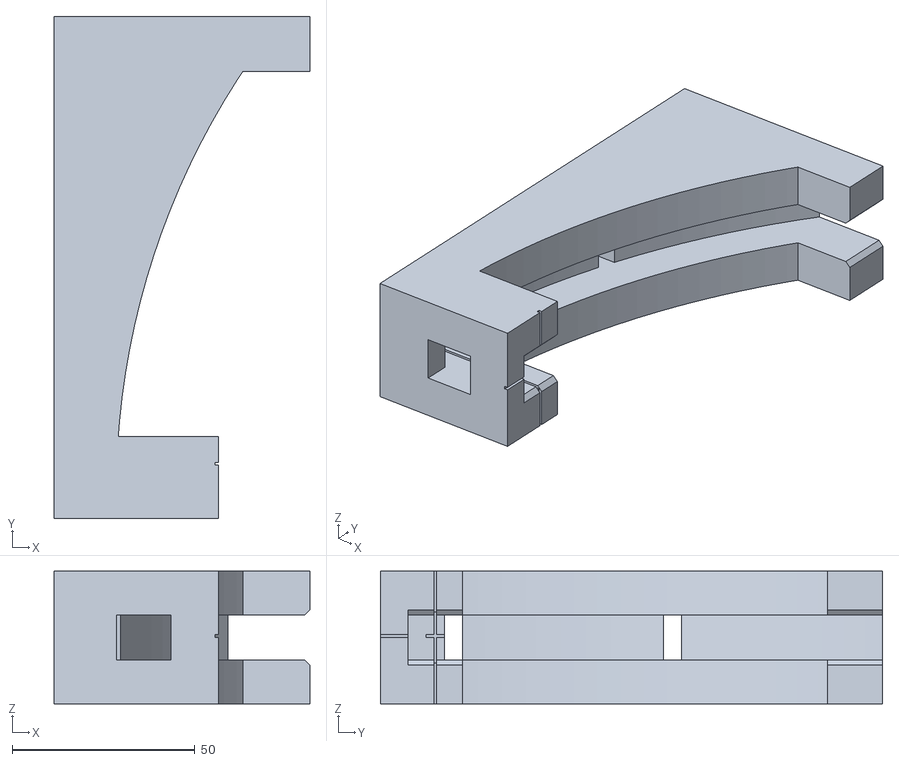
[picture p191: CAD file, 2025-05-15]
stl/drill_template_inner_curve.stl
70.0 x 137.5 x 36.3
