RailEduKit/SigLab-3Dmodels/stl/drill_template_straight.stl

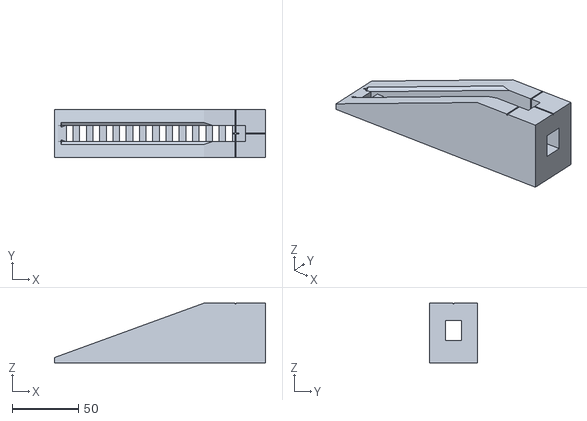
[picture p192: CAD file, 2025-05-15]
stl/drill_template_straight.stl
159.0 x 36.3 x 45.0
