RailEduKit/SigLab-3Dmodels/stl/drill_template_outer_curve.stl

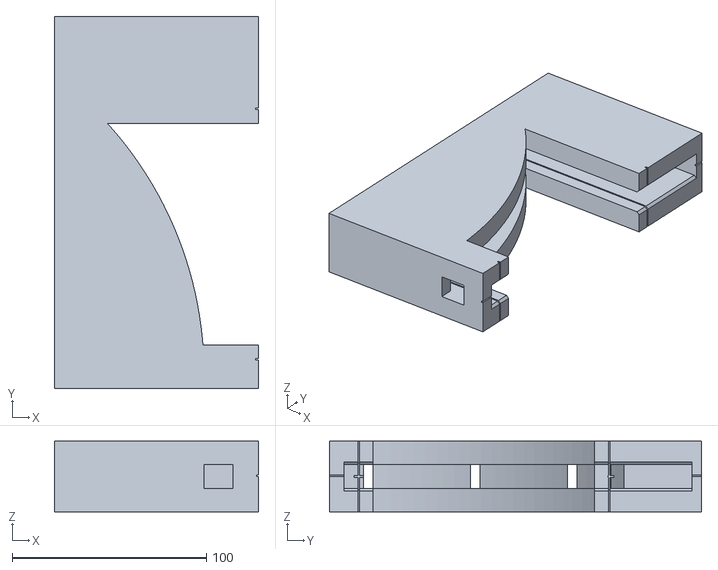
[picture p193: CAD file, 2025-05-15]
stl/drill_template_outer_curve.stl
105.0 x 191.5 x 36.3
