RailEduKit/SigLab-3Dmodels/stl/switch_blade.stl

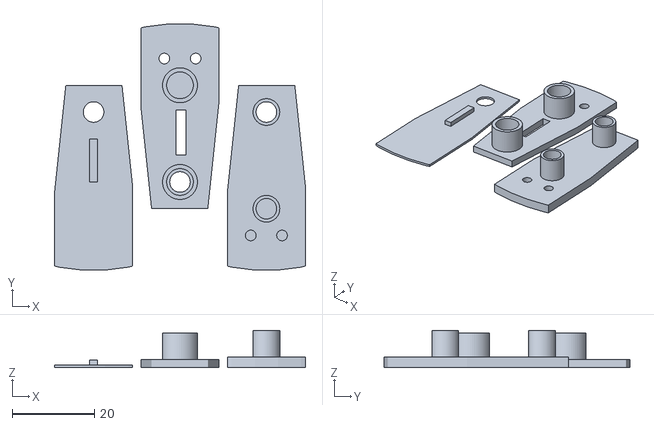
[picture p194: CAD file, 2025-03-12]
stl/switch_blade.stl
61.0 x 59.8 x 9.00
