RailEduKit/SigLab-3Dmodels/stl/magnet_rod_round.stl

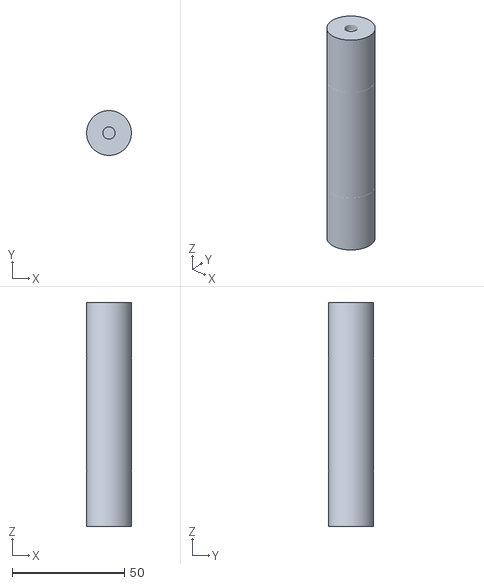
[picture p195: CAD file, 2025-03-12]
stl/magnet_rod_round.stl
20.0 x 20.0 x 100.0
