RailEduKit/SigLab-3Dmodels/stl/magnet_rod_oval.stl

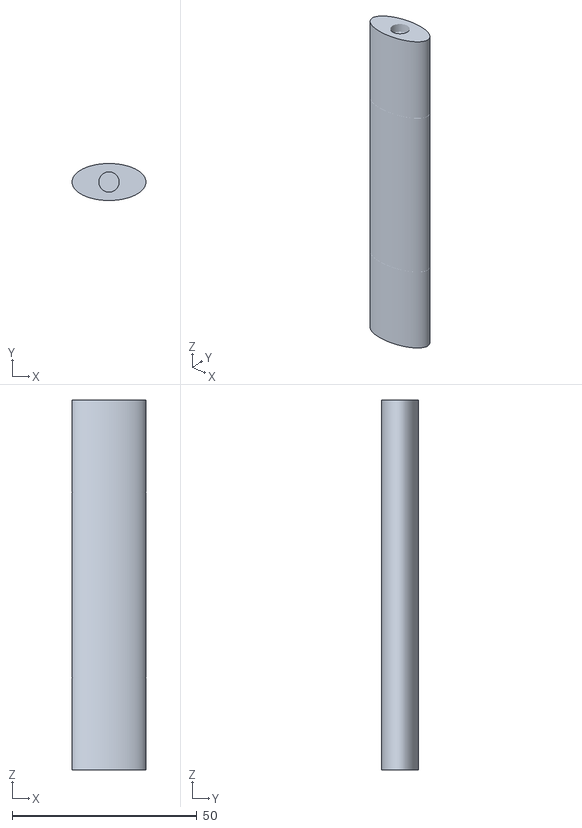
[picture p196: CAD file, 2025-03-12]
stl/magnet_rod_oval.stl
20.0 x 10.0 x 100.0
