RailEduKit/SigLab-3Dmodels/stl/locking_pin.stl

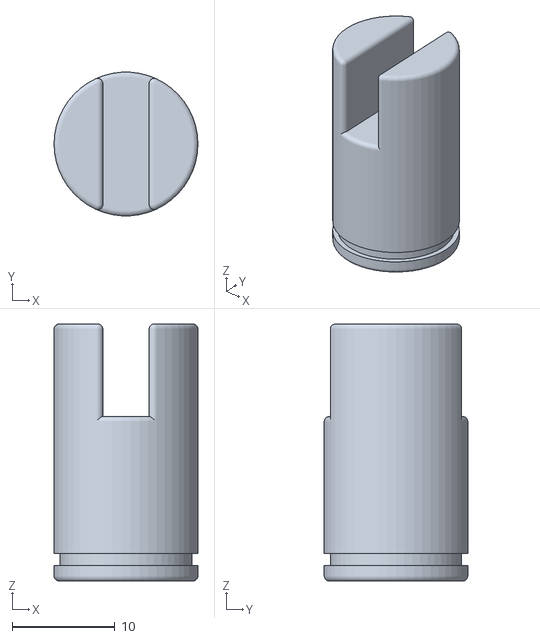
[picture p197: CAD file, 2025-03-12]
stl/locking_pin.stl
14.0 x 14.0 x 25.0
