RailEduKit/SigLab-3Dmodels/(list of files, cad)

Other CAD files:
stl/color_block-main-without color borders.stl
stl/overlap_body_straight_test-s_45-f_2.stl
stl/overlap_body_straight_test-s_65-f_4.stl
stl/train_headlight_coupler.stl
stl/block_clearing_point.stl
scad/assemblies/locking_pin.scad
scad/parts/pin_hole.scad
scad/balise.scad
scad/drill_template_curve.scad
scad/signal_distant.scad
scad/track_curve.scad
scad/track_straight.scad
_assets/scad/coupler.scad
_assets/scad/curve.scad
_assets/scad/roadCheckbox.scad
_assets/scad/specification_of_components.scad
_assets/scad/straight.scad
scad/assemblies/balise.scad
scad/assemblies/checkbox_route.scad
scad/assemblies/clearing_point.scad
scad/assemblies/clearing_point_block.scad
scad/assemblies/clearing_point_route.scad
scad/assemblies/direction_management.scad
scad/assemblies/direction_management_box.scad
scad/assemblies/direction_management_lever.scad
scad/assemblies/number_plate.scad
scad/assemblies/overlap_body_curve.scad
scad/assemblies/overlap_body_straight.scad
scad/assemblies/position_indicator_number.scad
scad/assemblies/position_indicator_plate.scad
scad/assemblies/signal_block.scad
scad/assemblies/signal_box_block.scad
scad/assemblies/signal_box_distant.scad
scad/assemblies/signal_lever_block.scad
scad/assemblies/signal_lever_distant.scad
scad/assemblies/signal_route.scad
scad/assemblies/train_integrity.scad
scad/assemblies/train_integrity_symbol_rear.scad
scad/config/colors.scad
scad/config/global_variables.scad
scad/instructions/checkbox_route-polarity.scad
scad/instructions/clearing_point_block-polarity.scad
scad/instructions/clearing_point_route-polarity.scad
scad/instructions/signal_block-polarity.scad
scad/instructions/signal_distant-polarity.scad
scad/instructions/track_curve-polarity.scad
scad/instructions/track_straight-polarity.scad
scad/jigs/drill_template_inner_curve.scad
scad/jigs/drill_template_outer_curve.scad
scad/jigs/drill_template_straight.scad
scad/jigs/horizontal_template_curve.scad
scad/jigs/magnet_rod.scad
scad/jigs/switch_blade.scad
scad/jigs/switch_body.scad
scad/jigs/track_curve.scad
scad/jigs/track_straight.scad
scad/parts/checkbox_symbols_route.scad
scad/parts/magnet_hole.scad
scad/parts/signal_box.scad
_assets/scad/switch_blade_optimized.scad
scad/parts/signal_symbols.scad
scad/parts/symmetrical_connector.scad
scad/parts/track_indicator_curve.scad
scad/parts/track_indicator_flexible.scad
scad/parts/track_indicator_straight.scad
scad/parts/train_integrity_body.scad
scad/test_code.scad
scad/test_magnets.scad
scad/test_overlap_pattern.scad
scad/test_pins.scad
scad/views/direction_management.scad
scad/views/direction_management_all_positions.scad
scad/views/direction_management_with_locker.scad
scad/views/overlap_curve.scad
scad/views/overlap_straight.scad
scad/views/signal_block.scad
scad/views/signal_block_all_positions.scad
scad/views/signal_block_with_locker.scad
scad/views/signal_distant.scad
scad/views/signal_distant_all_positions.scad
scad/views/signal_route.scad
scad/views/signal_route_all_positions.scad
scad/views/train_integrity_front.scad
scad/views/train_integrity_rear.scad
