RailEduKit/SigLab-3Dmodels/documentation/construction.md

+++
title = "SigLab construction overview"
+++

# Construction

## Material List

## Instruction For Components

~~~ 
<div style="display: grid; grid-template-columns: 1fr 1fr; gap: 1em;">
<!-- Zeile 1 -->
<div>

~~~

### \figenvLink{Main Signal}{/assets/images/test_picture-main_signal.png}{width:75%}{/instruction_for_components/construction-main_signal/}

~~~
</div>

<div>

~~~

The signal term can be changed by flipping the color\_block. The red signal term can be locked with the [Locking Pin](/instruction_for_components/construction-locking_pin/).

~~~
</div>
</div>
~~~

<!-- 
## new title

\tableinput{Component,Description}{/instruction_for_components/components-overview.csv}

### \figenvLink{Main Signal}{/assets/images/test_picture-main_signal.png}{width:50%}{/instruction_for_components/construction-main_signal/} The signal term can be cahnged by flipping the color_block. The red signal term can be locked with the [Locking Pin](/instruction_for_components/construction-locking_pin/).
* **[Main Signal](/instruction_for_components/construction-main_signal/)**
* **[Locking](/instruction_for_components/construction-locking_pin/)**

[Locking Pin](/instruction_for_components/construction-locking_pin/)

-->
