RailEduKit/SigLab-3Dmodels/documentation/instruction_for_components/construction-locking_pin.md

+++
title = "SigLab locking pin"
+++

# Instruction Locking Pin
