RailEduKit/SigLab-3Dmodels/documentation/instruction_for_components/construction-magnet_rod.md

+++
title = "SigLab magnet rod"
+++

# Instruction Magnet Rod
