RailEduKit/SigLab-3Dmodels/documentation/instruction_for_components/dye-instruction.md

+++
title = "SigLab dye instruction"
+++

# How to dye layer by layer in Bambu Studio

<!--
Schichthöhe und Position im ebenen tool

Workaround, wenn schichthöhe > 8mm ist

>
