RailEduKit/SigLab-3Dmodels/images/renders/overlap_measure_back.png

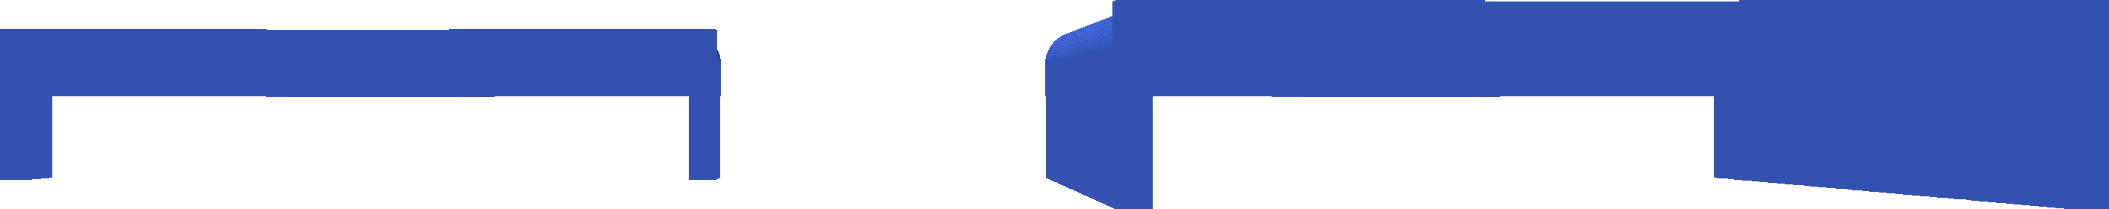
images/renders/overlap_measure_back.png
