RailEduKit/SigLab-3Dmodels/images/renders/overlap_measure_bottom.png

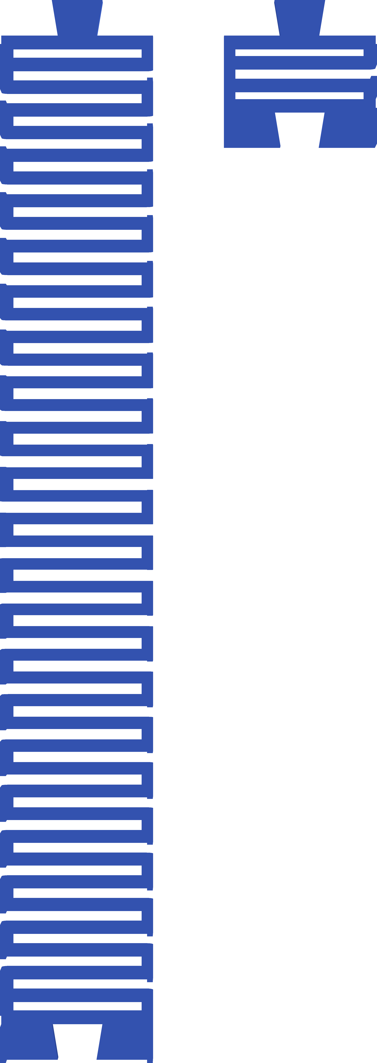
images/renders/overlap_measure_bottom.png
