RailEduKit/SigLab-3Dmodels/images/renders/overlap_measure_front.png

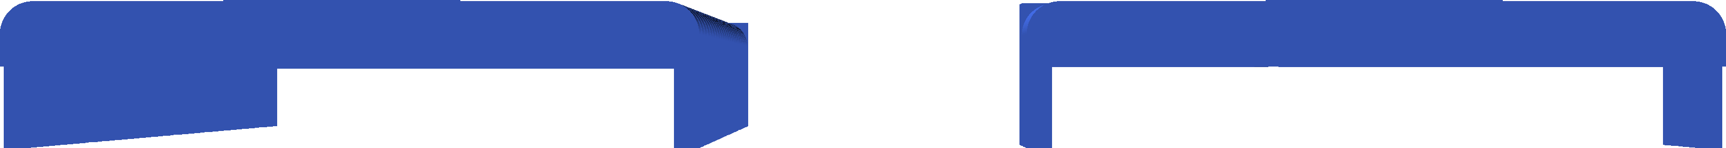
images/renders/overlap_measure_front.png
