RailEduKit/SigLab-3Dmodels/images/renders/overlap_measure_isometric.png

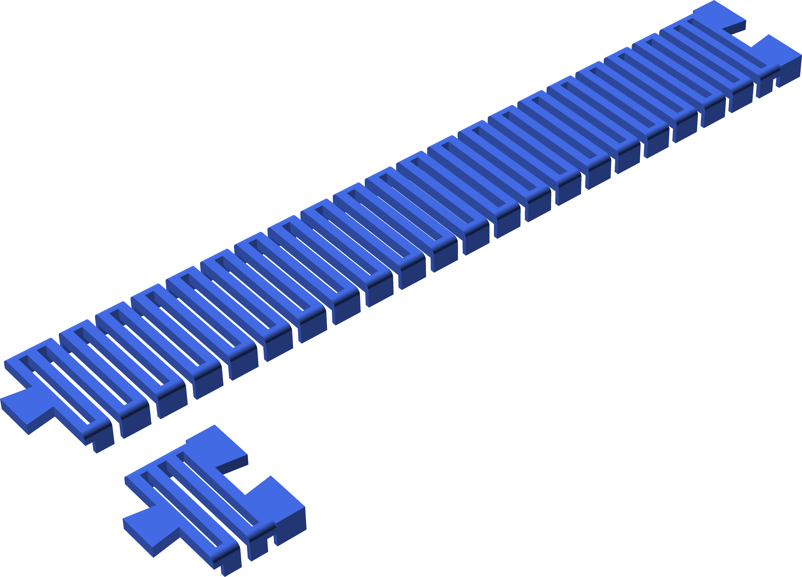
images/renders/overlap_measure_isometric.png
