RailEduKit/SigLab-3Dmodels/images/renders/overlap_measure_left.png

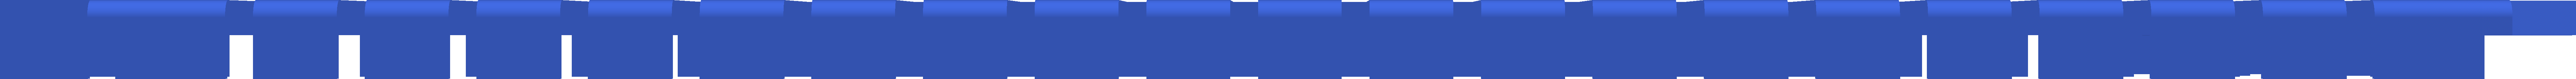
images/renders/overlap_measure_left.png
