RailEduKit/SigLab-3Dmodels/images/renders/overlap_measure_right.png

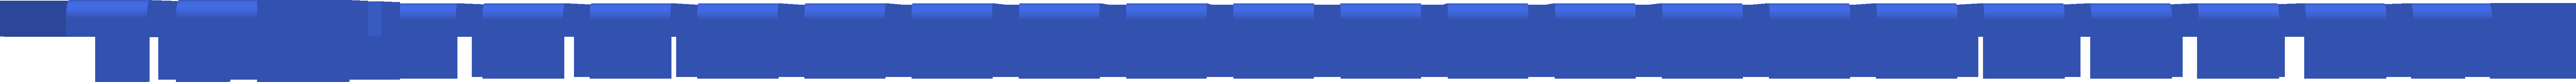
images/renders/overlap_measure_right.png
