RailEduKit/SigLab-3Dmodels/images/renders/overlap_measure_top.png

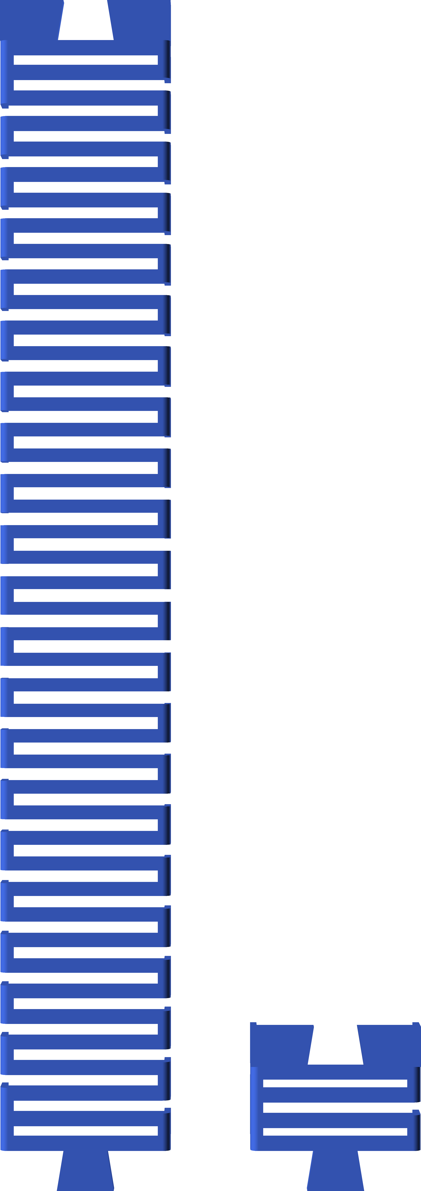
images/renders/overlap_measure_top.png
