RailEduKit/SigLab-3Dmodels/(threads)

Thread 2 (2025-06-06):

change differentiation "component" and "parts" into "part" and "assembly"

kaat0, 2025-06-06:
- [ ] change differentiation "component" and "parts" into "part" and "assembly"

_Originally posted by @j-weck in https://github.com/RailEduKit/SigLab-3Dmodels/issues/1#issuecomment-2943714080_

Thread 6 (2025-06-09):

Give dxf files a home

kaat0, 2025-06-09:
- [ ] this file was created via the switch_body.scad file. It is needed to build the switch. I would keep it in the 3D-Model repo. It is similar to the stl files

_Originally posted by @j-weck in https://github.com/RailEduKit/SigLab-3Dmodels/pull/1#discussion_r2128667358_

AND

_Originally posted by @j-weck in https://github.com/RailEduKit/SigLab-3Dmodels/pull/1#discussion_r2128666919_

kaat0, 2025-06-09:
done with https://github.com/RailEduKit/SigLab-3Dmodels/pull/1/commits/90fadc6fe55f6dbb5c4fb0c1a926ef815ebcce68

Closed 2025-06-09.

Thread 7 (2025-06-09):

Rename route_SIGNAL  to route_checkbox

kaat0, 2025-06-09:
- [ ] why routeSIGNAL? Rename to routeCheckbox

_Originally posted by @j-weck in https://github.com/RailEduKit/SigLab-3Dmodels/pull/1#discussion_r2129133605_

j-weck, 2025-07-21:
the assembly is route Checkbox.

You could create in views a signal_route. This would be the combination of signal_block and the route_checkbox

Thread 9 (2025-06-10):

unify copyright text of all files

kaat0, 2025-06-10:
- [ ] unify copyright text of all files

_Originally posted by @j-weck in https://github.com/RailEduKit/SigLab-3Dmodels/issues/1#issuecomment-2948246762_

Thread 15 (2025-06-18):

Weird cube around the signal_lever_distant in preview mode

j-weck, 2025-06-18:
In the assembly signal_distant appears a random cube around the signal_lever_distant in preview mode.
After rendering the cube disappears.
This bug doesn't happen in the assembly signal_block or in the part signal_lever

Thread 23 (2025-07-10):

Optimize the magnet holes

j-weck, 2025-07-10:
the diameter of the magnet hole is a bit larger than needed. Vertically, the 3D printer can't print a perfect circle. That's why the diameter has to be a bit higher. Currently you need a lot of glue to hold the magnet in the hole.
Find the sweet spot, that the magnet hole is large enough, that the magnet fits in to it, but small enough that the magnet doesn't sit to loose in the hole.

Closed 2025-07-22.

Thread 31 (2025-07-28):

make the pin of the position indidactor clampable

j-weck, 2025-07-28:
The pin will be put in a hole of the tracks. To sit tight, it would be nice to have a clampable pin.

But it shouldnt't sit to tight, so the removal gets difficult.

Thread 33 (2025-07-28):

Make the switch locker more stable

j-weck, 2025-07-28:
Currently, the switch locker can easily tip over. You could make the base thicker or wider to stabilize it.

Thread 35 (2025-07-28):

Create a drill template for the hole in the middle of the straight track

j-weck, 2025-07-28:
Each track part should become a hole for position_indicators and balises. The hole should be in the middle of a track part, if you lay the straight flat on the table.

Thread 36 (2025-07-28):

Create a drill template for the hole in the middle of the curve track

j-weck, 2025-07-28:
Each track part should become a hole for position_indicators and balises. The hole should be in the middle of a track part, if you lay the curve flat on the table.

Thread 37 (2025-07-28):

add space for the switch handle to the drill templates for the magnet holes

j-weck, 2025-07-28:
We will use the mechanical switch of BRIO. If you want to drill holes for the magnets in the switch, you need space for the switch handle in the drill templates.

Thread 45 (2025-08-08):

divide templates in varioation with and without switch add on

j-weck, 2025-08-08:
One can drill magnet holes into the switch, but one doesn't have to. The game would also work without magnets in the switch.
Modify the drill templates, so that you can print a version, where you will not drill holes in the switch (needs much less PLA) or where you can drill holes in the switch (needs much more PLA).

Thread 52 (2025-09-26):

Make the pin Clampable

j-weck, 2025-09-26:
That should make the fit tighter

Thread 54 (2025-10-01):

rotate objects so that they are oriented in the same direction

j-weck, 2025-10-01:
the drive direction goes in the disply along the y axis.
ATTENTION: IF you change a direction check the polarity before and after. It might change. That would be a bad mistake
