RailEduKit/SigLab-3Dmodels/(commit log)

2024-07-01 initial stage
2024-11-15 added scad assets
    [bracket.scad, bracket.stl, coupler.scad, coupler.stl, locking_pin.scad, locking_pin.stl, overlap_measure.scad, signal.scad]
2024-11-19 section comments always one line above the code
    [switch_blade.scad]
2024-11-26 new scad for distant-main_signal
    [distant-main_signal_prototype.scad, switch_blade.scad, switch_blade.stl]
2024-11-26 new pins and first barrier try to lock the signal
    [distant-main_signal_prototype.scad]
2024-11-28 new code concept for switch_blade construction: integrate cap directly in switch_blade
    [distant-main_signal_prototype.scad, switch_blade.scad, switch_blade_by_Julek.scad]
2024-11-28 add a cap to make construction easier
    [switch_blade.scad, switch_blade_by_Julek.scad]
2024-11-28 connecting parts on all four sites handle for easier use
    [distant-main_signal_prototype.scad]
2024-12-02 changed cylinder cotrol in cube control changed screwcap in plugcap
    [distant-main_signal_prototype.scad]
2024-12-03 new connecting pin arrangement stopper to lock signal
    [distant-main_signal_prototype.scad]
2024-12-03 stopper bugfix and add color_blocks
    [distant-main_signal_prototype.scad]
2024-12-05 signal colors closer to the top, less covered stopper higher, handle, square pin main, distant signal symbol
    [distant-main_signal_prototype.scad]
2024-12-10 hole_tolerance for connecting pins two connecting pins for color block new handle for stopper
    [distant-main_signal_prototype.scad]
2024-12-10 adjustment by julek to come closer to the original switch blade
    [switch_blade.scad, switch_blade_by_Julek.scad, switch_blade_by_Julek.stl]
2024-12-19 new scad: switch_body
    [distant-main_signal_prototype.scad, switch_body.scad]
2024-12-19 new signal concept
    [distant-main_signal_wood.scad, switch_body.scad, switch_body.stl]
2025-01-07 signal: Straighten round edge in the middle
    [distant-main_signal_wood.scad]
2025-01-07 subtract elements for all switch configurations
    [switch_body.scad]
2025-01-07 new file for raodCheckbox and sealMarker
    [roadCheckbox.scad, switch_body_double sided rail.stl, switch_body_each side.stl]
2025-01-13 main_signal new dimensions for color block
    [distant-main_signal_wood.scad, switch_body.scad]
2025-01-13 copy of tracklib for overlap
    [overlap_tracklib.scad]
2025-01-13 switch body after test print: made moving area and switchblade space smaller
    [switch_body.scad]
2025-01-13 signal: added symbols
    [distant-main_signal_wood.scad]
2025-01-13 flexible overlap measure
    [overlap_measure.scad, overlap_tracklib.scad]
2025-01-14 new switchblade space
    [switch_body.scad]
2025-01-21 new code for switchblade space
    [switch_body.scad]
2025-01-21 new length for ovlerlap measure
    [overlap_measure.scad, overlap_measure.stl, switch_blade_by_Julek.scad]
2025-01-22 holes and space for blade in one projection
    [switch_body.scad]
2025-01-22 overlap modified the length and added pin
    [distant-main_signal_wood.scad, distant-main_signal_wood.stl, overlap_measure.scad, overlap_measure.stl]
2025-01-28 signal: added mill functions
    [distant-main_signal_wood.scad, switch_body.scad]
2025-01-29 signal: mill and drawing projections
    [distant-main_signal_wood.scad, distant-main_signal_wood.stl, locking_pin.scad]
2025-02-03 signal: the locking space is only at one side
    [distant-main_signal_wood.scad]
2025-02-03 combine signal and switch locking
    [color_block_signal - main.stl, distant-main_signal_wood.stl, locking_pin.scad, locking_pin.stl]
2025-02-06 overlap new pin positions
    [distant-main_signal_wood.scad, locking_pin.stl, overlap_measure.scad, overlap_measure.stl, roadCheckbox.scad]
2025-02-11 new pin dimensions
    [switch_blade_by_Julek.scad]
2025-02-11 renaming of some scad files
    [distant-main_signal.scad, distant-main_signal_deprecated.scad, switch_blade_deprecated.scad, switch_blade_optimized.scad]
2025-02-11 overlap: new track guidance idea
    [distant-main_signal.scad, overlap_measure.scad]
2025-02-11 add one file for all component specifications
    [specification_of_components.scad, switch_blade_optimized.scad, switch_body.scad]
2025-02-11 added to specification and deleted signal locker
    [locking_pin.scad]
2025-02-11 signal: changed move tolerance to 0.5 added to specification file
    [distant-main_signal.scad]
2025-02-11 general move tolerance of 0.5 added locking pin and signal
    [specification_of_components.scad, switch_blade_optimized.scad]
2025-02-11 new locking concept of main signal
    [distant-main_signal.scad, specification_of_components.scad]
2025-02-13 renaming variables, optimized some dimensions
    [FZS_SZS.scad, bcp.stl, distant-main_signal.scad, distant-main_signal.stl, distant-main_signal_deprecated.scad, distant-main_signal_wood.stl, locking_pin.scad, locking_pin.stl]
2025-02-24 heigher locking pin with grip
    [distant-main_signal.scad, locking_pin.scad]
2025-02-24 curve and straight srill template
    [distant-main_signal.stl, drill_template_curve.scad, drill_template_straight.scad, locking_pin.stl, specification_of_components.scad]
2025-02-24 drill template switch
    [drill_template_curve.scad, drill_template_curve.stl, drill_template_curve_less_PLA.stl, drill_template_straight.stl, drill_template_straight_less_PLA.stl, drill_template_switch.scad, drill_template_switch.stl, specification_of_components.scad]
2025-02-25 copied variables to specification file + renaming
    [specification_of_components.scad, switch_body.scad]
2025-02-25 switch blade -> deleted unnecessary move_tolerance
    [switch_blade_optimized.scad]
2025-02-25 adapt the wood dimensions to BRIO renaming
    [specification_of_components.scad, switch_body.scad]
2025-02-26 renaming from wood to rail fixed some values because of the new dimensions rendered all components from specification file -> everything is working now
    [distant-main_signal.scad, drill_template_curve.scad, drill_template_straight.scad, drill_template_switch.scad, locking_pin.scad, specification_of_components.scad, switch_blade_optimized.scad, switch_body.scad]
2025-02-26 switch modification for better fit of switchblade
    [overlap_measure.scad, specification_of_components.scad, switch_blade_optimized.scad, switch_body - 26-02-25.stl, switch_body.scad]
2025-02-27 Clearing_point symbols on the object, not milled
    [FZS_SZS.scad]
2025-02-27 roundedBox from signal to new file
    [basis_component-roundedBox.scad, direction_management.scad, distant-main_signal.scad, roadCheckbox.scad, specification_of_components.scad, switch_body.scad]
2025-03-03 two variations of direction management
    [direction_management.scad]
2025-03-03 added locking pin to signal for visualization
    [distant-main_signal.scad, locking_pin.scad, specification_of_components.scad, switch_blade_optimized.scad]
2025-03-06 new pages for the website
    [direction_management_flipFlop - model.stl, direction_management_onePiece.stl, distant-main_signal.scad]
2025-03-07 structure ideas for construction material list for construction main signal new scad file: magnet_rod
    [color_block-main.stl, components-overview.csv, distant-main_signal.scad, drill_template_straight.stl, magnet_rod.scad, signal_body-main.stl, specification_of_components.scad]
2025-03-10 first instruction - main signal
    [magnet_rod.stl, signal_body-main.stl]
2025-03-10 fixed axis diameter and wrong dimension in handle space
    [color_block-distant.stl, direction_management.scad, distant-main_signal.scad, magnet_rod.scad, magnet_rod.stl, signal_body-distant.stl, signal_body-main.stl, specification_of_components.scad]
2025-03-12 test 180mm radius for curve
    [curve.scad, curve.stl, curve_180mm.stl, curve_shape.dxf, specification_of_components.scad, switch_body.scad]
2025-03-12 new position for color border lines
    [FZS_SZS.scad, block_clearing_point.stl, color_block-distant.stl, color_block-main.stl, distant-main_signal.scad, locking_pin.stl, magnet_rod.scad, magnet_rod.stl]
2025-03-12 drill template add burr
    [drill_template_curve.scad, drill_template_straight.scad, roadCheckbox.scad, road_checkbox.stl]
2025-03-13 curve, straight in SCAD with drill holes
    [curve_180mm_45.7degree.stl, curve_180mm_46degree.stl, drill_template_curve.scad, drill_template_straight.scad, specification_of_components.scad, straight.scad, switch_body.scad]
2025-03-13 horizontal curve template
    [curve.scad, curve.stl, curve_dimensions.FCStd, curve_horizontal_template.stl, drill_template_curve.scad, specification_of_components.scad, straight.scad, straight.stl]
2025-03-24 switch adapt holes_for_blade for new curve radius
    [drill_template_curve.scad, drill_template_inner_curve.stl, drill_template_outer_curve.stl, drill_template_straight.stl, drill_template_switch.scad, drill_template_switch.stl, switch_body.scad]
2025-03-25 new symbol for switch in roadCheckbox
    [roadCheckbox.scad, road_checkbox.stl]
2025-03-25 rounded the switchblade
    [specification_of_components.scad, switch_blade_optimized.scad, switch_body.scad]
2025-03-25 cut through for visualization changed arrow_block
    [direction_management.scad]
2025-03-25 direction_management flipFlop new neutral position
    [direction_management.scad, direction_management.stl, specification_of_components.scad]
2025-03-26 direction_management slight adaptions, V_axis
    [direction_management.scad, direction_management.stl, direction_management_2mm-rounding.stl, direction_management_3mm-rounding.stl]
2025-03-26 create number plates for numbering track parts
    [number.stl, number_plate.scad, number_plate.stl, specification_of_components.scad]
2025-04-04 direction management: set rounding to 2 more space at the bottom of the V axis
    [direction_management.scad, direction_management.stl, drill_template_straight.stl]
2025-04-04 balise file approach for incrementing counter in loop is to slow for rendering
    [balise.scad, number_34.stl, number_plate.scad, number_plate_34.stl, specification_of_components.scad, test_code.scad]
2025-04-07 3D printing notes
2025-04-07 create 60 number plates with julia code
    [number_plate.scad, specification_of_components.scad]
2025-04-24 create code with julia for scad
    [number_plate.scad]
2025-04-24 small changes
    [color_block-main-without color borders.stl, distant-main_signal.scad, magnet_rod.scad, switch_body.scad]
2025-04-24 renaming file FZS_SZS to clearing_point
    [clearing_point.scad]
2025-04-28 improvment of the drill template after first drill
    [drill_template_curve.scad, drill_template_straight.scad, drill_template_straight.stl, roadCheckbox.scad, road_checkbox.stl, specification_of_components.scad, switch_body.scad]
2025-04-28 drill template move tolerance of 0.1
    [drill_template_curve.scad, drill_template_inner_curve.stl, specification_of_components.scad]
2025-04-30 better drill template outer curve
    [distant-main_signal.scad, drill_template_curve.scad, drill_template_inner_curve.stl, drill_template_outer_curve.stl, drill_template_straight.scad, drill_template_straight.stl, drill_template_straight_test-width-0.3mm.stl, drill_template_straight_test-width.stl]
2025-04-30 deleted stl files out of scad folder
    [bcp.stl, bracket.stl, color_block_signal - main.stl, coupler.stl, curve.stl, curve_180mm.stl, curve_180mm_45.7degree.stl, curve_180mm_46degree.stl]
2025-04-30 new triangle for color_block_distant
    [color_block-distant.stl, distant-main_signal.scad, specification_of_components.scad]
2025-05-08 shorten the outer curve template
    [drill_template_curve.scad, drill_template_outer_curve.stl]
2025-05-08 added driving direction arrows
    [block_clearing_point_with arrow.stl, clearing_point.scad, distant-main_signal.scad, route_clearing_point_with arrow.stl, signal_body-distant.stl, signal_body-main.stl, specification_of_components.scad]
2025-05-15 drill template modifications
    [block_clearing_point.stl, clearing_point.scad, color_block-distant.stl, color_block-main.stl, distant-main_signal.scad, drill_template_curve.scad, drill_template_inner_curve.stl, drill_template_outer_curve.stl]
2025-05-15 new position of pin holes -> 30mm instead of 25mm
    [specification_of_components.scad, switch_body.scad]
2025-05-15 coupler design for train tail and headlight
    [coupler.scad, distant-main_signal.scad, train_headlight_coupler.stl, train_headlight_symbol.stl, train_tail_coupler.stl, train_tail_symbol.stl]
2025-05-16 created number plate stls for the first time
    [number_piece_$fs0_5.stl, number_plate.scad, number_plate_$fn25.stl, number_plate_$fs0_5.stl, number_plate_numbers_$fn25.stl]
2025-05-16 deleted move_tolerance in magnethole_d in wood
    [curve.scad, magnet_rod.scad, straight.scad]
2025-05-16 added chamfer at switch and create new DXF files modified drill template switch
    [drill_template_switch.scad, drill_template_switch.stl, switch_body - left.dxf, switch_body - right.dxf, switch_body.scad, test_code.scad, train_tail_coupler.stl, train_tail_symbol.stl]
2025-05-21 commented the chamfer out
    [switch_body - left.dxf, switch_body - right.dxf, switch_body.scad]
2025-06-20 renamed specification_of_components.scad into config.scad
    and moved resolution settings into config.scad
    [balise.scad, basis_component-roundedBox.scad, bracket.scad, clearing_point.scad, config.scad, coupler.scad, curve.scad, direction_management.scad]
2025-06-20 dependencies in local lib folder
    add script to download dependencies for local lib folder
    [curve.scad, direction_management.scad, overlap_measure.scad, straight.scad]
2025-06-20 removed stale files
    [distant-main_signal_deprecated.scad, switch_blade.scad, switch_blade_deprecated.scad, switch_body.scad]
2025-06-20 now using the User Library Path of openscad for dependencies
    [curve.scad, direction_management.scad, overlap_measure.scad, straight.scad, switch_body.scad]
2025-06-20 renamed roadCheckbox into routeSignal
    [routeSignal.scad, routeSignal.stl]
2025-06-20 remove stale files
    [block_clearing_point_with arrow.stl, route_clearing_point_with arrow.stl]
2025-06-20 refactoring and new component folder
    [clearing_point.scad, driving_direction_arrow.scad, magnet_hole.scad]
2025-06-20 new header
    [balise.scad]
2025-06-20 renamed coupler to train_integrity
    [train_integrity.scad]
2025-06-20 renamed curve and straight into track_*
    refactor for common components and new header
    [pin_hole.scad, track_curve.scad, track_straight.scad]
2025-06-20 improved render_openscad.jl
    added install_dependencies, cleanup_stale_files, moved render_log, width and height now start wirg img-*, fixed running issue wirh OpenSCAD 2021
2025-06-20 first reordering of signal parts
    [basis_component-roundedBox.scad, distant-main_signal.scad, driving_direction_arrow.scad, routeSignal.scad, signal.scad, signal_block.scad, signal_box.scad, signal_distant.scad]
2025-06-20 renaming and new header
    [config.scad]
2025-06-20 remove stale file
    [bracket.scad]
2025-06-20 switch to shell instead of julia
2025-06-20 new header and moving components
    [direction_management.scad]
2025-06-20 moved scad files
    [balise.scad, clearing_point.scad, config.scad, direction_management.scad, drill_template_curve.scad, drill_template_straight.scad, drill_template_switch.scad, driving_direction_arrow.scad]
2025-06-20 moved stl files
    [block_clearing_point.stl, color_block-distant.stl, color_block-main-without color borders.stl, color_block-main.stl, drill_template_inner_curve.stl, drill_template_outer_curve.stl, drill_template_straight.stl, drill_template_switch.stl]
2025-06-20 moved documentation
    [components-overview.csv]
2025-06-20 splitting config values
    [balise.scad, clearing_point.scad, colors.scad, direction_management.scad, global_variables.scad, signal_block.scad, signal_box.scad, signal_distant.scad]
2025-06-20 enforced formatting with clang-formatter
    [balise.scad, clearing_point.scad, colors.scad, direction_management.scad, drill_template_curve.scad, drill_template_straight.scad, drill_template_switch.scad, driving_direction_arrow.scad]
2025-06-20 reorganized scad-folder
    [balise.scad, clearing_point.scad, direction_management.scad, drill_template_curve.scad, drill_template_straight.scad, drill_template_switch.scad, driving_direction_arrow.scad, locking_pin.scad]
2025-06-20 renaming "parts" and "assemblies "
    issue #2
    [balise.scad, clearing_point.scad, direction_management.scad, driving_direction_arrow.scad, locking_pin.scad, magnet_hole.scad, number_plate.scad, overlap_measure.scad]
2025-06-20 reinstated files from commit ed9c1e0
    [curve_shape.dxf, switch_body - left.dxf, switch_body - right.dxf]
2025-06-20 renamed "stl" folder
    [block_clearing_point.stl, color_block-distant.stl, color_block-main-without color borders.stl, color_block-main.stl, drill_template_inner_curve.stl, drill_template_outer_curve.stl, drill_template_straight.stl, drill_template_switch.stl]
2025-06-20 signal files: added/ changed include files. Made the symbols visible via a difference.
    [signal_block.scad, signal_box.scad, signal_distant.scad, signal_lever.scad]
2025-06-20 Added incluedes and updated filpaths
    [clearing_point.scad, direction_management.scad, track_curve.scad]
2025-06-20 indentation change
    [drill_template_curve.scad]
2026-03-23 moved also varables to signal_lever and signal_symbols. Currently all files which includes signal_box are working
    [direction_management_box.scad, direction_management_lever.scad, driving_direction_arrow.scad, global_variables.scad, signal_symbols.scad]
2026-03-23 views of following models are working again direction_management signal_block signal_route signal_distant
    [direction_management.scad, global_variables.scad, locking_pin.scad, signal_block.scad, signal_distant.scad, signal_route.scad]
2026-03-24 arranged file_relations and moved magnet variables out of global_variables
    [global_variables.scad, magnet_hole.scad, magnet_rod.scad, signal_box.scad, speed_controller.scad]
2026-03-24 moved locking_pin variables out of global_variable
    [checkbox_route.scad, checkbox_symbols_route.scad, direction_management.scad, direction_management_box.scad, direction_management_lever.scad, global_variables.scad, locking_pin.scad, signal_block.scad]
2026-03-30 speed_controller stl with the new magnet dimension
    [speed_controller.stl]
2026-03-30 generated speed controller pictures
    [speed_controller.scad]
2026-03-31 moved variables out of global variables from position indicator switch locker switch blade magnet rod switch body
    [balise.scad, global_variables.scad, magnet_rod.scad, overlap_bar.scad, position_indicator_number.scad, position_indicator_plate.scad, switch_blade.scad, switch_body.scad]
2026-03-31 moved switch_blade into jigs
    [switch_blade.scad]
2026-03-31 moved variables out of global variables to signal box track curve track straight
    [checkbox_route-polarity.scad, checkbox_symbols_route.scad, direction_management.scad, direction_management_all_positions.scad, global_variables.scad, pin_hole.scad, polarity_indicator.scad, signal_block-polarity.scad]
2026-03-31 moved variables out of global variables to drill_template_curve drill_template_straight
    [drill_template_curve.scad, drill_template_straight.scad, drill_template_switch.scad, global_variables.scad]
2026-03-31 drill templates: one file for each stl
    [drill_template_inner_curve.scad, drill_template_outer_curve.scad, horizontal_template_curve.scad, templates_curve_construction.scad]
2026-03-31 deleted old structure in global variables
    [global_variables.scad]
